harp-tech/device.behavior/Hardware/Mechanical/README.md

## Harp Behavior Mechanical Files
Each folder contains the mechanical designs for each PCB version.

## PCB compatibility

| Folder name			| PCB version		| Notes				|
|---|---|---|
| **case_v1.1_v1.2**	| 1.1 and 1.2		|					|
| **case_v2.0** 	| 2.0 		|					|

## Licensing ##

<br />This work is licensed under a <a rel="license" href="http://creativecommons.org/licenses/by-sa/4.0/">Creative Commons Attribution-ShareAlike 4.0 International License</a>
