harp-tech/device.behavior/docs/apidoc/Harp_Behavior_CreateCamera0FrequencyPayload.md

---
uid: Harp.Behavior.CreateCamera0FrequencyPayload
---

### Configure trigger frequency

:::workflow
Configure trigger frequency
:::
