harp-tech/device.behavior/docs/apidoc/Harp_Behavior_CreateDisableServosPayload.md

---
uid: Harp.Behavior.CreateDisableServosPayload
---

### Enable and disable servos

:::workflow
Enable and disable servos
:::
