harp-tech/device.behavior/docs/apidoc/Harp_Behavior_CreatePulseSupplyPort0Payload.md

---
uid: Harp.Behavior.CreatePulseSupplyPort0Payload
---

### Deliver rewards

:::workflow
Deliver rewards
:::
