harp-tech/device.behavior/docs/apidoc/Harp_Behavior_EnableEncoders.md

---
uid: Harp.Behavior.EnableEncoders
---

### Enable the encoder

:::workflow
Enable the encoder
:::
