harp-tech/device.behavior/docs/apidoc/Harp_Behavior_Led0Current.md

---
uid: Harp.Behavior.Led0Current
---

### Configure LED current

:::workflow
Configure LED current
:::
