harp-tech/device.behavior/docs/apidoc/Harp_Behavior_Led0MaxCurrent.md

---
uid: Harp.Behavior.Led0MaxCurrent
---

### Configure LED current

:::workflow
Configure LED current
:::
