harp-tech/device.behavior/docs/apidoc/Harp_Behavior_Led1Current.md

---
uid: Harp.Behavior.Led1Current
---

### Configure LED current

:::workflow
Configure LED current
:::
