harp-tech/device.behavior/docs/apidoc/Harp_Behavior_MimicPort2Valve.md

---
uid: Harp.Behavior.MimicPort2Valve
---

### Enable poke valve mimic

:::workflow
Enable poke valve mimic
:::
