harp-tech/device.behavior/docs/apidoc/Harp_Behavior_PwmStop.md

---
uid: Harp.Behavior.PwmStop
---

### Start and stop PWM

:::workflow
Start and stop PWM
:::
