harp-tech/device.behavior/docs/apidoc/Harp_Behavior_ServoMotor3Pulse.md

---
uid: Harp.Behavior.ServoMotor3Pulse
---

### Configure the servo

:::workflow
Configure the servo
:::

### Adjust the position

:::workflow
Adjust the position
:::
