harp-tech/device.behavior/docs/articles/control-leds.md

# Control LEDs

The Behavior device controls two kinds of light output: conventional LEDs on the **L0** and **L1** connectors and addressable RGB LEDs on the **RGB** connector. Refer to the [LED connection](./ports-connections.md?tabs=led#connections) section to set up a conventional LED on **L0** and the [RGB LED connection](./ports-connections.md?tabs=rgb-led#connections) section to set up two addressable RGB LEDs on the **RGB** connector. We will use these ports for the rest of these examples.

This article covers configuring the LED current, setting RGB colors, and turning on both kinds of LED in Bonsai.

The complete workflow is shown below. Copy and paste it into Bonsai to get started immediately, or build each section by following the step-by-step instructions in the following sections.

:::workflow
Control LEDs
:::

## Configure LED current

The **L0** and **L1** outputs supply conventional LEDs with a configurable constant current, so no series resistor is needed. Each output line has a working current and protection limit register (e.g. [`Led0Current`] and [`Led0MaxCurrent`] for **L0**) that are set before turning on the LED. Set the protection limit to the LED's rated current first, then adjust the working current to change the brightness of the LED.

:::workflow
Configure LED current
:::

- Insert a [`KeyDown`] operator and set the `Filter` property to `A`.
- Insert a [`CreateMessage`] operator and configure the following properties:
    - `Payload` - Select `Led0MaxCurrentPayload`.
    - `Led0MaxCurrent` - Set the maximum allowed current according to the rating of the LED in mA (e.g. `20`). Valid values are 5–100 mA.
- Insert a [`MulticastSubject`] operator named `Behavior Commands`.
- Insert a [`CreateMessage`] operator and configure the following properties:
    - `Payload` - Select `Led0CurrentPayload`.
    - `Led0Current` - Set the working current in mA (e.g. `10`). Valid values are 2–100 mA.
- Insert a [`MulticastSubject`] operator named `Behavior Commands`.

Run the workflow and press <kbd>A</kbd> to configure the **L0** supply current, then switch the output on as shown in the next section.

> [!NOTE]
> Commands that adjust the working current above the protection limit will be rejected by the device. The Bonsai workflow will terminate with a runtime error that describes an "erroneous write command". Lower the working current or raise the protection limit, then restart the workflow.

## Turn LEDs on and off

Once the current is configured, the **L0** and **L1** outputs are controlled like any other digital output (see [Control digital outputs](control-digital-outputs.md)), for instance through the [`OutputSet`] and [`OutputClear`] registers:

:::workflow
Turn LEDs on and off
:::

- Insert a [`KeyDown`] operator and set the `Filter` property to `S`.
- Insert a [`CreateMessage`] operator and configure the following properties:
    - `Payload` - Select `OutputSetPayload`.
    - `OutputSet` - Select the line to turn on (e.g. `Led0`).
- Insert a [`MulticastSubject`] operator named `Behavior Commands`.

In a separate branch:

- Insert a [`KeyDown`] operator and set the `Filter` property to `D`.
- Insert a [`CreateMessage`] operator and configure the following properties:
    - `Payload` - Select `OutputClearPayload`.
    - `OutputClear` - Select the line to turn off (e.g. `Led0`).
- Insert a [`MulticastSubject`] operator named `Behavior Commands`.

Run the workflow, then press <kbd>S</kbd> to turn on the LED and <kbd>D</kbd> to turn it off.

## Set RGB colors

When configuring and controlling the addressable RGB LEDs; **Rgb0** refers to the first LED in the chain and **Rgb1** the second. The [`RgbAll`] register writes the color of both RGB LEDs in one command. Each channel takes an intensity from 0 to 255.

:::workflow
Set RGB colors
:::

- Insert a [`KeyDown`] operator and set the `Filter` property to `F`.
- Insert a [`CreateMessage`] operator and configure the following properties:
    - `Payload` - Select `RgbAllPayload`.
    - `Red0` - Set the intensity value for the red channel on **Rgb0** (e.g. `255`).
    - `Blue1` - Set the intensity value for the blue channel on **Rgb1** (e.g. `255`).
- Insert a [`MulticastSubject`] operator named `Behavior Commands`.

Run the workflow and press <kbd>F</kbd> to load the color and intensity configuration. If the LEDs are currently on, the new configurations take effect immediately. If not, when you turn them on in the next section, **Rgb0** should display red and **Rgb1** should be blue.

> [!NOTE]
> To configure one LED at a time, select [`Rgb0`] for the first LED or [`Rgb1`] for the second LED under the `Payload` property in the [`CreateMessage`] operator.

## Turn RGB LEDs on and off

The RGB LEDs are controlled like any other digital output (see [Control digital outputs](control-digital-outputs.md)), for instance through the [`OutputSet`] and [`OutputClear`] registers:

:::workflow
Turn RGB LEDs on and off
:::

- Insert a [`KeyDown`] operator and set the `Filter` property to `G`.
- Insert a [`CreateMessage`] operator and configure the following properties:
    - `Payload` - Select `OutputSetPayload`.
    - `OutputSet` - Set the lines to turn on (e.g. `Rgb0, Rgb1`).
- Insert a [`MulticastSubject`] operator named `Behavior Commands`.

In a separate branch:

- Insert a [`KeyDown`] operator and set the `Filter` property to `H`.
- Insert a [`CreateMessage`] operator and configure the following properties:
    - `Payload` - Select `OutputClearPayload`.
    - `OutputClear` - Set the lines to turn off (e.g. `Rgb0, Rgb1`).
- Insert a [`MulticastSubject`] operator named `Behavior Commands`.

Run the workflow, then press <kbd>G</kbd> to turn on both RGB LEDs and <kbd>H</kbd> to turn them off.

[!INCLUDE [](../includes/version-footer.md)]

<!--Reference Style Links -->
[`KeyDown`]: xref:Bonsai.Windows.Input.KeyDown
[`CreateMessage`]: xref:Harp.Behavior.CreateMessage
[`MulticastSubject`]: xref:Bonsai.Expressions.MulticastSubject
[`RgbAll`]: xref:Harp.Behavior.RgbAll
[`Rgb0`]: xref:Harp.Behavior.Rgb0
[`Rgb1`]: xref:Harp.Behavior.Rgb1
[`Led0Current`]: xref:Harp.Behavior.Led0Current
[`Led1Current`]: xref:Harp.Behavior.Led1Current
[`Led0MaxCurrent`]: xref:Harp.Behavior.Led0MaxCurrent
[`OutputSet`]: xref:Harp.Behavior.OutputSet
[`OutputClear`]: xref:Harp.Behavior.OutputClear
