harp-tech/device.behavior/docs/articles/ports-connections.md

# Ports and connections

This article covers the ports on the Behavior device, as well as how to connect the device to peripherals and external devices.

## Ports

Harp Behavior device pinout

**12V PWR (Barrel Jack)** - This port powers the Behavior device and requires a 12 V power supply.

**USB (USB-C)** - This port connects the device to the control computer running [Bonsai](bonsai.md) or the [Behavior app](./behavior-app.md).

**CLKIN (Stereo Jack)** - This [Harp](https://harp-tech.org/articles/about.html) clock input accepts a clock output from any compatible Harp clock generator or synchronizer (e.g. [Harp Timestamp Generator](https://github.com/harp-tech/device.timestampgeneratorgen3)) for synchronization with other connected devices.

**STATE** - This status LED cycles on and off with a period of:
- 2 seconds when it's communicating with Bonsai
- 4 seconds when in standby
- 100 milliseconds when a catastrophic error occurs

**P0, P1, P2 (RJ45)** - These poke ports interface directly with the [Mice Poke](./peripherals/micepoke.md) peripheral for poke detection and reward delivery. Alternatively, use the [Breakout](./peripherals/breakout.md) board to interface with other accessories. Port **P2** also has a quadrature counter for [rotation tracking](track-rotary-encoder.md). Use it with the [Rotary Encoder](./peripherals/rotaryencoder.md) peripheral, or with a quadrature encoder connected through the Breakout board.

**ADC (Screw Terminal)** - This connector carries the first analog input (**AD0**), a 5 V supply pin and two ground connections.

**Output (Screw Terminal)** - These general-purpose 5 V digital outputs can be used to communicate with external devices. **DO0**/**DO1** can generate [camera triggers](trigger-cameras.md) and **DO2**/**DO3** can control [servo motors](control-servo-motors.md); all four support [PWM](generate-pwm.md).

**Input (Screw Terminal)** - This connector carries the second analog input (**AD1**), the digital input **DI3** and one ground connection.

**RGB (3-pin Flick Lock)** - Connector for up to two  addressable RGB LEDs (WS2812-type, e.g., NeoPixels). The LEDs are controlled as a serial chain on a single data line, with colors set with the [RGB registers](control-leds.md#set-rgb-colors).

**L0, L1 (Screw Terminal)** - These connectors control two conventional single-color LED outputs. Each terminal pair is marked **A** (anode, the LED's long leg) and **K** (cathode, the short leg). The output current is [configurable](control-leds.md) from 2 to 100 mA.

## Connections

# [Analog input](#tab/analoginput)

Analog input

1. Wire the analog signal (0–5 V) to either **AD0** on the **ADC** connector or **AD1** on the **Input** connector.
2. Connect the ground wire to any **GND** pin.
3. Refer to the [Acquire analog data](acquire-analog-data.md) article to read the signal in Bonsai.

# [Digital input](#tab/digitalinput)

Digital input

1. Wire the digital signal (5 V) to **DI3** on the **Input** connector. Alternatively, use the [Breakout](./peripherals/breakout.md) board to access more digital inputs on the poke ports.
2. Connect the ground wire to any **GND** pin.
3. Refer to the [Read digital inputs](read-digital-inputs.md) article to visualize the input events in Bonsai.

# [Digital output](#tab/digitaloutput)

Digital output

To connect a logic-level output to an external device:

1. Wire a digital output from **DO0**–**DO3** on the **Output** connector to the external device's digital input. Alternatively, use the [Breakout](./peripherals/breakout.md) board to access more digital outputs on the poke ports.
2. Connect the external device's ground to any **GND** pin.
3. Refer to the [Control digital outputs](control-digital-outputs.md) article to output digital events in Bonsai.

Digital output load

To connect a load such as a conventional LED:

1. Wire a digital output from **DO0**–**DO3** on the **Output** connector to one end of a series current-limiting resistor (100 to 330 Ω is typically used).
2. Wire the other end of the resistor to the long leg (anode, **A**) of the LED.
3. Wire the short leg (cathode, **K**) of the LED to any **GND** pin.
4. Refer to the [Control digital outputs](control-digital-outputs.md) article to control the output in Bonsai.

> [!NOTE]
> Conventional LEDs can also be connected on the **L0**/**L1** connector, where the current is configurable and no series current-limiting resistor is needed.

# [Photodiode](#tab/photodiode)

Photodiode analog reading

Before connecting the [Photodiode](./peripherals/photodiode.md) peripheral, insert the stereo plug cable into the stereo jack on the peripheral. The other end of the cable has three color-coded wires for the signal, 5 V supply and ground.

For an analog reading:

1. Use the switch on the side of the casing to select **ANA**.
2. Wire the signal wire to either **AD0** on the **ADC** connector or **AD1** on the **Input** connector.
3. Connect the ground wire to any **GND** pin.
4. Wire the supply wire to the **+5V** pin on the **ADC** connector.
5. Refer to the [Acquire analog data](acquire-analog-data.md) article to read the light intensity as an analog reading in Bonsai.

Photodiode digital reading

For a digital reading:

1. Use the switch on the side of the casing to select **DIG**.
2. Wire the signal wire to **DI3** on the **Input** connector. Alternatively, use the [Breakout](./peripherals/breakout.md) board to access more digital inputs on the poke ports.
3. Connect the ground wire to any **GND** pin.
4. Wire the supply wire to the **+5V** pin on the **ADC** connector.
5. Refer to the [Read digital inputs](./read-digital-inputs.md) article to read the light intensity as a digital input reading in Bonsai.
6. Turn the adjustment screw on the side of the Photodiode casing to tune the light threshold for the low and high state of the digital output and monitor the response in Bonsai.

> [!NOTE]
> Third-party photodiode modules that are powered with 5 V and output a 0 to 5 V signal can be wired the same way.

# [Speaker](#tab/speaker)

Speaker

1. Wire the **+** terminal of the [Speaker](./peripherals/speaker.md) peripheral to one of **DO0**–**DO3** on the **Output** connector.
2. Wire the **-** terminal to any **GND** pin.
3. Refer to the [Generate PWM](generate-pwm.md) article to play tones in Bonsai.

> [!NOTE]
> Third-party passive buzzers or speakers can be controlled with PWM in the same way as the Speaker peripheral. Active buzzers generate a fixed tone, so switch them on and off using general purpose digital outputs, instead of PWM (see [Control digital outputs](control-digital-outputs.md)). Add a current-limiting series resistor (100 to 330 Ω is typically used) to avoid overloading the 5 V supply.

# [LED](#tab/led)

LED

1. Wire the long leg (anode, **A**) of a conventional single-color LED to the **A** pin of either the **L0** or **L1** terminal pair. No series current-limiting resistor is needed as the supply current can be set in Bonsai.
2. Wire the short leg (cathode, **K**) to the **K** pin of the same terminal pair.
3. Refer to the [Control LEDs](control-leds.md) article to configure and switch the LEDs in Bonsai.

# [RGB LED](#tab/rgbled)

RGB LED

1. Connect the signal wire of an addressable RGB LED to **S** on the **RGB** connector. Analog RGB LEDs are not supported.
2. Connect its ground wire to **G**.
3. Connect its power wire to **5V**.
4. Up to two RGB LEDs can be controlled. Connect the second one as a serial chain with the same wiring configuration.
5. Refer to the [Control LEDs](control-leds.md#set-rgb-colors) article to set the colors and switch the RGB LEDs in Bonsai.

> [!NOTE]
> The **RGB** connector is a 2.54 mm Molex KK header with a friction lock. You can assemble a mating connector with a Molex KK crimp housing (22-01-3037) and three crimp terminals (08-50-0160). Dupont style female jumper wires also fit, but without a latch they hold by friction alone.

# [Mice Poke](#tab/poke)

Mice Poke

1. Connect the [Mice Poke](./peripherals/micepoke.md) peripheral to port **P0**, **P1**, or **P2** with an RJ45 cable.
2. If you are using a variant of the Mice Poke peripheral with the integrated water valve, connect the valve's inlet to the liquid container with tubing.
3. Refer to the [Control poke peripheral](control-poke.md) article to configure and use the Mice Poke peripheral in Bonsai.

No further wiring is necessary. The screw terminal blocks are only needed for external use; they share the same connections that are carried by the RJ45 connector.
Use them to connect an extra sensor, wire a solenoid valve, add an additional cue LED, or log the peripheral signals.

To connect a sensor like a lever:

1. Wire one contact of the lever switch to **DIO1**. This line is not connected to any of the sensors onboard the Mice Poke Peripheral and can be used as an active-low digital input (the functionality to toggle it to digital output has not been added yet).
2. Wire the other end of the lever switch to **GND**. 
3. Refer to the [Read digital inputs](read-digital-inputs.md#visualize-port-dio-events) article to read the signal in Bonsai.

To wire a solenoid valve for reward delivery (for Mice Poke variants without integrated water valves):

1. Wire a 12 V solenoid valve across the terminal pair. For standard coil-only solenoid valves, polarity does not matter.

To add an additional cue LED (for instance, at a different location):

1. Wire the long leg (anode) of an LED to the **LED** terminal. No series current-limiting resistor is needed as the terminal already has one.
2. Wire the short leg (cathode) to any **GND** terminal.
3. The additional cue light is controlled by the same signals as the onboard cue LEDs, refer to the [Control poke LEDs](control-poke.md#control-poke-leds) article to control them in Bonsai.

To log the peripheral signals on an external device:

1. Wire the signals (5 V logic) to digital inputs on the external device:
    - **IR LED** - Reports the status of the onboard infrared beam emitter.
    - **IR PHT** - Reports the status of the onboard infrared photodetector.
    - **LED** - Reports the status of the [onboard cue LEDs](control-poke.md#control-poke-leds).
2. Share ground between the external device and any **GND** terminal.

# [Rotary Encoder](#tab/encoder)

Rotary Encoder

1. Connect the [Rotary Encoder](./peripherals/rotaryencoder.md) peripheral to port **P2** with an RJ45 cable. This is the only port with the quadrature counter functionality.
2. Refer to the [Track rotary encoder](track-rotary-encoder.md) article to read the encoder in Bonsai. 

No further wiring is necessary to use the encoder with the Behavior device. The solder pads are only needed to access the raw quadrature signals for logging.

To log the raw quadrature signals:

1. Wire the **A** quadrature signal (5 V logic) to a  digital input on the external device.
2. Wire the **B** quadrature signal (5 V logic) to a  digital input on the external device.
3. Share ground between the external device and the **-** pad.

> [!NOTE]
> The Harp Behavior Rotary Encoder is meant to demonstrate simple rotational tracking. For applications in which high resolution tracking is needed, such as a running wheel, use a more precise quadrature encoder. We also recommend using the [Breakout](./peripherals/breakout.md) board instead of the solder pads on this peripheral for an easier connection with external quadrature encoders.

# [Camera](#tab/camera)

Camera

1. Check the camera specifications to ensure it has GPIO (general purpose input/output) and individual frame triggering capabilities.
2. Refer to the camera manual to understand the connector pinout of the specific model you have. Locate a connector pin that can be configured as a digital input line for that camera. Locate its corresponding ground pin.
3. Check that the camera input is compatible with the 5 V trigger signal from the Behavior device. For cameras with lower-voltage trigger inputs (e.g. 1.8 V or 3.3 V logic), add a level shifter between the output and the camera.
4. Using the camera vendor's software, configure the camera to use the digital input line corresponding to the input pin you selected. Set the image capture mode to use the rising edges of the incoming pulse to trigger each frame capture.
5. Insert the appropriate cable that mates with the connector on the camera and provides wire terminals for the connections.
6. Connect the camera's digital input pin you selected to **DO0** or **DO1** on the **Output** connector. These are the only ports that support the camera trigger functionality. 
7. Connect the camera's ground pin corresponding to the digital input pin you selected to any **GND** pin.
8. Refer to the [Trigger cameras](trigger-cameras.md) article to configure, start and stop the trigger in Bonsai.

# [Servo](#tab/servo)

Servo

1. Connect the servo signal wire to **DO2** or **DO3** on the **Output** connector. These are the only ports that support the servo functionality.
2. Connect the servo power wire to the **+5V** pin on the **ADC** connector. Alternatively, use the [Breakout](./peripherals/breakout.md) board to access more power pins on the poke ports. For servos that draw more than 200 mA, or that require a supply voltage other than 5 V, power the servo from an external supply matching its rating instead. Never connect the external supply to the Behavior device's 5 V pin; it must power the servo only.
3. Connect the servo ground wire to a **GND** pin. For servos requiring an external power supply, connect the external supply's ground to a **GND** pin.
4. Refer to the [Control servo motors](control-servo-motors.md) article to move the servo in Bonsai.

# [Breakout](#tab/breakout)

Breakout

This section describes the connections required for different uses of the [Breakout](./peripherals/breakout.md) board. Note that some functionality is only available in specific versions of the Breakout board.

To connect digital inputs and outputs (both v1.1 and v2.x):
1. Connect the Breakout board to port **P0**, **P1**, or **P2** with an RJ45 cable.
2. Wire the signal wire from external devices to the **DI**, **DIO**, or **DO** screw terminals.
3. Wire the external device's ground to a **GND** terminal.
4. If the external device needs power, wire its supply to the **+5V** terminal.
5. Refer to the [Read digital inputs](read-digital-inputs.md) and [Control digital outputs](control-digital-outputs.md) articles to use these lines in Bonsai.

To connect an external quadrature encoder (both v1.1 and v2.x):
1. Connect the Breakout board to port **P2** with an RJ45 cable. The quadrature counter is only available on this port.
2. Wire the encoder's **A** channel to the **DI** terminal. Both channels must be 5 V logic.
3. Wire the encoder's **B** channel to the **DIO** terminal.
4. Wire the encoder's ground to a **GND** terminal.
5. Wire the encoder's supply to the **+5V** terminal. For encoders that require a different supply voltage, power the encoder from an external supply instead and share only its ground with the **GND** terminal.
6. Leave any index (**Z**) output of the encoder unconnected as the Behavior device does not support it.
7. Refer to the [Track rotary encoder](track-rotary-encoder.md) article to read the encoder in Bonsai. If the count runs in the opposite direction to the rotation, swap the **A** and **B** wires.

To control valves for reward delivery (v1.1 only):
1. Connect the [Breakout](./peripherals/breakout.md) board to port **P0**, **P1**, or **P2** with an RJ45 cable.
2. Wire a 12 V solenoid valve between the **+12V** and **SUP_RTN** terminals.
3. Refer to [Deliver rewards on poke](control-poke.md#deliver-rewards-on-poke) to pulse the valve line in Bonsai.

To stream the serial timestamp (v2.x only):
1. Connect the board to **P2**, the timestamp stream can only be transmitted on this port.
2. Wire the **TX** terminal to the receiving device's **RX** input or to a logged digital input.
3. Wire a **GND** terminal to the receiver's ground.
4. Set the Breakout board's logic-level jumper to match the receiver's operating voltage level (3.3 V or 5 V).
5. Refer to the [Transmit serial timestamps](advanced-configuration.md#transmit-serial-timestamps) section to enable the stream in Bonsai.

# [Harp synchronization](#tab/harpsynchronization)

Harp synchronization

1. Connect a **CLKOUT** of a Harp clock generator (e.g. the [Harp Timestamp Generator](https://github.com/harp-tech/device.timestampgeneratorgen3)) to the **CLKIN** jack with a stereo plug cable.
2. The Behavior device adopts the generator's clock automatically. To verify the connection, check that the **STATE** LEDs of the connected boards blink simultaneously.
3. Refer to the [Harp synchronization clock](https://harp-tech.org/protocol/SynchronizationClock.html) documentation for how devices synchronize.

---

[!INCLUDE [](../includes/version-footer.md)]
