harp-tech/device.behavior/docs/articles/behavior.md

---
title: Device
---

# Behavior device

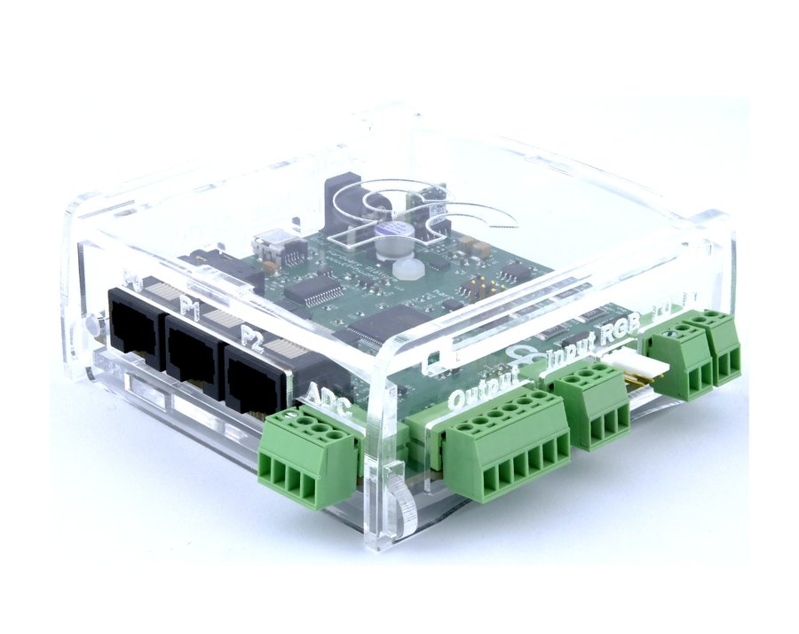
[picture p3: docs/images/behavior-board.jpg]
Harp Behavior


## Key features

- 3 ports for plug-and-play mice pokes.
- Hardware-timed pulses for all digital outputs and PWM for the four digital outputs on the **Output** connector.
- Support for camera triggering, servo motor control, and quadrature encoder counting on selected digital outputs.
- Configurable LED drive current (up to 100 mA) and RGB LED driver.

## Specs

- Analog inputs: 2 (0–5 V, 12-bit, sampled at 1 kHz)
    - 1 on the **ADC** connector
    - 1 on the **Input** connector
- Digital inputs: 7 (5 V)
    - 3 general-purpose and 3 active-low digital inputs on the poke ports accessible with the [Breakout](./peripherals/breakout.md) board
    - 1 on the **Input** connector
- Digital outputs: 7 (5 V)
    - 4 on the **Output** connector
    - 3 on the poke ports, accessible with the [Breakout](./peripherals/breakout.md) board
- Digital output pulse duration: 1–65535 ms (supported on all digital outputs)
- Digital output PWM: 1–10000 Hz, duty cycle 1–99% (supported on the **Output** connector only)
- Digital output drive current: Up to 300 mA per line, total 500 mA across outputs
- Poke ports: 3 (RJ45)
    - For the [Mice Poke](./peripherals/micepoke.md), [Rotary Encoder](./peripherals/rotaryencoder.md), or [Breakout](./peripherals/breakout.md) board
- LED outputs: 2 (2–100 mA drive current)
- RGB LED outputs: 2 (WS2812-type addressable LED connector, driven as a serial chain)
- Camera triggers: 2 (**DO0**/**DO1**, 2–600 Hz)
- Servo outputs: 2 (**DO2**/**DO3**)
- Quadrature encoder inputs: 1 (**P2**, sampled at 1 kHz)
- Timestamp resolution: 32 µs
- Synchronization frequency: 1 Hz
- Synchronization accuracy: 22 ± 16 µs (between clock generator and this device)

## Hardware

| Version | Notes |
| --- | ----- |
| 2.1 | <ul><li> Changed USB connector from Mini-B to USB-C </li></ul> |
| 2.0 | <ul><li> Added an input connector with an extra analog input and digital input. </li></ul> |
| 1.1 | <ul><li> Initial version </li></ul> |

## Firmware

| Version | Notes |
| --- | ----- |
| 3.3 | <ul><li> Fixed the read function of the digital inputs register </li></ul> |
| 3.2 | <ul><li> Add limits to ServoMotor registers </li><li> Create displacement reading option for quadrature encoder. </li></ul> |
| 3.1 | <ul><li> Support for hardware 2.0 </li><li> Added serial timestamp registers </li></ul> |
| 3.0 | <ul><li> Initial version </li></ul> |

[!INCLUDE [](../includes/version-footer.md)]
