harp-tech/device.behavior/docs/articles/generate-pwm.md

# Generate PWM

The four general-purpose outputs **DO0**–**DO3** can generate hardware-timed pulse-width modulation (PWM) signals. The PWM signal can be demonstrated with either a [speaker](./peripherals/speaker.md) (where the frequency controls the pitch) or an LED (where the duty cycle controls the brightness). Refer to the [connections](./ports-connections.md?tabs=speaker#connections) article to set up either a speaker or conventional LED on **DO0**, which we will use for the rest of these examples.

This article covers how to configure the frequency and duty cycle, as well as how to generate and stop the PWM in Bonsai.

The complete workflow is shown below. Copy and paste it into Bonsai to get started immediately, or build each section by following the step-by-step instructions in the following sections.

:::workflow
Generate PWM
:::

## Configure PWM

Each output line has its own frequency and duty cycle registers, for instance [`PwmFrequencyDO0`] and [`PwmDutyCycleDO0`] for **DO0**. Configure these registers before starting the PWM signal.

:::workflow
Configure PWM
:::

- Insert a [`KeyDown`] operator and set the `Filter` property to `A`.
- Insert a [`CreateMessage`] operator and configure the following properties:
    - `Payload` - Select `PwmFrequencyDO0Payload`.
    - `PwmFrequencyDO0` - Set the PWM frequency in Hz (e.g. 1000). Valid values are 1 to 10000.
- Insert a [`MulticastSubject`] operator named `Behavior Commands`.
- Insert a [`CreateMessage`] operator and configure the following properties:
    - `Payload` - Select `PwmDutyCycleDO0Payload`.
    - `PwmDutyCycleDO0` - Set the duty cycle in percent (e.g. 50). Valid values are 1 to 99.
- Insert a [`MulticastSubject`] operator named `Behavior Commands`.

Run the workflow and press <kbd>A</kbd> to configure a 1 kHz, 50% duty cycle waveform on **DO0**. Frequency and duty cycle can also be modified while the PWM signal is running.

## Start and stop PWM

Use the [`PwmStart`] and [`PwmStop`] registers to start and stop the waveform on any combination of outputs.

:::workflow
Start and stop PWM
:::

- Insert a [`KeyDown`] operator and set the `Filter` property to `S`.
- Insert a [`CreateMessage`] operator and configure the following properties:
    - `Payload` - Select `PwmStartPayload`.
    - `PwmStart` - Select the line to start PWM on (e.g. `PwmDO0`).
- Insert a [`MulticastSubject`] operator named `Behavior Commands`.

In a separate branch:

- Insert a [`KeyDown`] operator and set the `Filter` property to `D`.
- Insert a [`CreateMessage`] operator and configure the following properties:
    - `Payload` - Select `PwmStopPayload`.
    - `PwmStop` - Select the line to stop PWM on (e.g. `PwmDO0`).
- Insert a [`MulticastSubject`] operator named `Behavior Commands`.

Run the workflow, then press <kbd>S</kbd> to start and <kbd>D</kbd> to stop the waveform on **DO0**.

## Generate PWM bursts

To generate a PWM signal for a specified duration, enable the [pulse mode](control-digital-outputs.md#pulse-outputs) on the output with the [`OutputPulseEnable`] register and configure the duration in the appropriate output line pulse duration register (e.g. [`PulseDO0`] for **DO0**).

:::workflow
Generate PWM bursts
:::

- Insert a [`KeyDown`] operator and set the `Filter` property to `F`.
- Insert a [`CreateMessage`] operator and configure the following properties:
    - `Payload` - Select `OutputPulseEnablePayload`.
    - `OutputPulseEnable` - Select the line to enable the PWM pulse on (e.g. `DO0`).
- Insert a [`MulticastSubject`] operator named `Behavior Commands`.
- Insert a [`CreateMessage`] operator and configure the following properties:
    - `Payload` - Select `PulseDO0Payload`.
    - `PulseDO0` - Set the burst duration in ms (e.g. `100`).
- Insert a [`MulticastSubject`] operator named `Behavior Commands`.

Run the workflow, press <kbd>F</kbd> once to configure the pulse, then press <kbd>S</kbd>. The PWM runs for 100 ms and stops on its own, which translates to either a short beep with a speaker or a brief flash with an LED.

[!INCLUDE [](../includes/outputpulseenable-warning.md)]

[!INCLUDE [](../includes/version-footer.md)]

<!--Reference Style Links -->
[`KeyDown`]: xref:Bonsai.Windows.Input.KeyDown
[`CreateMessage`]: xref:Harp.Behavior.CreateMessage
[`MulticastSubject`]: xref:Bonsai.Expressions.MulticastSubject
[`PwmFrequencyDO0`]: xref:Harp.Behavior.PwmFrequencyDO0
[`PwmDutyCycleDO0`]: xref:Harp.Behavior.PwmDutyCycleDO0
[`PwmStart`]: xref:Harp.Behavior.PwmStart
[`PwmStop`]: xref:Harp.Behavior.PwmStop
[`OutputPulseEnable`]: xref:Harp.Behavior.OutputPulseEnable
[`PulseDO0`]: xref:Harp.Behavior.PulseDO0
