harp-tech/device.behavior/docs/articles/peripherals/speaker.md

# Speaker

The Harp Behavior Speaker is a peripheral that connects to one of the Behavior device's general-purpose digital outputs and turns a PWM signal into an audible tone. Refer to the [connections](../ports-connections.md?tabs=speaker#connections) article to set up the peripheral and the [Generate PWM](../generate-pwm.md) article to use it in Bonsai.

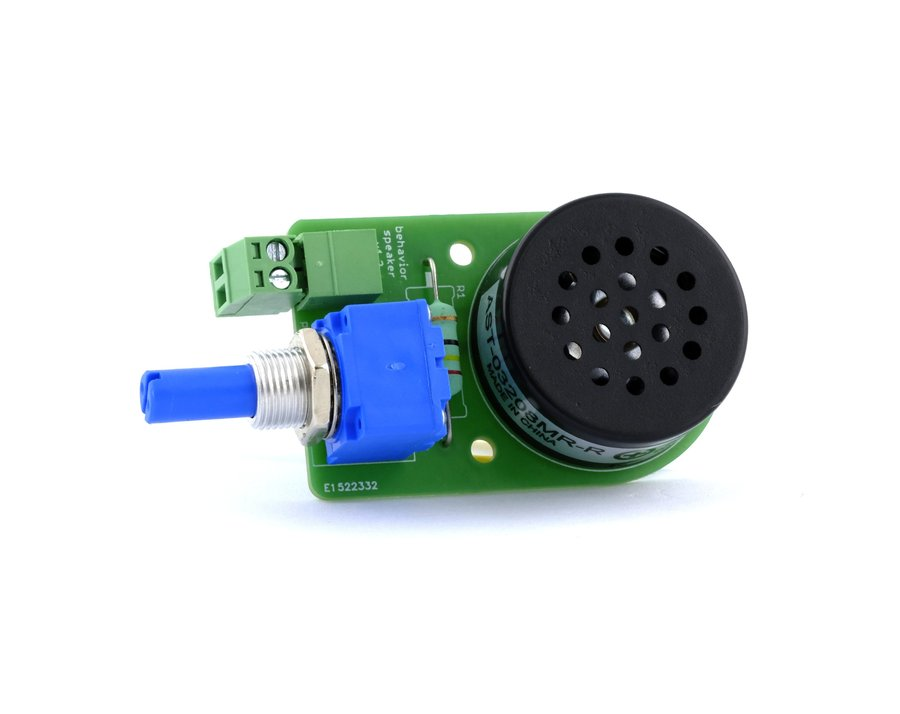
[picture p5: docs/images/peripheral-speaker.jpg]
Speaker


> [!NOTE]
> The Harp Behavior Speaker is meant for playback of simple tones. For audio stimulation with complex stimuli and high precision, consider using the Harp [Sound Card](https://github.com/harp-tech/device.soundcard).

## Key features

- Moving coil speaker driven by a PWM digital output without an amplifier.
- Volume potentiometer to adjust the amplitude.
- Screw terminal for wiring; no soldering needed.

## Specs

- Input signal: 5 V PWM
- Speaker: PUI Audio AST-03208MR-R
- Frequency range: 500 Hz–10 kHz
- Connector: Screw terminal

> [!NOTE]
> While the speaker can go higher in range, the [PWM signal generation](../generate-pwm.md) on the Behavior device has a 10 kHz upper limit.

## Hardware

| Version | Compatible Behavior device | Notes |
| --- | --- | ----- |
| 1.2 | > 1.0 | <ul><li> Fixed the volume direction </li></ul> |
| 1.1 | > 1.0 | <ul><li> Initial version </li></ul> |

Assembled units are available from the [Open Ephys store](https://open-ephys.org/harp).

[!INCLUDE [](../../includes/version-footer.md)]
