harp-tech/device.behavior/Assets/README.md

### Licensing
Copyright Filipe Carvalho 2020

<br />This work is licensed under a <a rel="license" href="http://creativecommons.org/licenses/by/4.0/">Creative Commons Attribution 4.0 International License</a>.

#### You are free to:
*Share* — copy and redistribute the material in any medium or format.

*Adapt* — remix, transform, and build upon the material for any purpose, even commercially.

#### Under the following terms:
*Attribution* — You must give appropriate credit, provide a link to the license, and indicate if changes were made. You may do so in any reasonable manner, but not in any way that suggests the licensor endorses you or your use.
