harp-tech/device.behavior/docs/images/bonsai-firststeps-visualizer.png

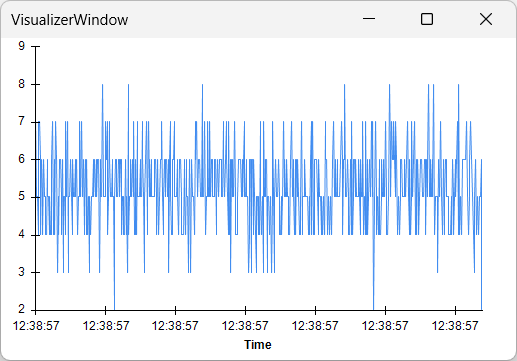
docs/images/bonsai-firststeps-visualizer.png
