harp-tech/device.behavior/docs/images/peripheral-photodiode.jpg

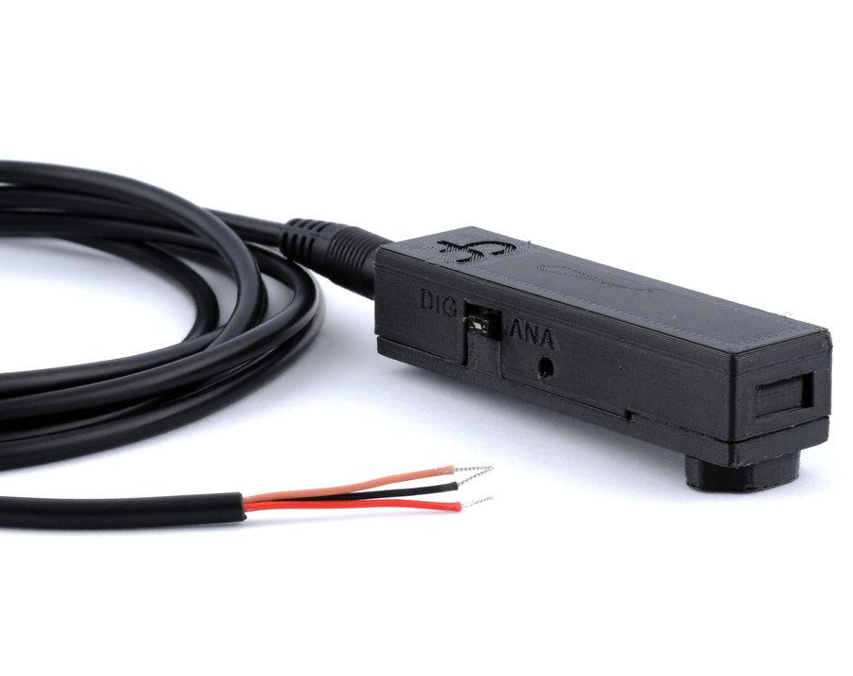
docs/images/peripheral-photodiode.jpg
