harp-tech/device.behavior/Hardware/PCB/harp behavior_BOM.xlsx

Board | Part(s) | Quantity | Description | Distributor | Part. No.
 | IC1 | 1 | ESD Protection Low Cap | Mouser | 511-USBLC6-2SC6Y
 | IC2 | 0 | Conversores CC/CC sem isolação 3-14Vin 0.6-5.5Vout 2A | Mouser | 894-NQR002A0X4Z
 | IC2 | 1 | Conversores CC/CC sem isolação 12Vin, 0.591-6Vout 1.5A, Positive Logic | Mouser | 580-OKR-T/1.5-W12-C
 | IC3, IC9 | 2 | LDO 250mA Ultra-Lo Noise LDO Reg | Mouser | 595-LP5907MFX-3.3NPB
 | IC4 | 1 | IC USB USB to Serial UART Enhanced IC SSOP-28 | Mouser | 895-FT232RL
 | IC5 | 1 | Reguladores de tensão de LDO High PSRR Fast RF High-Enable 1.5A | Mouser | 595-TPS78601DCQR
 | IC6, IC13, IC15, IC17 | 4 | Buffers e line drivers 1.65-5.5V Single Non-Inverting TTL | Mouser | 863-M74VHC1GT50DTT1G
 | IC7 | 1 | Microcontroller ATMEL ATXMEGA128A1U-AU | Mouser | 556-ATXMEGA128A1U-AU
 | IC8, IC11 | 2 | Amplificadores de precisão 50MHz Low Distort Low Noise CMOS Prec | Mouser | 584-AD8651ARZ
 | IC10, IC18 | 2 | Amp Op 2.2V 50MHz Low Noise Single Supply | Mouser | 595-OPA365AIDBVR
 | IC12, IC14, IC16, IC19 | 4 | SingleBuffer / Driver, 1.65V to 5.5V, SOT-23-5 | Mouser | 595-SN74LVC1G125DBVR
 | Q1, Q3 | 2 | DMG1012UW MOSFET N Channel, 1 A, 20 V, 0.3 ohm, 4.5 V, 500 mV | Mouser | 621-DMG1012UW-7
 | Q2, Q4 | 2 | Bipolar (BJT) Single Transistor, NPN, 70 V, 150 MHz, 2 W, 2 A, 500 hFE | Mouser | 522-FZT692BTA
 | Q7, Q8, Q11, Q12 | 4 | MOSFET -60V 2.6A P-Channel SOT-223-3 | Mouser | 863-NTF2955T1G
 | Q5, Q6, Q9, Q10 | 4 | BJT NPN SURFACE MOUNT SMALL SIGNAL TRANS SOT-23-3 | Mouser | 621-BC817-40W-7
 | Q13, Q14, Q15 | 3 | MOSFET 50V N-CH Logic Level SOT-323-3 | Mouser | 512-BSS138W
 | Q16, Q17, Q18 | 3 | MOSFET 60V 3A N-Channel SOT-223-3 | Mouser | 863-NTF3055L108T1G
 | D1, D2, D3, D4 | 4 | DIODE SCHOTTKY 30V 1A SOD323 | Mouser | 621-SDM100K30L-7
 | C17 | 1 | CAP CER 13pF 50V ±5% C0G 0402 | Mouser | 81-GRM1555C1H130JA1D
 | C6, C7 | 2 | CAP CER 47pF 50V ±5% C0G 0402 | Mouser | 77-VJ0402A470JXACBC
 | CUSB | 1 | CAP CER 4.7nF 100V ±10% X7R 0402 | Mouser | 81-GRM155R72A472KA01
 | C41, C42, C50, C51 | 4 | CAP CER 15nF 16V ±5% X7R 0402 | Mouser | 81-GRM155R71C153JA1D
 | C5, C11, C13, C15, C19, C20, C21, C22, C23, C24, C25, C26, C27, C28, C30, C31, C35, C37, C39, C40, C43, C44, C45, C46, C47, C48, C49, C52, C53 | 29 | CAP CER 100nF 10V X5R 0402 | Farnell | 2310530
 | C29, C32 | 2 | CAP CER 0.33uF 10V ±10% X5R 0402 | Mouser | GRM155R61A334KE15D
 | C37, C43 | 0 | CAP CER 1uF 25V ±20% X5R 0402 |  | 81-GRM155R61E105MA2D
 | C12 | 1 | CAP TAN 4.7uF 6.3V ±10% 1206 | Mouser | 80-T491A475K006
 | C10, C14, C16, C18, C33, C36 | 6 | CAP CER 10uF 10V ±10% X5R 0603 | Mouser | 81-GRM188R61A106KE9D
 | C2 | 1 | CAP TAN 22uF 20V ±10% 1210 | Mouser | 667-20TQC22MYFB
 | C1, C4 | 2 | CAP CER 22uF 25V ±10% X5R 1210 | Mouser | 81-GRM32ER61E226KE15
 | C8, C9 | 2 | CAP CER 47uF 10V ±10% X5R 1210 | Mouser | 81-GRM32ER61A476KE20
 | C3 | 1 | CAP ELE 100uF 25V ±20% | Mouser | 667-EEE-FK1E101P
 | R1, R9, R15 | 3 | RES SMD 0Ω OHM 5% 0402 | Mouser | 667-ERJ-2GE0R00X
 | RI1, RI2, RI3, RI4 | 4 | RES SMD 4.99Ω OHM 1% 2512 | Mouser | 71-CRCW25124R99FNEG
 | R11, R20 | 0 | RES SMD 10Ω OHM 5% 0402 | Mouser | 667-ERJ-2GEJ100X
 | R12, R19 | 0 | RES SMD 51Ω OHM 5% 1210 | Mouser | 667-ERJ-P14J510U
 | R8 | 1 | RES SMD 68Ω OHM 5% 0402 | Mouser | 71-CRCW0402-68-E3
 | R7, R11, R20 | 3 | RES SMD 100Ω OHM 1% 0402 | Mouser | 667-ERJ-2RKF1000X
 | R12, R19 | 2 | RES SMD 200Ω OHM 5% 1210 | Mouser | 71-CRCW1210J-200-E3
 | RTRIM | 1 | RES SMD 243Ω OHM 1% 0402 | Mouser | 667-ERJ-2RKF2430X
 | R45, R46, R47 | 3 | RES SMD 330Ω OHM 1% 0402 | Mouser | 667-ERJ-PA2F3300X
 | R16, R18, R21, R22, R27, R28, R33, R34, R35, R36, R37, R38, R48, R49 | 14 | RES SMD 10kΩ 1% 0402 | REEL | REEL
 | R23, R24, R25, R26, R29, R30, R31, R32 | 8 | RES SMD 549Ω 1% 0805 0.5W | Mouser | ERJ-P06F5490V
 | R14, R51 | 2 | RES SMD 15kΩ 1% 0402 | Mouser | 667-ERJ-2RKF1502X
 | R13, R50 | 2 | RES SMD 24kΩ 1% 0402 | Mouser | 667-ERJ-2RKF2402X
 | R6 | 1 | RES SMD 30.9kΩ 1% 0402 | Mouser | 71-CRCW0402-30.9K-E3
 | R5 | 1 | RES SMD 95.3kΩ 1% 0402 | Mouser | 667-ERJ-2RKF9532X
 | R10, R17, R39, R40, R41, R42, R43, R44, R52 | 9 | RES SMD 100kΩ 1% 0402 | REEL | REEL
 | RUSB | 1 | RES SMD 1MΩ 1% 0402 | Mouser | 652-CR0402FX-1004GLF
 | STATE | 1 | LED, Green, 1.6mm x 0.8mm, 566 nm, 2.1 V, 20 mA, 15 mcd | Mouser | 78-TLMP1100-GS08
 | OSC1 | 1 | 32MHz 10ppm | Mouser | 998-1001CI5032.0000T
 | CLKIN | 1 | SMT 3.5 STEREO REEL | Mouser | 502-35RASMT2BHNTRX
 | L1 | 1 | Indutores fixos LPS4012 Low Profile 1.5uH 2.2A 20% SMD | Mouser | 994-LPS4012-152MRB
 | L2 | 1 | 40ohms 100MHz 1.5A Monolithic 0805 SMD | Mouser | 875-MI0805K400R-10
 | L3, L4 | 2 | FERRITE BEAD 600Ω 500mA 300mΩ 0805 | Mouser | 875-HZ0805E601R-10
 | PDI | 1 | 6P DR UNSHRD HRD | Mouser | 649-67996-206HLF
 | J2, J3, J4 | 3 | Conectores modulares/Conectores de Ethernet 8/8 R/A MOD JACK | Mouser | 571-2158771
 | USB | 1 | UX60-MB-5S8 | Mouser | 798-UX60-MB-5S8
 | JACK | 1 | CC PCB 2.1MM | Mouser | 163-179PH-EX
 | J1 | 1 | Right Angle, 2.54 mm, 3 Contacts, Header, KK 7395 Series, Through Hole | Farnell | 1360143
 | X1, X2 | 2 | Horizontal, Header, 3.5 mm, 2 Ways, 10 A, 250 V, Through Hole Right Angle | Farnell | 20.155MH/2-E
 | X3 | 1 | Horizontal, Header, 3.5 mm, 3 Ways, 10 A, 250 V, Through Hole Right Angle | Farnell | 20.155MH/3-E
 | X4 | 1 | Horizontal, Header, 3.5 mm, 5 Ways, 10 A, 250 V, Through Hole Right Angle | Farnell | 20.155MH/5-E
 | X5 | 1 | Horizontal, Header, 3.5 mm, 4 Ways, 10 A, 250 V, Through Hole Right Angle | Farnell | 20.155MH/4-E
 | Components | 167
 | PCB |  | 83.5mmx83.5mm
 |  | 1 | VER12US120-JA - AC/DC Power Supply, Class II, Fixed, 1 Output, 90 V, 264 V, 12 W, 12 V | Farnell | 2524430
 |  | 2 | 20.1550M/2-E - Pluggable Terminal Block, 3.5 mm, 2 Ways | Farnell | 2575215
 |  | 1 | 20.1550M/3-E - Pluggable Terminal Block, 3.5 mm, 3 Ways | Farnell | 2575216
 |  | 1 | 20.1550M/5-E - Pluggable Terminal Block, 3.5 mm, 5 Ways | Farnell | 2575218
 |  | 1 | 20.1550M/4-E - Pluggable Terminal Block, 3.5 mm, 4 Ways | Farnell | 2575217
 |  | 1 | LED CML LIGHTPIPE | Mouser | 606-7513D2-L
 | Licensed under the TAPR Open Hardware License (www.tapr.org/OHL)
 | Copyright 2021 Artur Silva and Filipe Carvalho
