harp-tech/device.behavior/(threads)

Thread 13 (2023-09-01):

ServoMotorXPulse should have information regarding minimum and maximum values

bruno-f-cruz, 2023-09-01:
https://github.com/harp-tech/device.behavior/blob/3ff429b3e19bee1c451059667a372b393c7d10bd/device.yml#L343

Currently, when certain values are passed (e.g. <5 ) the board returns an error message.

filcarv, 2023-09-06:
These are the current limits running in firmware:

REG_MOTOR_OUT2_PERIOD   if (reg < 2 || reg > 65534)
REG_MOTOR_OUT2_PULSE    if (reg < 6 || reg > 65530)

REG_MOTOR_OUT3_PERIOD   if (reg < 2 || reg > 65534)
REG_MOTOR_OUT3_PULSE    if (reg < 6 || reg > 65530)

Closed 2023-09-08.

Thread 15 (2023-10-16):

Current high-level interface is not compatible with Behavior v1 boards

glopesdev, 2023-10-16:
@filcarv @artursilva0 Is this something that we decided to solve in firmware for the older boards? One approach could be to always return the 3 values, but leave the new ADC at zero for hardware version 1 boards.

glopesdev, 2023-10-16:
This is solved for firmware releases greater or equal than [fw3.0-harp1.10](https://github.com/harp-tech/device.behavior/releases/tag/fw3.0-harp1.10). The additional ADC is always returned at zero for boards without it.

Closed 2023-10-16.

Thread 17 (2024-01-04):

Consider adding DigitalOutputState event to track pulse mode falling edges

bruno-f-cruz, 2024-01-04:
If an output is set to pulse mode, the onset of the pulse can be timestamped using the write of the OutputSet register. However, there is currently no way to recover the precise event of when the falling edge occurred. It might be interesting to find a way to report this information. I propose co-opting the existing DigitalOutputState and additionally make it an event that behaves identically to DigitalInputState (ie emits a message on any pin change). This event might be omitted on writes to the same register.

Thread 18 (2024-05-02):

Undocumented event from `StopCameras` register

bruno-f-cruz, 2024-05-02:
When analyzing some of the data from an experiment, we identified a EVENT type message from register `StopCameras`. This raises a few concerns:

1. Is this a firmware bug? Doesn't appear to be since the logic is described in the firmware: https://github.com/harp-tech/device.behavior/blob/e1a2c1eb4679318b77571f3f41ac94ce4ae89d9e/Firmware/Behavior/interrupts.c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
2. What is the function of this interrupt routine? Is it to distinguish between instruction to stop and an async promise return when the stop was actually executed?
3. We should document the functionality of this EVENT and add it to the device.yml https://github.com/harp-tech/device.behavior/blob/e1a2c1eb4679318b77571f3f41ac94ce4ae89d9e/device.yml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

Closed 2024-09-28.

Thread 25 (2025-03-12):

Document higher bound of pwm frequency

bruno-f-cruz, 2025-03-12:
https://github.com/harp-tech/device.behavior/blob/ddf71cfbec248f1cd7b7abaa9c477ac58e4a4dae/device.yml#L131

I was playing with the pwm frequency and it seems to cap at 10khz after which the board returns a write error. @artursilva0 @filcarv Can you confirm this behavior?
