harp-tech/device.behavior/Hardware/PCB/harp behavior.pdf

A

A

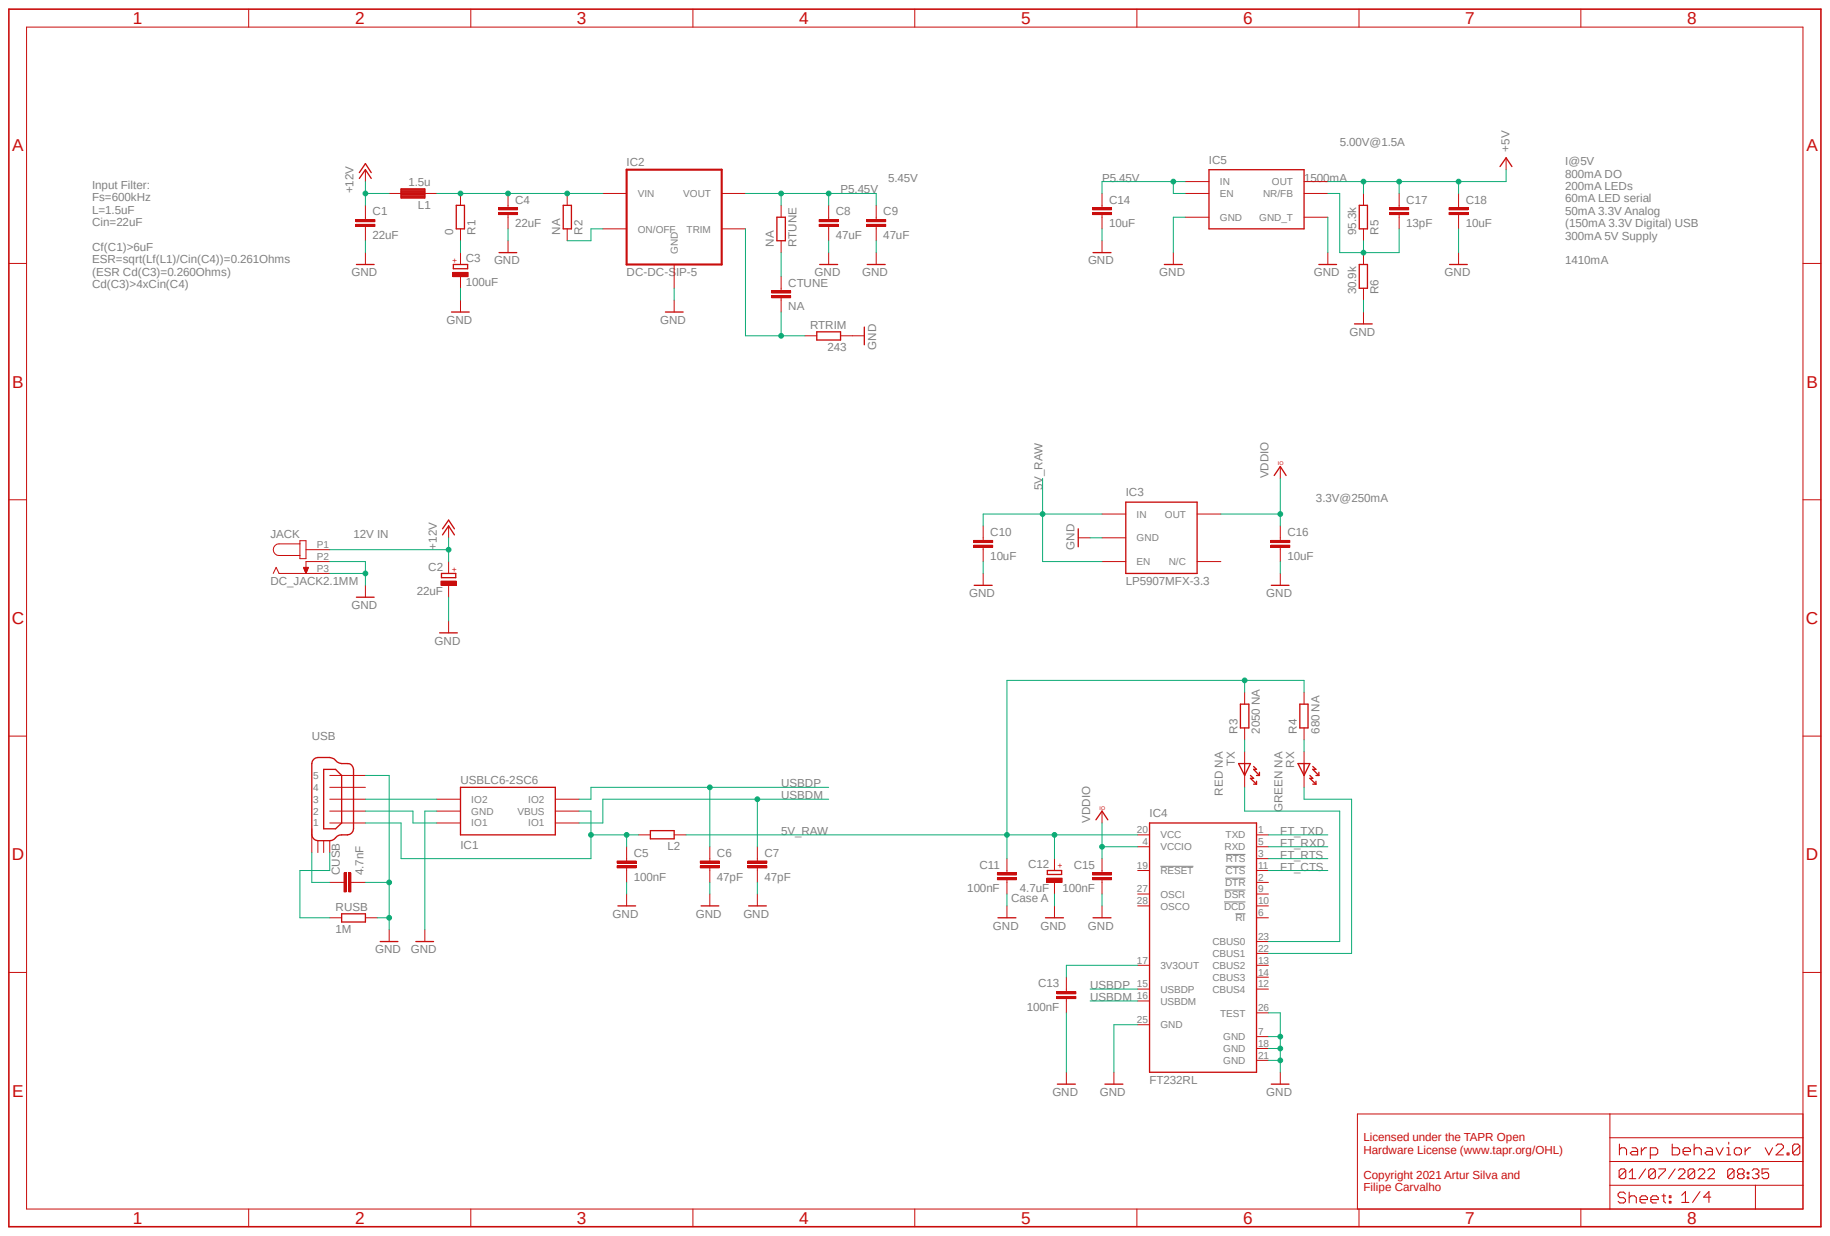
[picture p8: page 1]

ON/OFF GND VOUT

Licensed under the TAPR Open
Hardware License (www.tapr.org/OHL)
Copyright 2021 Artur Silva and
Filipe Carvalho

# GND VDDIO

A

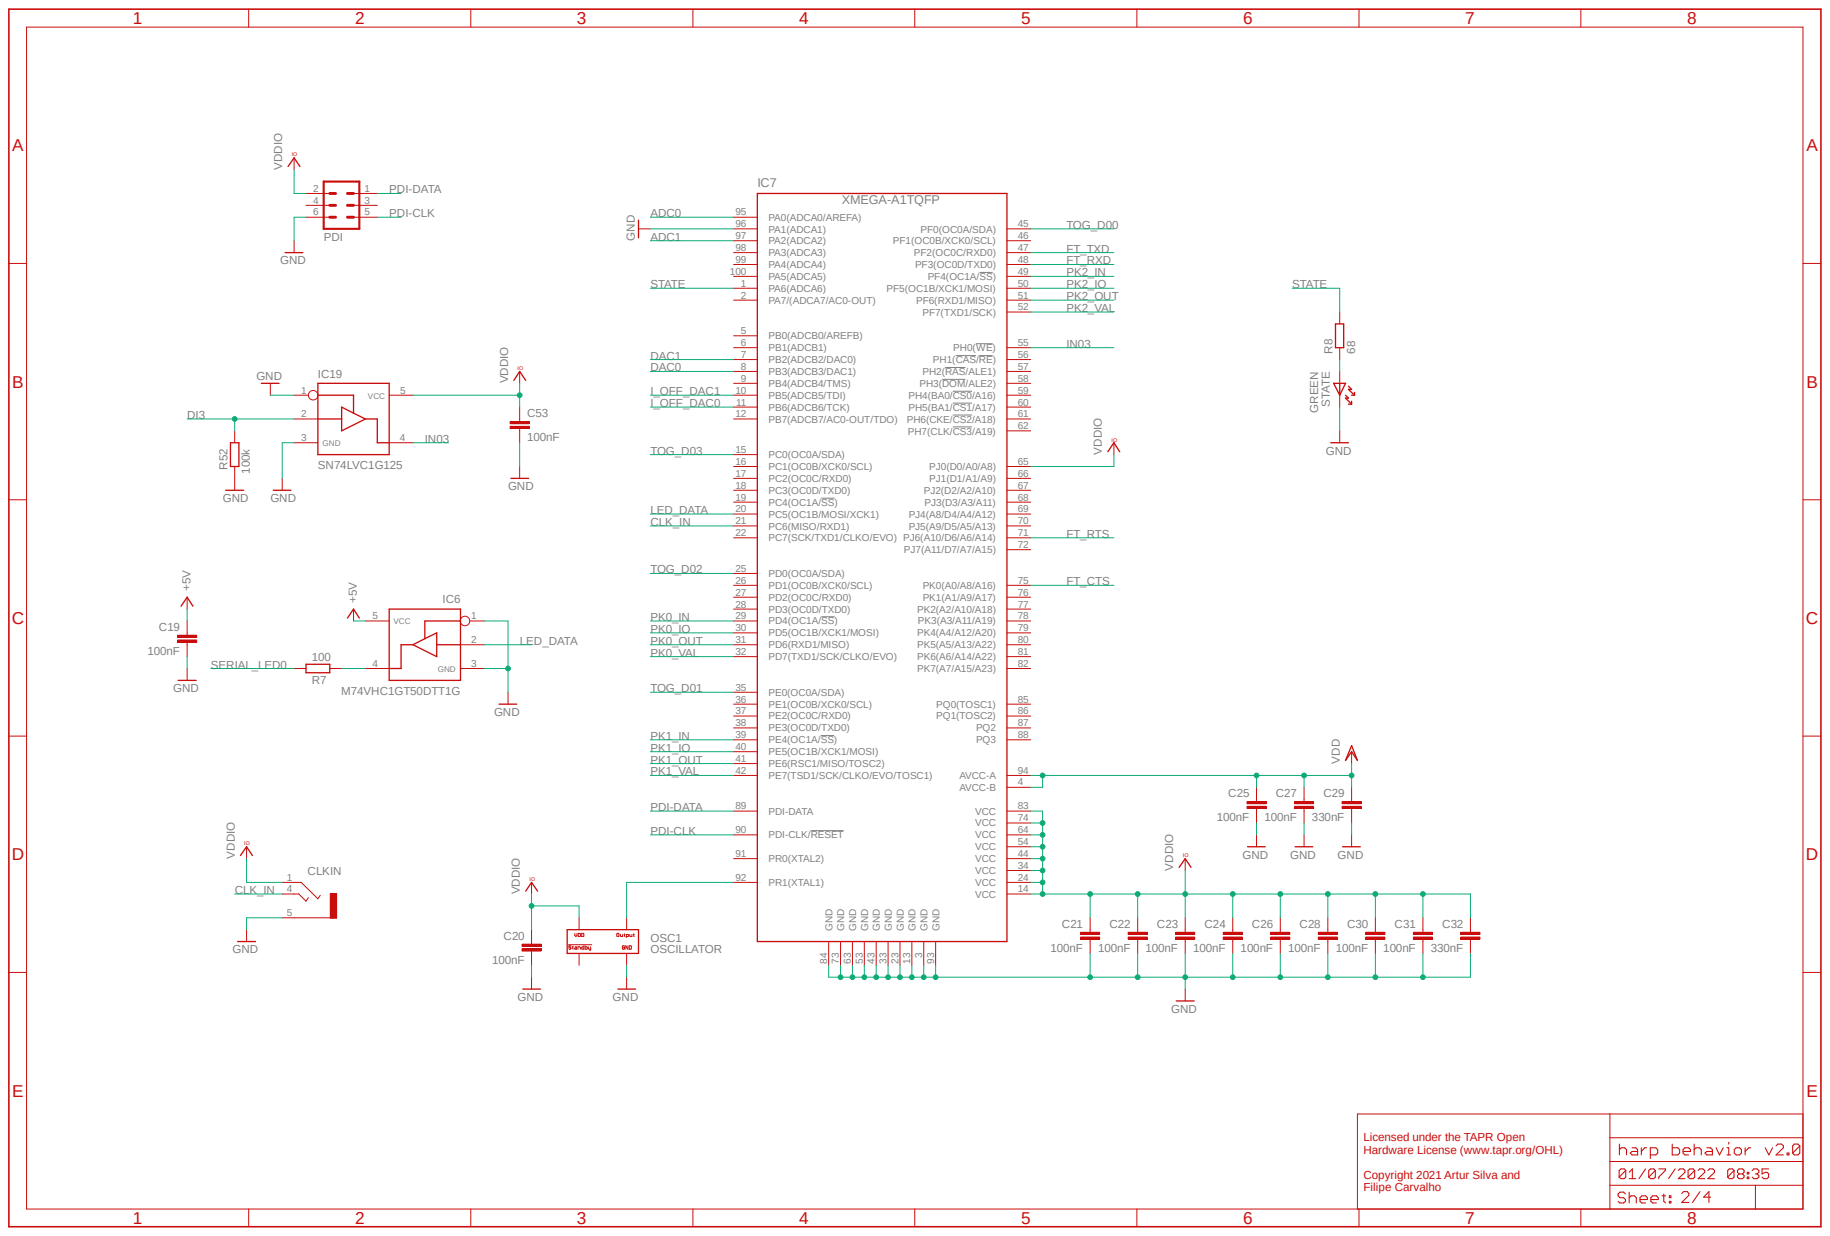
[picture p9: page 2]

Licensed under the TAPR Open
Hardware License (www.tapr.org/OHL)

# GND ⁺⁵V

# GND ⁺⁵V

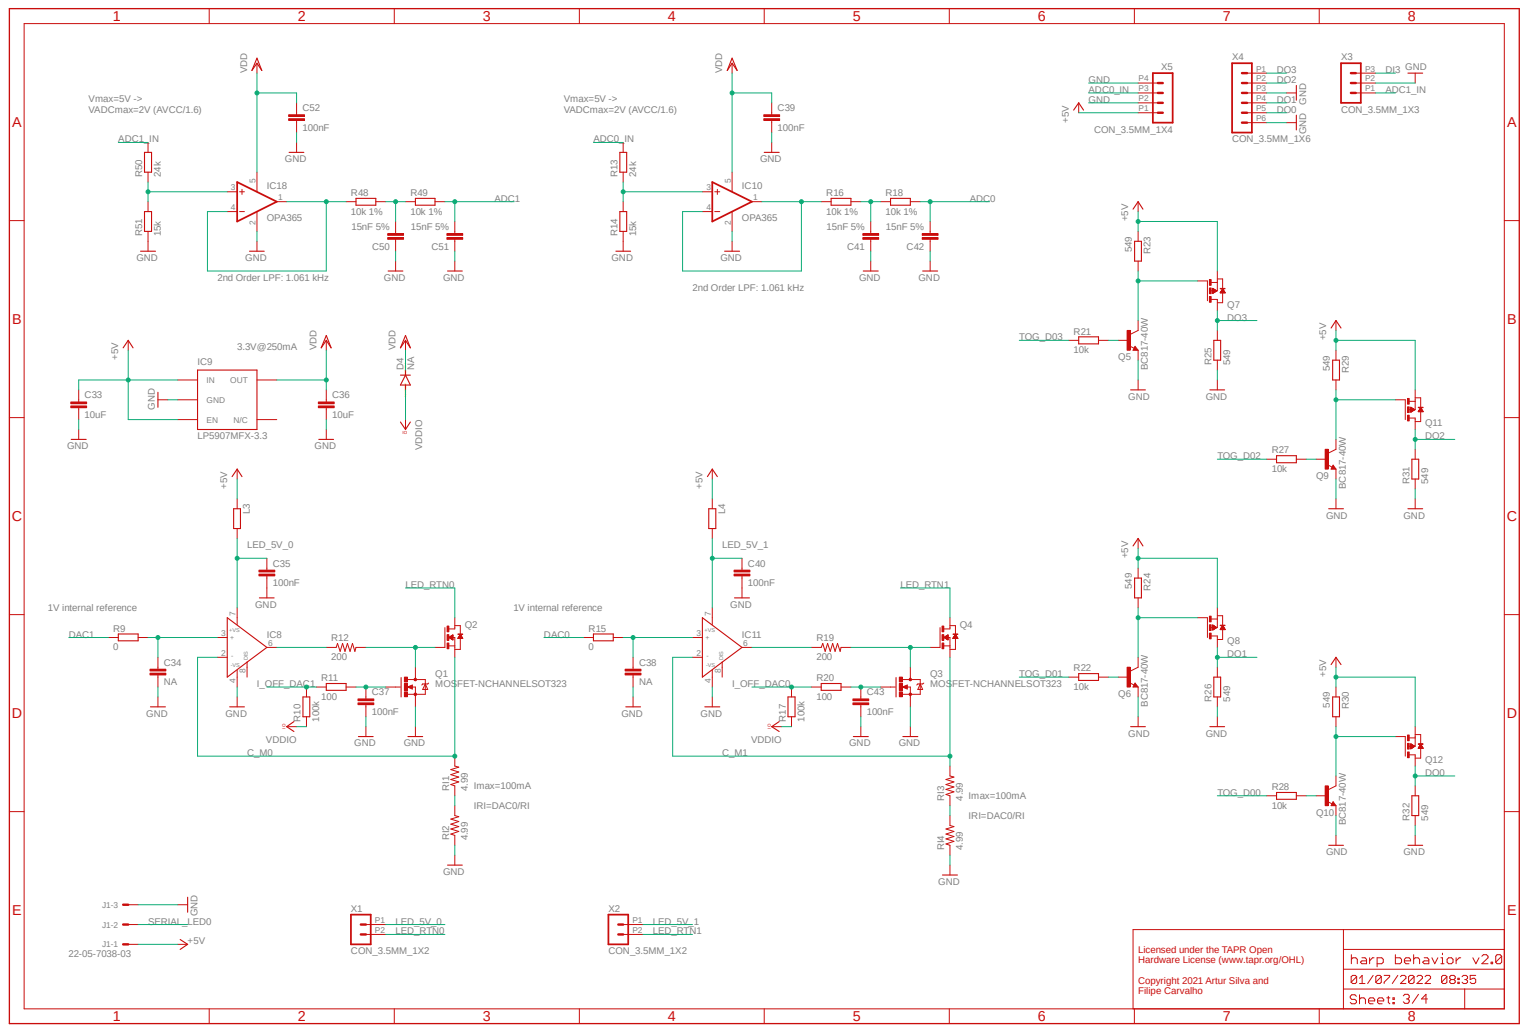
[picture p10: page 3]

Licensed under the TAPR Open
Hardware License (www.tapr.org/OHL)

# Port 2 ⁺¹²V +12V +12V

# GND GND GND GND

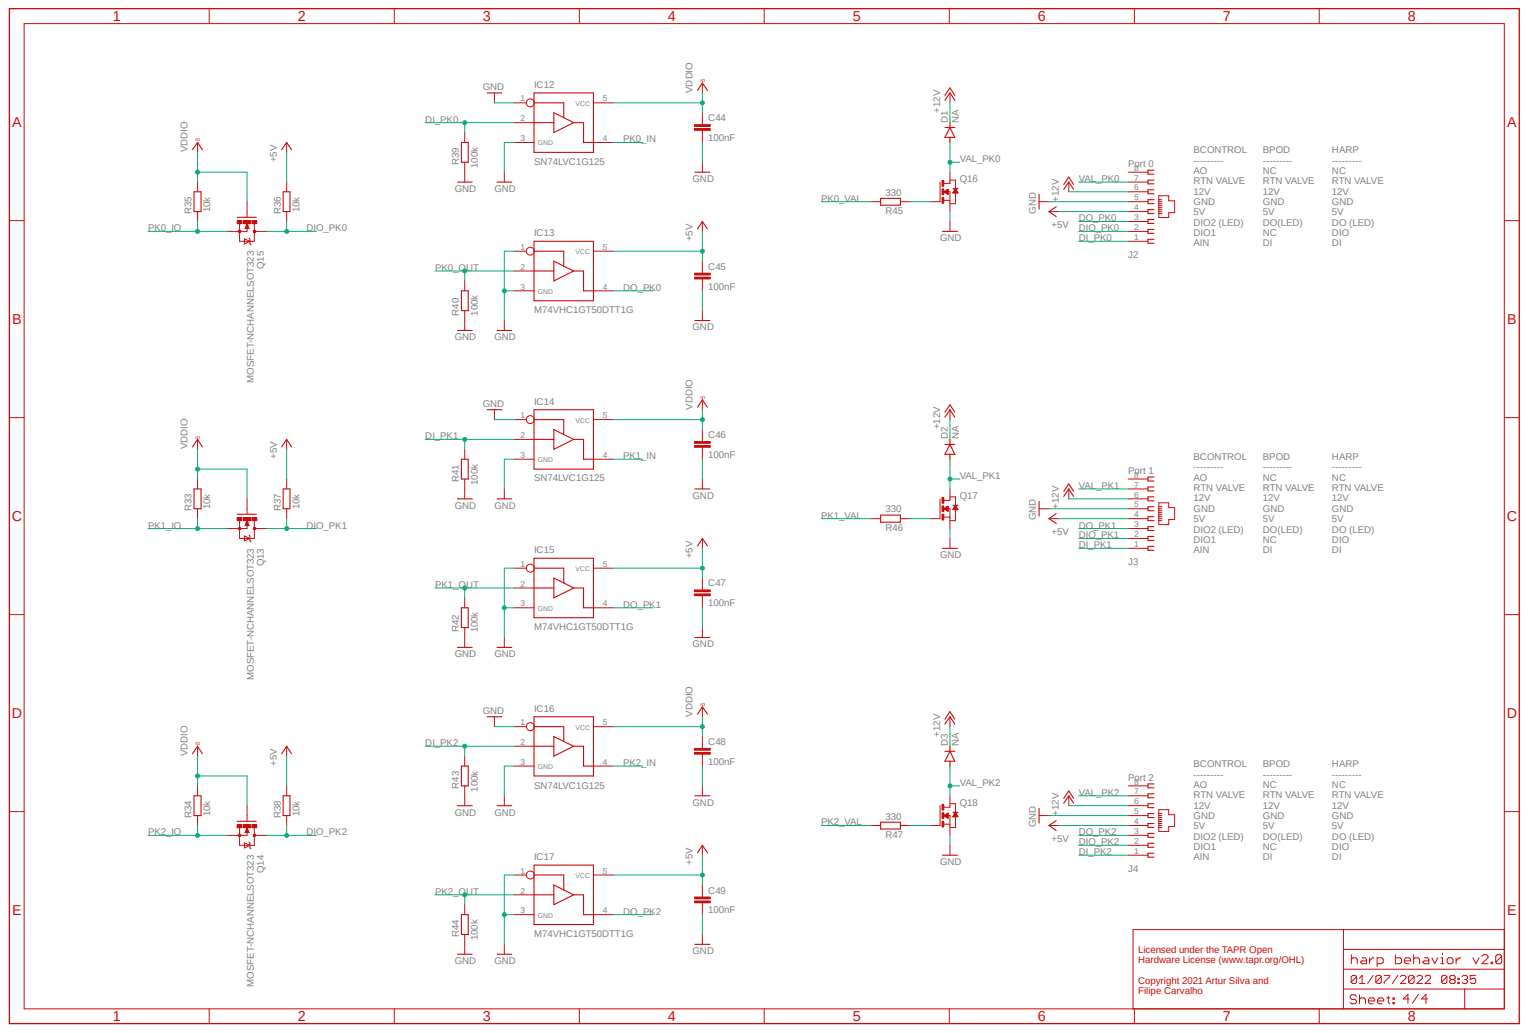
[picture p11: page 4]

SpiceOrder 1 SpiceOrder 2 SpiceOrder 1 SpiceOrder 2 SpiceOrder 1 SpiceOrder 2

Licensed under the TAPR Open
Hardware License (www.tapr.org/OHL)
