harp-tech/device.behavior/Hardware/Mechanical/case_v2.0/Behavior_Box_V2_0_LR.pdf

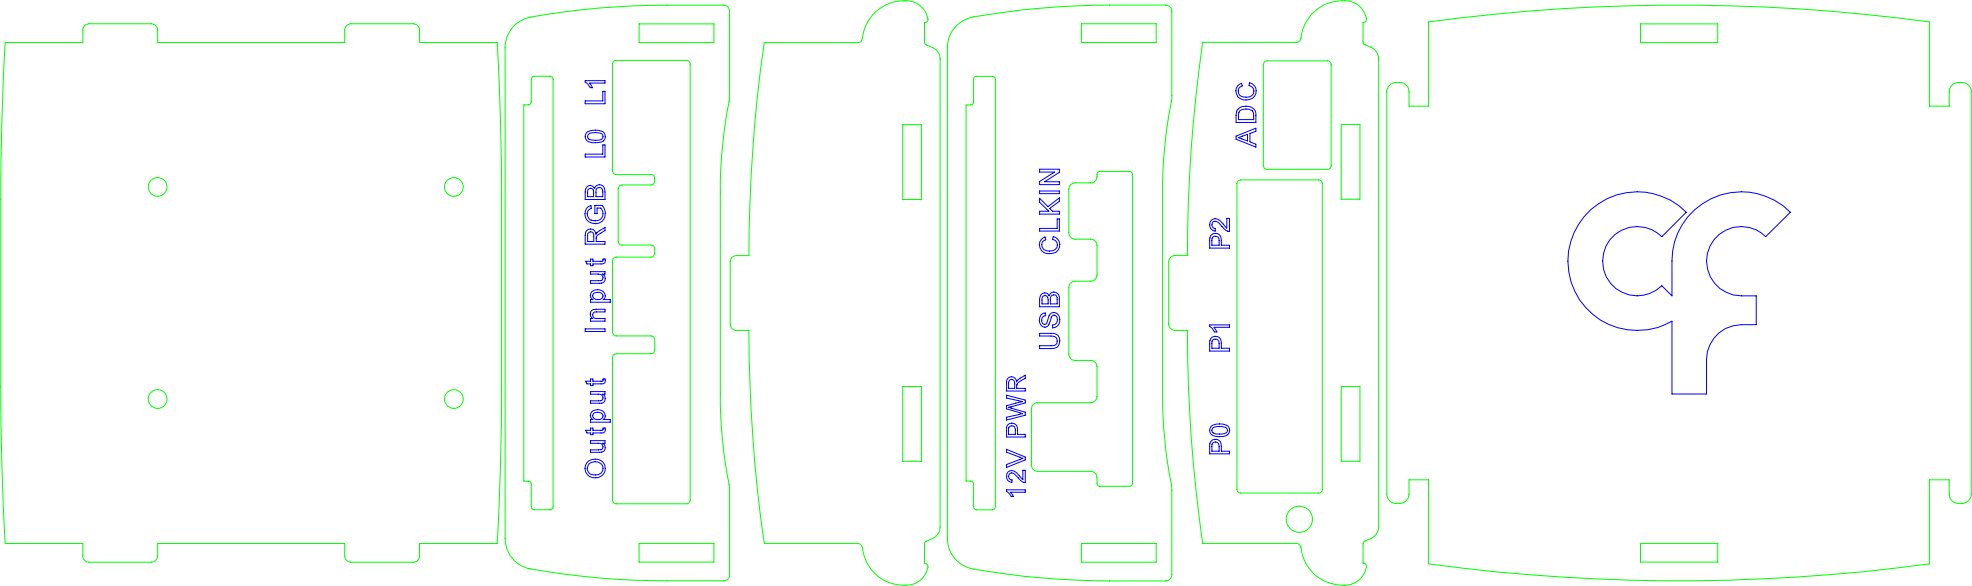
[picture p12: page 1]
