harp-tech/device.behavior/Hardware/Mechanical/case_v1.1_v1.2/Behavior_Box_LR.pdf

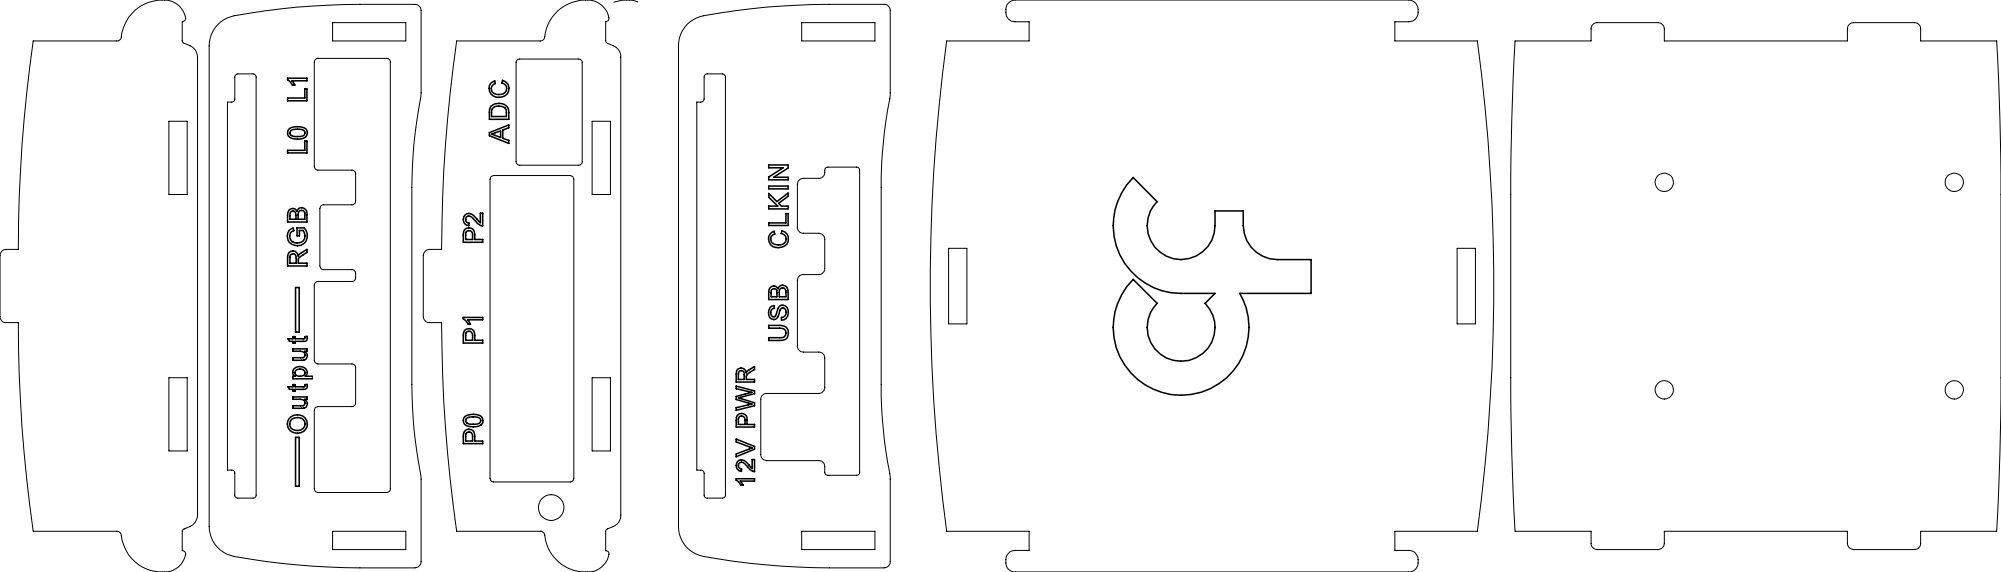
[picture p13: page 1]
