harp-tech/device.behavior/Hardware/Mechanical/case_v1.1_v1.2/Behavior_Box_LR_Color_GB.pdf

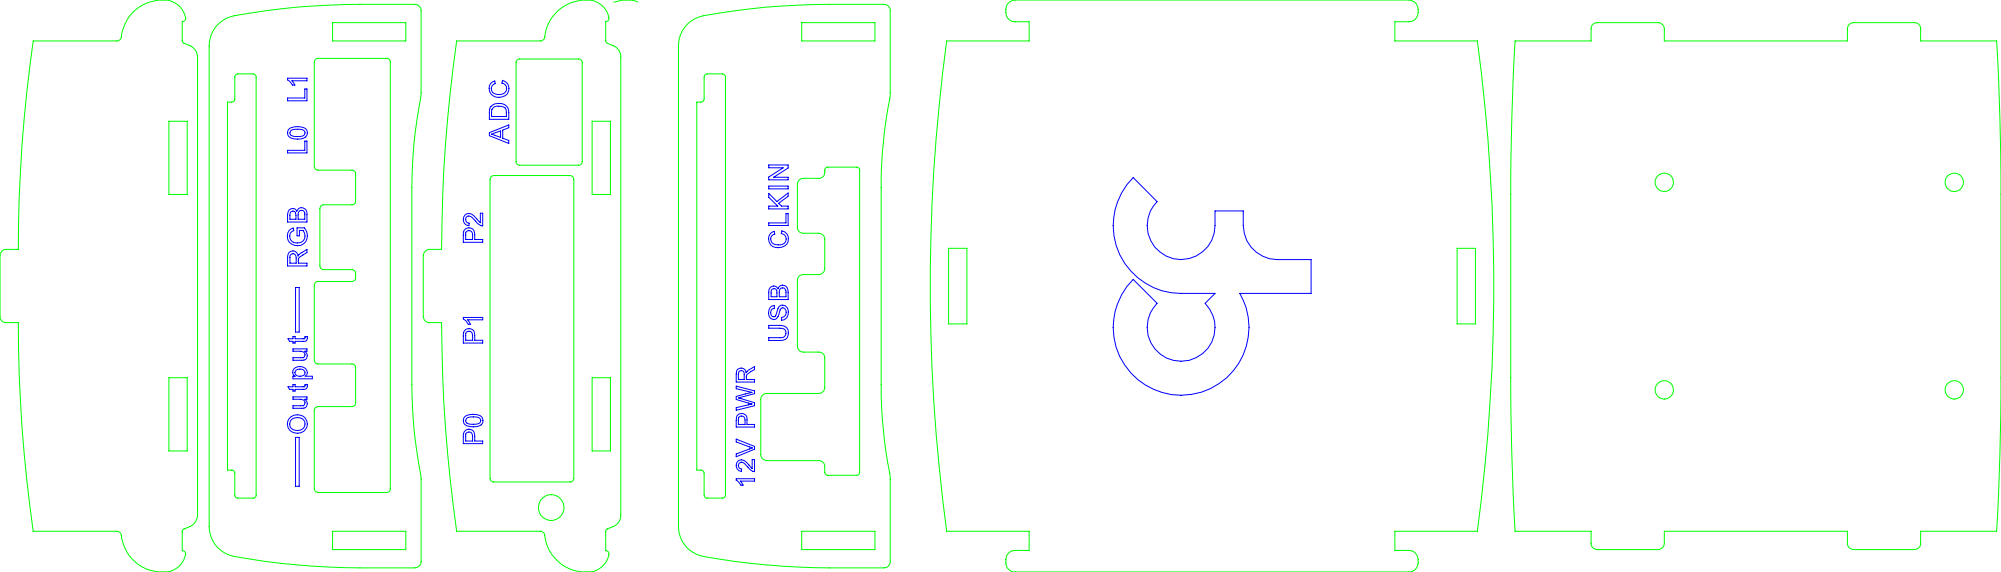
[picture p14: page 1]
