harp-tech/device.behavior/Hardware/PCB/harp behavior.brd

## EAGLE design Hardware/PCB/harp behavior.brd (2022-07-01)

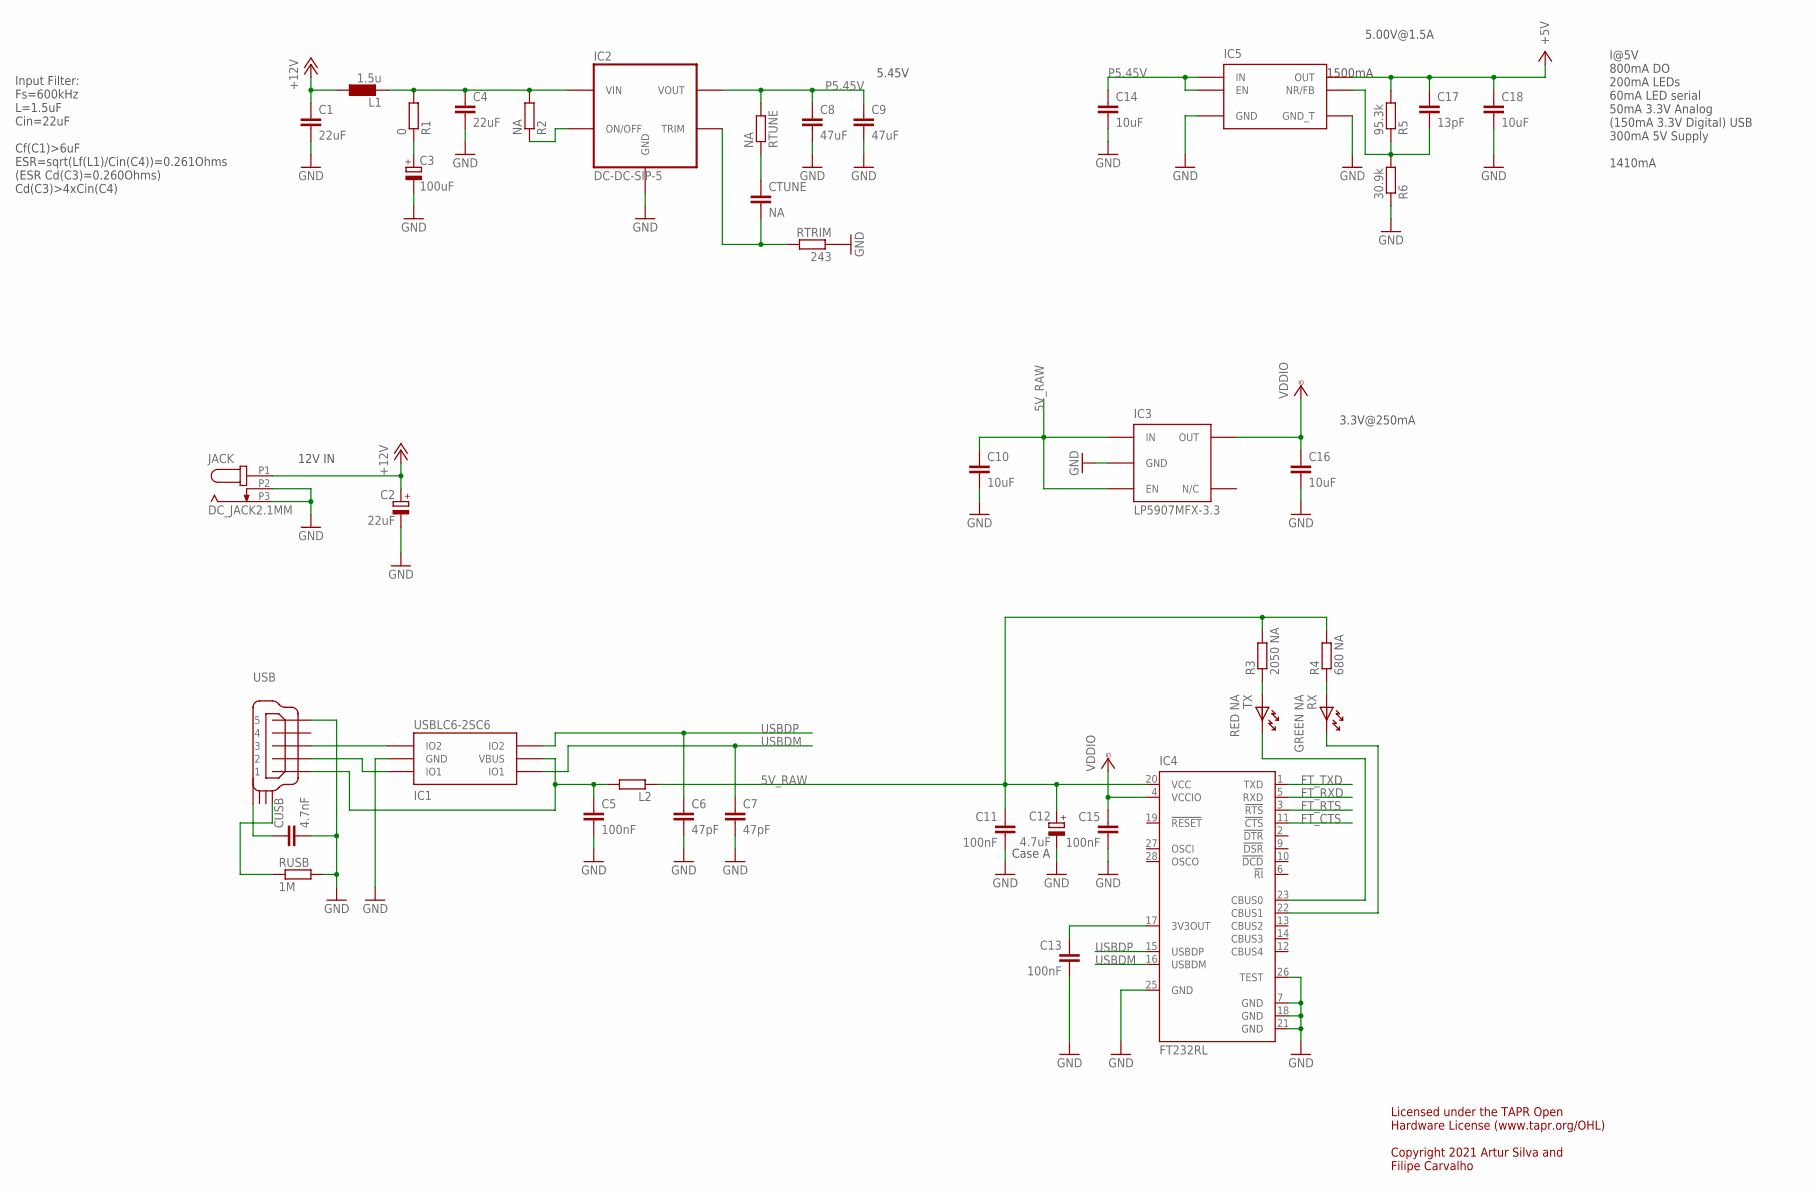
[picture p15: schematic harp behavior.sch, sheet 1]

Parts:
C1, C4: 22uF; C1210
C2: 22uF; CAP_100UF_HAND
C3: 100uF; PANASONIC_E
C5, C11, C13, C15: 100nF; C0402
C6, C7: 47pF; C0402
C8, C9: 47uF; C1210
C10, C14, C16, C18: 10uF; C0603
C12: 4.7uF; A/3216-18W
C17: 13pF; C0402
CTUNE: NA; C0402
CUSB: 4.7nF; C0402
IC1: USBLC6-2SC6; SOT23-6L
IC2: DC-DC-SIP-5; SIP-5
IC3: LP5907MFX-3.3; TSOT23-5
IC4: FT232RL; SSOP28
IC5: TPS78601SON; SON-8
JACK: DC_JACK2.1MM; DC_POWER_INPUT_2.1MM
L1: 1.5u; IND_LPS4012_V2
L2: ???; R0805
R1: 0; R0402
R2: NA; R0402
R3: 2050 NA; R0402
R4: 680 NA; R0402
R5: 95.3k; R0402
R6: 30.9k; R0402
RTRIM: 243; R0402
RTUNE: NA; R0402
RUSB: 1M; R0402
RX: GREEN NA; LED_HAND
TX: RED NA; LED_HAND
USB: USB_MINI_B; 240-0002-1

Connections:
5V_RAW: C10.1, C11.1, C12.+, IC3.1 (IN), IC3.3 (EN), IC4.20 (VCC), L2.1, R3.2, R4.2
+5V: C17.1, C18.1, IC5.P3 (OUT), IC5.P4 (OUT), R5.2; also elsewhere on the board
+12V: C1.1, C2.+, JACK.P1 (1), L1.1; also elsewhere on the board
DCIN: C4.1, IC2.P2 (VIN), L1.2, R1.2, R2.2
FT_CTS: IC4.11 (!CTS); also elsewhere on the board
FT_RTS: IC4.3 (!RTS); also elsewhere on the board
FT_RXD: IC4.5 (RXD); also elsewhere on the board
FT_TXD: IC4.1 (TXD); also elsewhere on the board
GND: C1.2, C2.-, C3.-, C4.2, C5.2, C6.2, C7.2, C8.2, C9.2, C10.2, C11.2, C12.-, C13.2, C14.2, C15.2, C16.2, C18.2, CUSB.2, IC1.P$2 (GND), IC2.P3 (GND), IC3.2 (GND), IC4.7 (GND), IC4.18 (GND), IC4.21 (GND), IC4.25 (GND), IC4.26 (TEST), IC5.P6 (GND), IC5.P9 (GND_T), JACK.P2 (2), JACK.P3 (3), R6.1, RTRIM.1, RUSB.2, USB.P$5 (5); also elsewhere on the board
unnamed: CTUNE.2, IC2.P5 (TRIM), RTRIM.2
unnamed: CTUNE.1, RTUNE.1
unnamed: IC2.P1 (ON/OFF), R2.1
unnamed: C17.2, IC5.P5 (NR/FB), R5.1, R6.2
unnamed: C3.+, R1.1
unnamed: C13.1, IC4.17 (3V3OUT)
unnamed: C5.1, IC1.P$5 (VBUS), L2.2, USB.P$1 (1)
unnamed: IC1.P$1 (IO1), USB.P$2 (2)
unnamed: R4.1, RX.A
unnamed: IC4.23 (CBUS0), TX.K
unnamed: IC4.22 (CBUS1), RX.K
unnamed: IC1.P$3 (IO2), USB.P$3 (3)
unnamed: CUSB.1, USB.SHIELD_4
unnamed: RUSB.1, USB.SHIELD_1
unnamed: R3.1, TX.A
P5.45V: C8.1, C9.1, C14.1, IC2.P4 (VOUT), IC5.P1 (IN), IC5.P2 (IN), IC5.P8 (EN), RTUNE.2
USBDM: C7.1, IC1.P$6 (IO1), IC4.16 (USBDM)
USBDP: C6.1, IC1.P$4 (IO2), IC4.15 (USBDP)
VCCIO: C15.1, C16.1, IC3.5 (OUT), IC4.4 (VCCIO); also elsewhere on the board

Notes on the sheet:
Case A
3.3V@250mA
Licensed under the TAPR Open Hardware License (www.tapr.org/OHL) Copyright 2021 Artur Silva and Filipe Carvalho
12V IN
I@5V 800mA DO 200mA LEDs 60mA LED serial 50mA 3.3V Analog (150mA 3.3V Digital) USB 300mA 5V Supply 1410mA
5.45V
1500mA
5.00V@1.5A
Input Filter: Fs=600kHz L=1.5uF Cin=22uF Cf(C1)>6uF ESR=sqrt(Lf(L1)/Cin(C4))=0.261Ohms (ESR Cd(C3)=0.260Ohms) Cd(C3)>4xCin(C4)

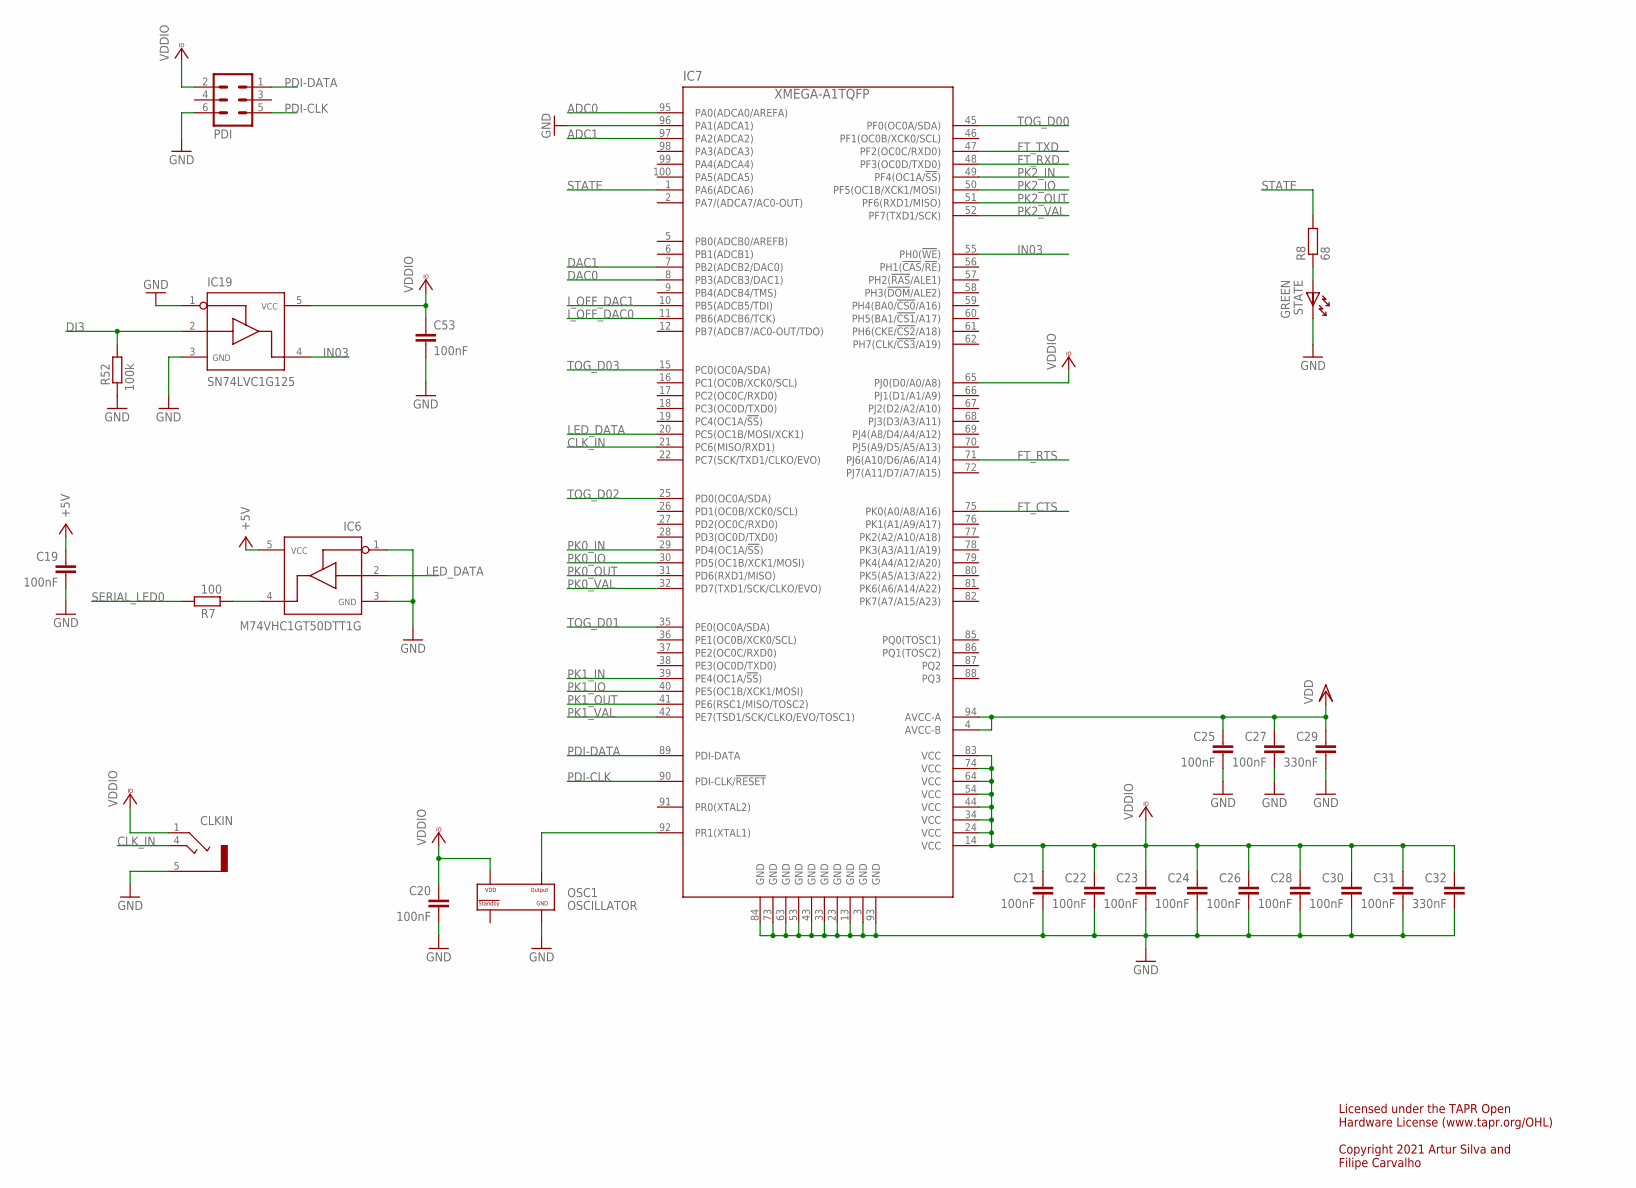
[picture p16: schematic harp behavior.sch, sheet 2]

Parts:
C19, C20, C21, C22, C23, C24, C25, C26, C27, C28, C30, C31, C53: 100nF; C0402
C29, C32: 330nF; C0402
CLKIN: STEREO_JACK; 35RASMT2BHNTRX
IC6: M74VHC1GT50DTT1G; SOT23-5
IC7: XMEGA-A1TQFP; TQFP100
IC19: SN74LVC1G125; SOT23-5
OSC1: OSCILLATOR; OSCILLATOR_3.2X2.5
PDI: MA03-2
R7: 100; R0402
R8: 68; R0402
R52: 100k; R0402
STATE: GREEN; LED_HAND

Connections:
+5V: C19.1, IC6.5; also elsewhere on the board
ADC0: IC7.95 (PA0(ADCA0/AREFA)); also elsewhere on the board
ADC1: IC7.97 (PA2(ADCA2)); also elsewhere on the board
CLK_IN: CLKIN.4, IC7.21 (PC6(MISO/RXD1))
DAC0: IC7.8 (PB3(ADCB3/DAC1)); also elsewhere on the board
DAC1: IC7.7 (PB2(ADCB2/DAC0)); also elsewhere on the board
DI3: IC19.2, R52.1; also elsewhere on the board
FT_CTS: IC7.75 (PK0(A0/A8/A16)); also elsewhere on the board
FT_RTS: IC7.71 (PJ6(A10/D6/A6/A14)); also elsewhere on the board
FT_RXD: IC7.48 (PF3(OC0D/TXD0)); also elsewhere on the board
FT_TXD: IC7.47 (PF2(OC0C/RXD0)); also elsewhere on the board
GND: C19.2, C20.2, C21.2, C22.2, C23.2, C24.2, C25.2, C26.2, C27.2, C28.2, C29.2, C30.2, C31.2, C32.2, C53.2, CLKIN.5, IC6.1, IC6.3, IC7.3 (GND), IC7.13 (GND), IC7.23 (GND), IC7.33 (GND), IC7.43 (GND), IC7.53 (GND), IC7.63 (GND), IC7.73 (GND), IC7.84 (GND), IC7.93 (GND), IC7.96 (PA1(ADCA1)), IC19.1, IC19.3, OSC1.P$2 (GND), PDI.6, R52.2, STATE.K; also elsewhere on the board
IN03: IC7.55 (PH0(!WE!)), IC19.4
I_OFF_DAC0: IC7.11 (PB6(ADCB6/TCK)); also elsewhere on the board
I_OFF_DAC1: IC7.10 (PB5(ADCB5/TDI)); also elsewhere on the board
LED_DATA: IC6.2, IC7.20 (PC5(OC1B/MOSI/XCK1))
unnamed: IC6.4, R7.2
unnamed: R8.1, STATE.A
OSC1: IC7.92 (PR1(XTAL1)), OSC1.P$3 (OUTPUT)
PDI-CLK: IC7.90 (PDI-CLK/!RESET), PDI.5
PDI-DATA: IC7.89 (PDI-DATA), PDI.1
PK0_IN: IC7.29 (PD4(OC1A/!SS!)); also elsewhere on the board
PK0_IO: IC7.30 (PD5(OC1B/XCK1/MOSI)); also elsewhere on the board
PK0_OUT: IC7.31 (PD6(RXD1/MISO)); also elsewhere on the board
PK0_VAL: IC7.32 (PD7(TXD1/SCK/CLKO/EVO)); also elsewhere on the board
PK1_IN: IC7.39 (PE4(OC1A/!SS!)); also elsewhere on the board
PK1_IO: IC7.40 (PE5(OC1B/XCK1/MOSI)); also elsewhere on the board
PK1_OUT: IC7.41 (PE6(RSC1/MISO/TOSC2)); also elsewhere on the board
PK1_VAL: IC7.42 (PE7(TSD1/SCK/CLKO/EVO/TOSC1)); also elsewhere on the board
PK2_IN: IC7.49 (PF4(OC1A/!SS!)); also elsewhere on the board
PK2_IO: IC7.50 (PF5(OC1B/XCK1/MOSI)); also elsewhere on the board
PK2_OUT: IC7.51 (PF6(RXD1/MISO)); also elsewhere on the board
PK2_VAL: IC7.52 (PF7(TXD1/SCK)); also elsewhere on the board
SERIAL_LED0: R7.1; also elsewhere on the board
STATE: IC7.1 (PA6(ADCA6)), R8.2
TOG_D00: IC7.45 (PF0(OC0A/SDA)); also elsewhere on the board
TOG_D01: IC7.35 (PE0(OC0A/SDA)); also elsewhere on the board
TOG_D02: IC7.25 (PD0(OC0A/SDA)); also elsewhere on the board
TOG_D03: IC7.15 (PC0(OC0A/SDA)); also elsewhere on the board
VCCIO: C20.1, C21.1, C22.1, C23.1, C24.1, C26.1, C28.1, C30.1, C31.1, C32.1, C53.1, CLKIN.1, IC7.14 (VCC), IC7.24 (VCC), IC7.34 (VCC), IC7.44 (VCC), IC7.54 (VCC), IC7.64 (VCC), IC7.65 (PJ0(D0/A0/A8)), IC7.74 (VCC), IC7.83 (VCC), IC19.5, OSC1.P$4 (VDD), PDI.2; also elsewhere on the board
VDD: C25.1, C27.1, C29.1, IC7.4 (AVCC-B), IC7.94 (AVCC-A); also elsewhere on the board

Notes on the sheet:
Licensed under the TAPR Open Hardware License (www.tapr.org/OHL) Copyright 2021 Artur Silva and Filipe Carvalho

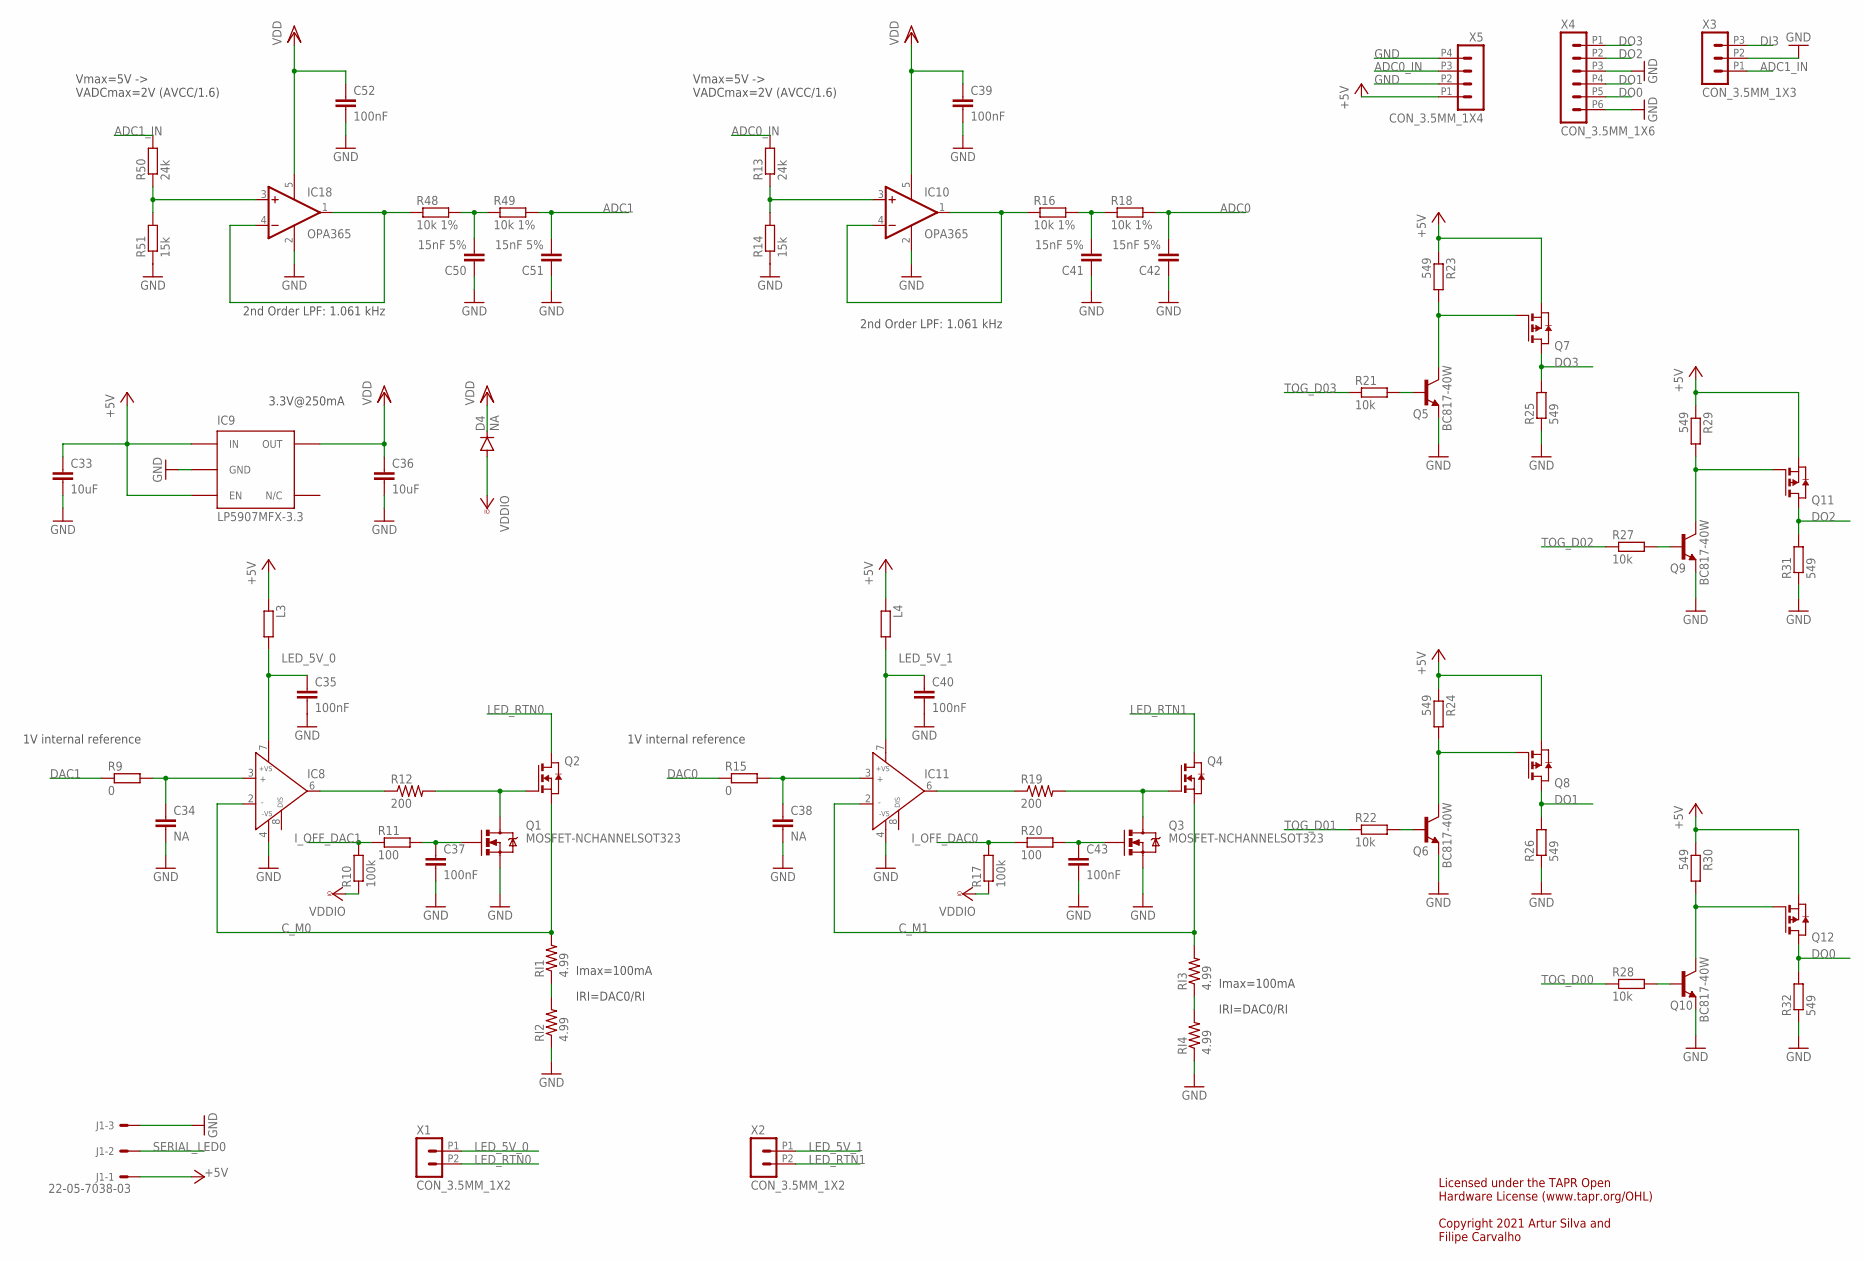
[picture p17: schematic harp behavior.sch, sheet 3]

Parts:
C33, C36: 10uF; C0603
C34, C38: NA; C0402
C35, C37, C39, C40, C43, C52: 100nF; C0402
C41, C42, C50, C51: 15nF 5%; C0402
D4: NA; SOD-323-DIODE
IC8, IC11: AD8041R; SO8
IC9: LP5907MFX-3.3; TSOT23-5
IC10, IC18: OPA365; SOT23-5
J1: 22-05-7038-03; 7395-03
L3, L4: 600@100M; R0805
Q1, Q3: MOSFET-NCHANNELSOT323; SOT323
Q2, Q4: NMOSSOT223; SOT223
Q5, Q6, Q9, Q10: BC817-40W; SOT323-BEC
Q7, Q8, Q11, Q12: PMOSSOT223; SOT223
R9, R15: 0; R0402
R10, R17: 100k; R0402
R11, R20: 100; R0402
R12, R19: 200; R1210
R13, R50: 24k; R0402
R14, R51: 15k; R0402
R16, R18, R48, R49: 10k 1%; R0402
R21, R22, R27, R28: 10k; R0402
R23, R24, R25, R26, R29, R30, R31, R32: 549; R0805
RI1, RI2, RI3, RI4: 4.99; R2512
X1, X2: CON_3.5MM_1X2
X3: CON_3.5MM_1X3
X4: CON_3.5MM_1X6
X5: CON_3.5MM_1X4

Connections:
+5V: C33.1, IC9.1 (IN), IC9.3 (EN), J1.1, L3.1, L4.1, Q7.3 (S), Q8.3 (S), Q11.3 (S), Q12.3 (S), R23.1, R24.1, R29.1, R30.1, X5.P1 (1); also elsewhere on the board
ADC0: C42.2, R18.2; also elsewhere on the board
ADC0_IN: R13.2, X5.P3 (3)
ADC1: C51.2, R49.2; also elsewhere on the board
ADC1_IN: R50.2, X3.P1 (1)
CTRL_BL: IC11.6 (OUT), R19.1
CTRL_BL1: IC8.6 (OUT), R12.1
C_M0: IC8.2 (IN-), Q2.3 (S), RI1.2
C_M1: IC11.2 (IN-), Q4.3 (S), RI3.2
DAC0: R15.1; also elsewhere on the board
DAC1: R9.1; also elsewhere on the board
DI3: X3.P3 (3); also elsewhere on the board
DO0: Q12.2 (D), Q12.4 (D), R32.2, X4.P5 (5)
DO1: Q8.2 (D), Q8.4 (D), R26.2, X4.P4 (4)
DO2: Q11.2 (D), Q11.4 (D), R31.2, X4.P2 (2)
DO3: Q7.2 (D), Q7.4 (D), R25.2, X4.P1 (1)
GND: C33.2, C34.2, C35.2, C36.2, C37.2, C38.2, C39.2, C40.2, C41.1, C42.1, C43.2, C50.1, C51.1, C52.2, IC8.4 (-VS), IC9.2 (GND), IC10.2 (V-), IC11.4 (-VS), IC18.2 (V-), J1.3, Q1.2 (S), Q3.2 (S), Q5.E, Q6.E, Q9.E, Q10.E, R14.1, R25.1, R26.1, R31.1, R32.1, R51.1, RI2.1, RI4.1, X3.P2 (2), X4.P3 (3), X4.P6 (6), X5.P2 (2), X5.P4 (4); also elsewhere on the board
I_OFF_DAC0: R17.2, R20.1; also elsewhere on the board
I_OFF_DAC1: R10.2, R11.1; also elsewhere on the board
LED_5V_0: C35.1, IC8.7 (+VS), L3.2, X1.P1 (1)
LED_5V_1: C40.1, IC11.7 (+VS), L4.2, X2.P1 (1)
LED_RTN0: Q2.2 (D), Q2.4 (D), X1.P2 (2)
LED_RTN1: Q4.2 (D), Q4.4 (D), X2.P2 (2)
unnamed: Q3.3 (D), Q4.1 (G), R19.2
unnamed: Q6.C, Q8.1 (G), R24.2
unnamed: Q6.B, R22.2
unnamed: Q9.C, Q11.1 (G), R29.2
unnamed: Q9.B, R27.2
unnamed: Q10.C, Q12.1 (G), R30.2
unnamed: Q10.B, R28.2
unnamed: Q1.3 (D), Q2.1 (G), R12.2
unnamed: C34.1, IC8.3 (IN+), R9.2
unnamed: C50.2, R48.2, R49.1
unnamed: IC18.1 (OUT), IC18.4 (-IN), R48.1
unnamed: C38.1, IC11.3 (IN+), R15.2
unnamed: RI1.1, RI2.2
unnamed: Q5.C, Q7.1 (G), R23.2
unnamed: Q5.B, R21.2
unnamed: C37.1, Q1.1 (G), R11.2
unnamed: IC18.3 (+IN), R50.1, R51.2
unnamed: C43.1, Q3.1 (G), R20.2
unnamed: RI3.1, RI4.2
unnamed: C41.2, R16.2, R18.1
unnamed: IC10.1 (OUT), IC10.4 (-IN), R16.1
unnamed: IC10.3 (+IN), R13.1, R14.2
SERIAL_LED0: J1.2; also elsewhere on the board
TOG_D00: R28.1; also elsewhere on the board
TOG_D01: R22.1; also elsewhere on the board
TOG_D02: R27.1; also elsewhere on the board
TOG_D03: R21.1; also elsewhere on the board
VCCIO: D4.A, R10.1, R17.1; also elsewhere on the board
VDD: C36.1, C39.1, C52.1, D4.C, IC9.5 (OUT), IC10.5 (V+), IC18.5 (V+); also elsewhere on the board

Notes on the sheet:
IRI=DAC0/RI
2nd Order LPF: 1.061 kHz
Licensed under the TAPR Open Hardware License (www.tapr.org/OHL) Copyright 2021 Artur Silva and Filipe Carvalho
3.3V@250mA
Vmax=5V -> VADCmax=2V (AVCC/1.6)
Imax=100mA
1V internal reference

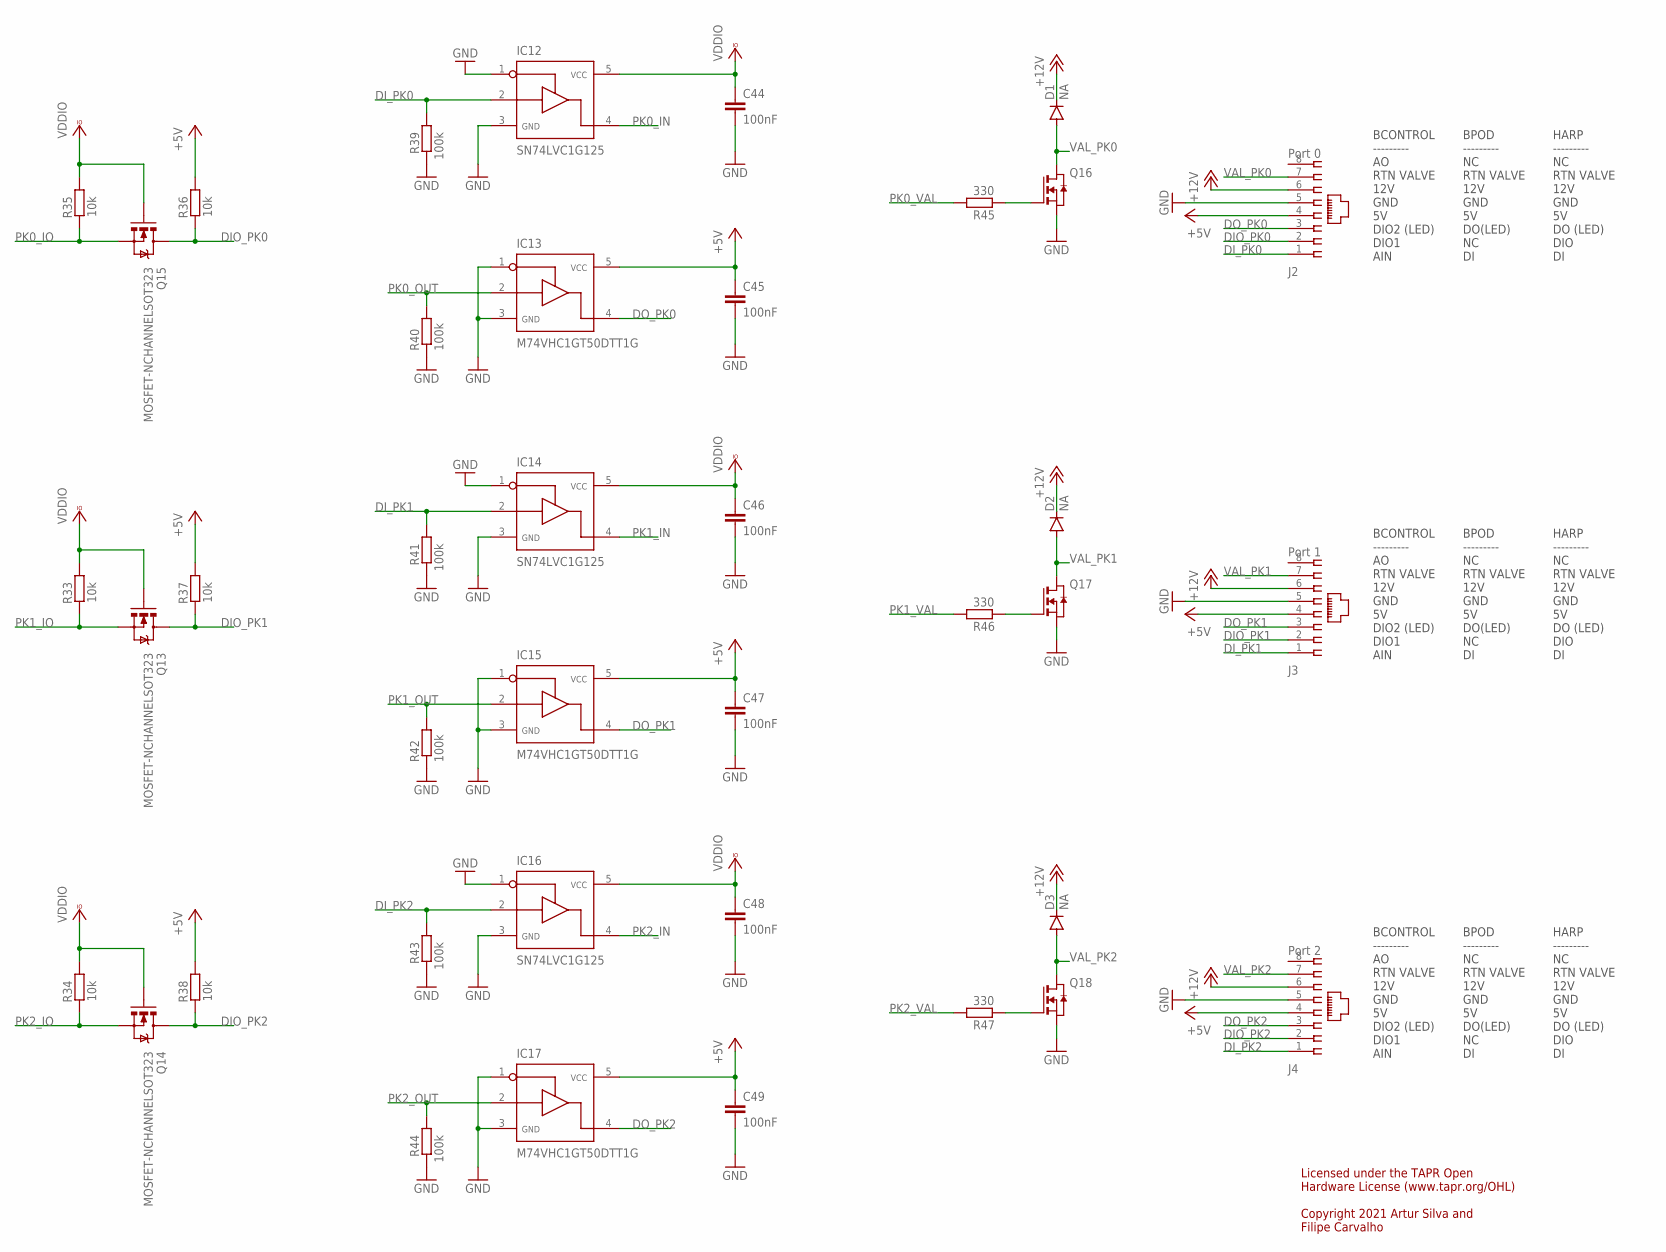
[picture p18: schematic harp behavior.sch, sheet 4]

Parts:
C44, C45, C46, C47, C48, C49: 100nF; C0402
D1, D2, D3: NA; SOD-323-DIODE
IC12, IC14, IC16: SN74LVC1G125; SOT23-5
IC13, IC15, IC17: M74VHC1GT50DTT1G; SOT23-5
J2: Port 0; 520426-4
J3: Port 1; 520426-4
J4: Port 2; 520426-4
Q13, Q14, Q15: MOSFET-NCHANNELSOT323; SOT323
Q16, Q17, Q18: NMOSSOT223; SOT223
R33, R34, R35, R36, R37, R38: 10k; R0402
R39, R40, R41, R42, R43, R44: 100k; R0402
R45, R46, R47: 330; R0402

Connections:
+5V: C45.1, C47.1, C49.1, IC13.5, IC15.5, IC17.5, J2.4, J3.4, J4.4, R36.1, R37.1, R38.1; also elsewhere on the board
+12V: D1.C, D2.C, D3.C, J2.6, J3.6, J4.6; also elsewhere on the board
DIO_PK0: J2.2, Q15.3 (D), R36.2
DIO_PK1: J3.2, Q13.3 (D), R37.2
DIO_PK2: J4.2, Q14.3 (D), R38.2
DI_PK0: IC12.2, J2.1, R39.1
DI_PK1: IC14.2, J3.1, R41.1
DI_PK2: IC16.2, J4.1, R43.1
DO_PK0: IC13.4, J2.3
DO_PK1: IC15.4, J3.3
DO_PK2: IC17.4, J4.3
GND: C44.2, C45.2, C46.2, C47.2, C48.2, C49.2, IC12.1, IC12.3, IC13.1, IC13.3, IC14.1, IC14.3, IC15.1, IC15.3, IC16.1, IC16.3, IC17.1, IC17.3, J2.5, J3.5, J4.5, Q16.3 (S), Q17.3 (S), Q18.3 (S), R39.2, R40.1, R41.2, R42.1, R43.2, R44.2; also elsewhere on the board
unnamed: Q16.1 (G), R45.2
unnamed: Q17.1 (G), R46.2
unnamed: Q18.1 (G), R47.2
PK0_IN: IC12.4; also elsewhere on the board
PK0_IO: Q15.2 (S), R35.2; also elsewhere on the board
PK0_OUT: IC13.2, R40.2; also elsewhere on the board
PK0_VAL: R45.1; also elsewhere on the board
PK1_IN: IC14.4; also elsewhere on the board
PK1_IO: Q13.2 (S), R33.2; also elsewhere on the board
PK1_OUT: IC15.2, R42.2; also elsewhere on the board
PK1_VAL: R46.1; also elsewhere on the board
PK2_IN: IC16.4; also elsewhere on the board
PK2_IO: Q14.2 (S), R34.2; also elsewhere on the board
PK2_OUT: IC17.2, R44.1; also elsewhere on the board
PK2_VAL: R47.1; also elsewhere on the board
VAL_PK0: D1.A, J2.7, Q16.2 (D), Q16.4 (D)
VAL_PK1: D2.A, J3.7, Q17.2 (D), Q17.4 (D)
VAL_PK2: D3.A, J4.7, Q18.2 (D), Q18.4 (D)
VCCIO: C44.1, C46.1, C48.1, IC12.5, IC14.5, IC16.5, Q13.1 (G), Q14.1 (G), Q15.1 (G), R33.1, R34.1, R35.1; also elsewhere on the board

Notes on the sheet:
BCONTROL --------- AO RTN VALVE 12V GND 5V DIO2 (LED) DIO1 AIN
BPOD --------- NC RTN VALVE 12V GND 5V DO(LED) NC DI
HARP --------- NC RTN VALVE 12V GND 5V DO (LED) DIO DI
Licensed under the TAPR Open Hardware License (www.tapr.org/OHL) Copyright 2021 Artur Silva and Filipe Carvalho

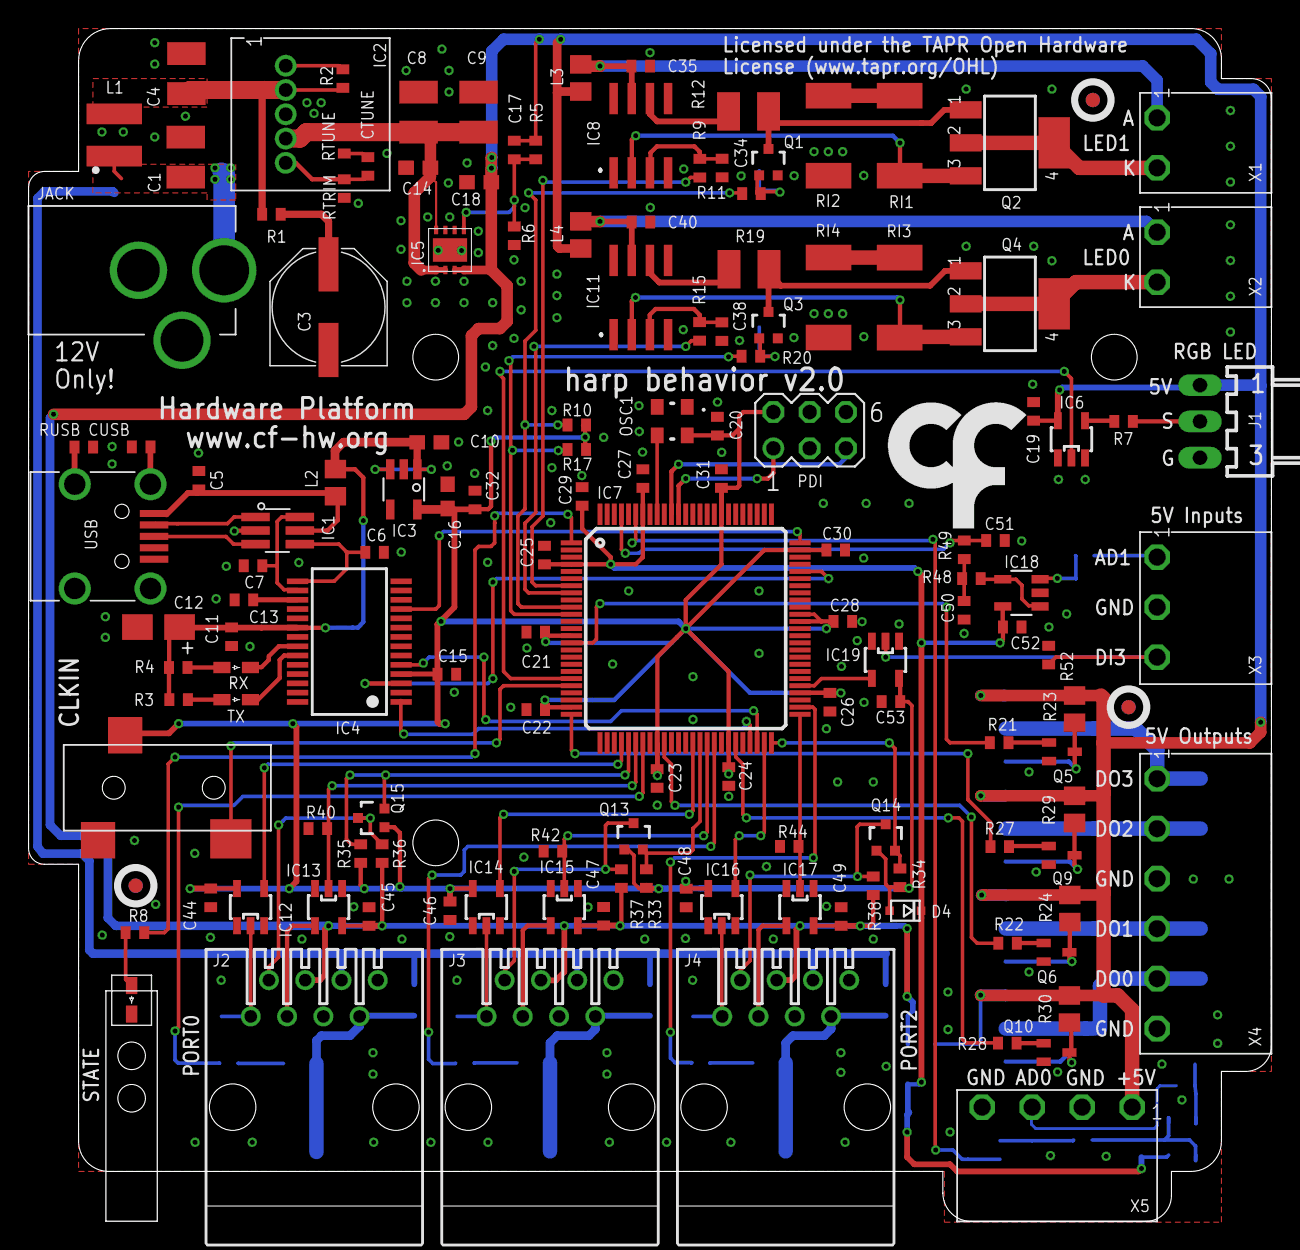
[picture p19: board harp behavior.brd from above]

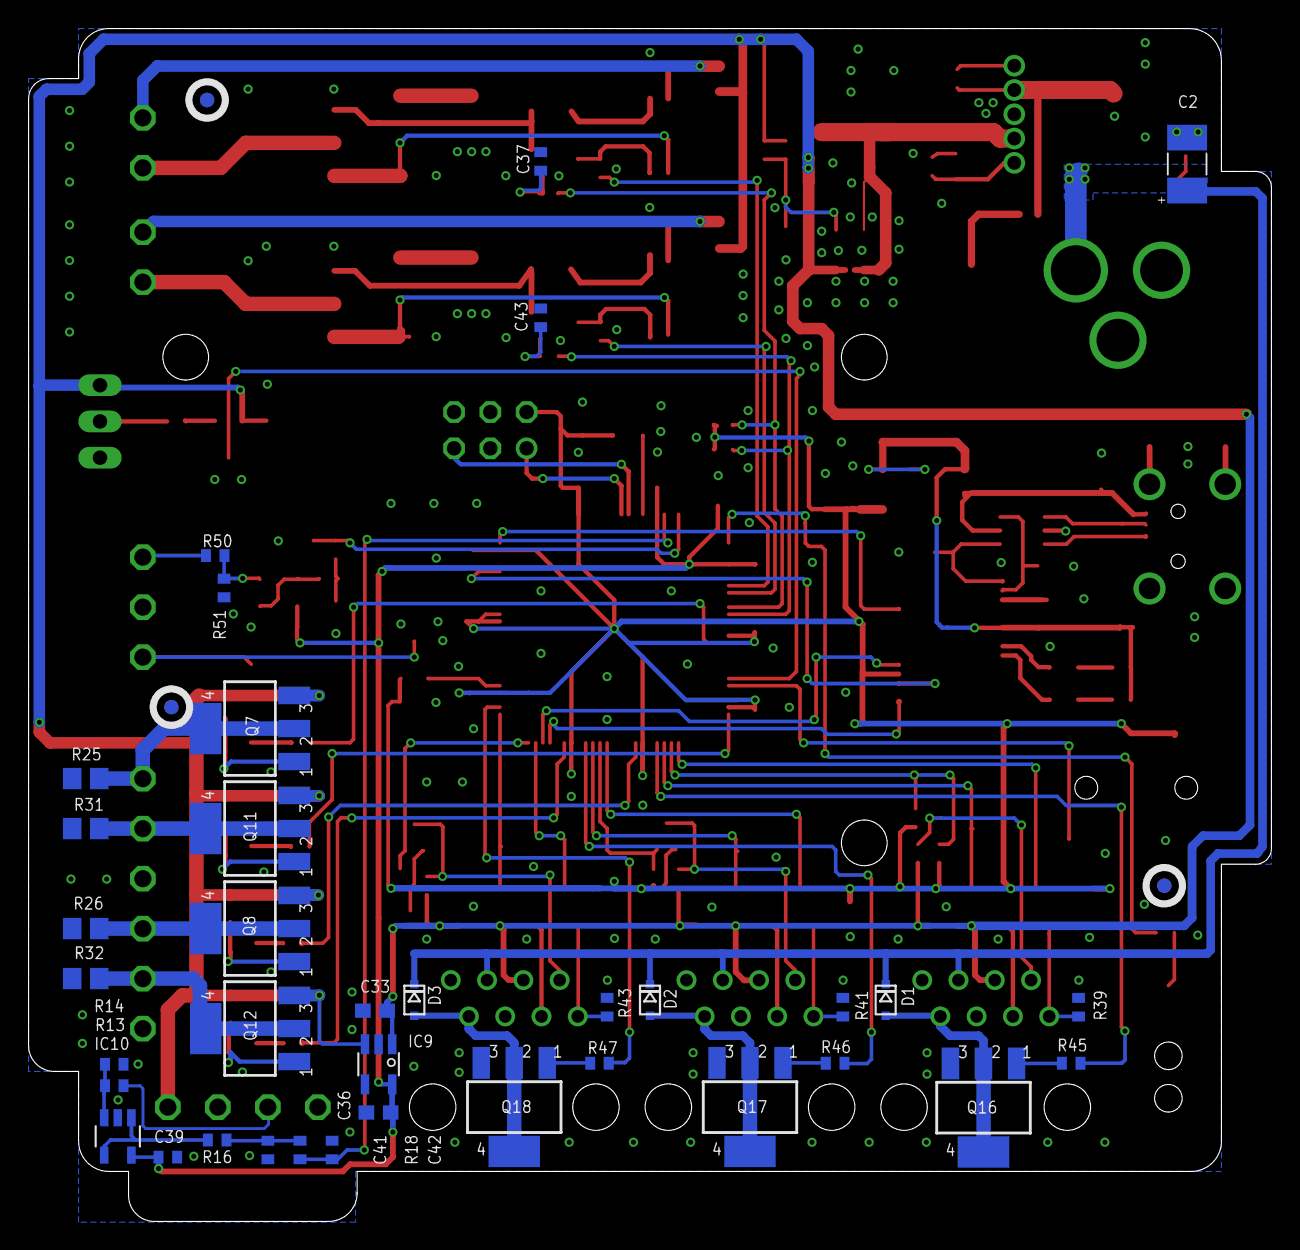
[picture p20: board harp behavior.brd from below]

Board: 2 copper layers, 87.0 x 83.5 mm, 184 parts (39 on the bottom side), 113 nets.

Other parts of the board:
U$1: LED_PIPE_7513D2-L
U$2, U$3, U$4, U$5, U$6, U$7: FIDUCIAL
U$9: LOGO_6
