harp-tech/device.behavior/device.yml

%YAML 1.1
---
# yaml-language-server: $schema=https://harp-tech.org/draft-02/schema/device.json
device: Behavior
whoAmI: 1216
firmwareVersion: "3.4"
hardwareTargets: "2.0"
registers:
  DigitalInputState:
    address: 32
    access: Event
    type: U8
    maskType: DigitalInputs
    description: Reflects the state of DI digital lines of each Port
  Reserved0: &reserved
    address: 33
    type: U8
    access: Read
    description: Reserved for future use
    visibility: private
  OutputSet: &output
    address: 34
    type: U16
    access: Write
    maskType: DigitalOutputs
    description: Set the specified digital output lines.
  OutputClear:
    <<: *output
    address: 35
    description: Clear the specified digital output lines
  OutputToggle:
    <<: *output
    address: 36
    description: Toggle the specified digital output lines
  OutputState:
    <<: *output
    address: 37
    description: Write the state of all digital output lines
  PortDIOSet: &portDIO
    address: 38
    type: U8
    access: Write
    maskType: PortDIOLines
    description: Set the specified port DIO lines. This functionality has not yet been implemented.
  PortDIOClear:
    <<: *portDIO
    address: 39
    description: Clear the specified port DIO lines. This functionality has not yet been implemented.
  PortDIOToggle:
    <<: *portDIO
    address: 40
    description: Toggle the specified port DIO lines. This functionality has not yet been implemented.
  PortDIOState:
    <<: *portDIO
    address: 41
    description: Write the state of all port DIO lines. This functionality has not yet been implemented.
  PortDIODirection:
    <<: *portDIO
    address: 42
    description: Specifies which of the port DIO lines are outputs. This functionality has not yet been implemented.
  PortDIOStateEvent:
    <<: *portDIO
    address: 43
    access: Event
    description: Specifies the state of the port DIO lines on a line change
  AnalogData:
    address: 44
    type: S16
    length: 3
    access: Event
    description: Voltage at the ADC input and encoder value on Port 2
    payloadSpec:
      AnalogInput0:
        offset: 0
        description: The voltage at the output of the ADC channel 0.
      Encoder:
        offset: 1
        description: The quadrature counter value on Port 2
      AnalogInput1:
        offset: 2
        description: The voltage at the output of the ADC channel 1.
  OutputPulseEnable:
    <<: *output
    address: 45
    defaultValue: 56
    description: Enables the pulse function for the specified output lines
  PulseDOPort0: &pulseDO
    address: 46
    type: U16
    access: Write
    defaultValue: 500
    minValue: 1
    description: Specifies the duration of the output pulse in milliseconds.
  PulseDOPort1:
    <<: *pulseDO
    address: 47
  PulseDOPort2:
    <<: *pulseDO
    address: 48
  PulseSupplyPort0:
    <<: *pulseDO
    address: 49
    defaultValue: 15
  PulseSupplyPort1:
    <<: *pulseDO
    address: 50
    defaultValue: 15
  PulseSupplyPort2:
    <<: *pulseDO
    address: 51
    defaultValue: 15
  PulseLed0:
    <<: *pulseDO
    address: 52
  PulseLed1:
    <<: *pulseDO
    address: 53
  PulseRgb0:
    <<: *pulseDO
    address: 54
  PulseRgb1:
    <<: *pulseDO
    address: 55
  PulseDO0:
    <<: *pulseDO
    address: 56
    defaultValue: 250
  PulseDO1:
    <<: *pulseDO
    address: 57
    defaultValue: 250
  PulseDO2:
    <<: *pulseDO
    address: 58
    defaultValue: 250
  PulseDO3:
    <<: *pulseDO
    address: 59
    defaultValue: 250
  PwmFrequencyDO0: &pwmFreq
    address: 60
    type: U16
    access: Write
    defaultValue: 1000
    minValue: 1
    maxValue: 10000
    description: Specifies the frequency of the PWM at DO0.
  PwmFrequencyDO1:
    <<: *pwmFreq
    address: 61
    defaultValue: 2000
    description: Specifies the frequency of the PWM at DO1.
  PwmFrequencyDO2:
    <<: *pwmFreq
    address: 62
    defaultValue: 3000
    description: Specifies the frequency of the PWM at DO2.
  PwmFrequencyDO3:
    <<: *pwmFreq
    address: 63
    defaultValue: 4000
    description: Specifies the frequency of the PWM at DO3.
  PwmDutyCycleDO0: &pwmDutyCycle
    address: 64
    type: U8
    access: Write
    defaultValue: 50
    minValue: 1
    maxValue: 99
    description: Specifies the duty cycle of the PWM at DO0.
  PwmDutyCycleDO1:
    <<: *pwmDutyCycle
    address: 65
    description: Specifies the duty cycle of the PWM at DO1.
  PwmDutyCycleDO2:
    <<: *pwmDutyCycle
    address: 66
    description: Specifies the duty cycle of the PWM at DO2.
  PwmDutyCycleDO3:
    <<: *pwmDutyCycle
    address: 67
    description: Specifies the duty cycle of the PWM at DO3.
  PwmStart: &pwmStartStop
    address: 68
    type: U8
    access: Write
    maskType: PwmOutputs
    description: Starts the PWM on the selected output lines.
  PwmStop:
    <<: *pwmStartStop
    address: 69
    description: Stops the PWM on the selected output lines.
  RgbAll:
    address: 70
    type: &rgbType U8
    length: 6
    access: &rgbAccess Write
    description: Specifies the state of all RGB LED channels.
    payloadSpec:
      Green0:
        offset: 0
        description: The intensity of the green channel in the RGB0 LED.
      Red0:
        offset: 1
        description: The intensity of the red channel in the RGB0 LED.
      Blue0:
        offset: 2
        description: The intensity of the blue channel in the RGB0 LED.
      Green1:
        offset: 3
        description: The intensity of the green channel in the RGB1 LED.
      Red1:
        offset: 4
        description: The intensity of the red channel in the RGB1 LED.
      Blue1:
        offset: 5
        description: The intensity of the blue channel in the RGB1 LED.
  Rgb0: &rgbRegister
    address: 71
    type: *rgbType
    length: 3
    access: *rgbAccess
    description: Specifies the state of the RGB0 LED channels.
    interfaceType: RgbPayload
    payloadSpec:
      Green:
        offset: 0
        description: The intensity of the green channel in the RGB LED.
      Red:
        offset: 1
        description: The intensity of the red channel in the RGB LED.
      Blue:
        offset: 2
        description: The intensity of the blue channel in the RGB LED.
  Rgb1:
    <<: *rgbRegister
    address: 72
    description: Specifies the state of the RGB1 LED channels.
  Led0Current: &ledCurrent
    address: 73
    type: U8
    access: Write
    defaultValue: 10
    minValue: 2
    maxValue: 100
    description: Specifies the configuration of current to drive LED 0.
  Led1Current:
    <<: *ledCurrent
    address: 74
    description: Specifies the configuration of current to drive LED 1.
  Led0MaxCurrent: &ledMaxCurrent
    address: 75
    type: U8
    access: Write
    defaultValue: 30
    minValue: 5
    maxValue: 100
    description: Specifies the maximum current allowed to drive LED 0, in mA.
  Led1MaxCurrent:
    <<: *ledMaxCurrent
    address: 76
    description: Specifies the maximum current allowed to drive LED 1, in mA.
  EventEnable:
    address: 77
    type: U8
    access: Write
    maskType: Events
    defaultValue: 31
    description: Specifies the active events in the device.
  StartCameras: &cameraControl
    address: 78
    type: U8
    access: Write
    maskType: CameraOutputs
    description: Specifies the camera outputs to enable in the device.
  StopCameras:
    <<: *cameraControl
    access: [Write, Event]
    address: 79
    description: Specifies the camera outputs to disable in the device. An event will be issued when the trigger signal is actually stopped being generated.
  EnableServos: &servoControl
    address: 80
    type: U8
    access: Write
    maskType: ServoOutputs
    description: Specifies the servo outputs to enable in the device.
  DisableServos:
    <<: *servoControl
    address: 81
    description: Specifies the servo outputs to disable in the device.
  EnableEncoders:
    address: 82
    type: U8
    access: Write
    maskType: EncoderInputs
    description: Specifies the port quadrature counters to enable in the device.
  EncoderMode:
    address: 83
    type: U8
    access: Write
    maskType: EncoderModeMask
    description: Configures the operation mode of the quadrature encoders.
  Reserved2:
    <<: *reserved
    address: 84
  Reserved3:
    <<: *reserved
    address: 85
  Reserved4:
    <<: *reserved
    address: 86
  Reserved5:
    <<: *reserved
    address: 87
  Reserved6:
    <<: *reserved
    address: 88
  Reserved7:
    <<: *reserved
    address: 89
  Reserved8:
    <<: *reserved
    address: 90
  Reserved9:
    <<: *reserved
    address: 91
  Camera0Frame: &frameAcquired
    address: 92
    type: U8
    access: Event
    maskType: FrameAcquired
    description: Specifies that a frame was acquired on camera 0.
  Camera0Frequency: &cameraFreq
    address: 93
    type: U16
    access: Write
    defaultValue: 30
    minValue: 2
    maxValue: 600
    description: Specifies the trigger frequency for camera 0.
  Camera1Frame:
    <<: *frameAcquired
    address: 94
    description: Specifies that a frame was acquired on camera 1.
  Camera1Frequency:
    <<: *cameraFreq
    address: 95
    description: Specifies the trigger frequency for camera 1.
  Reserved10:
    <<: *reserved
    address: 96
  Reserved11:
    <<: *reserved
    address: 97
  Reserved12:
    <<: *reserved
    address: 98
  Reserved13:
    <<: *reserved
    address: 99
  ServoMotor2Period: &servoPeriod
    address: 100
    type: U16
    access: Write
    defaultValue: 20000
    minValue: 2
    maxValue: 65534
    description: Specifies the period of the servo motor in DO2, in microseconds.
  ServoMotor2Pulse: &servoPulse
    address: 101
    type: U16
    access: Write
    defaultValue: 1500
    minValue: 6
    maxValue: 65530
    description: Specifies the pulse of the servo motor in DO2, in microseconds.
  ServoMotor3Period:
    <<: *servoPeriod
    address: 102
    description: Specifies the period of the servo motor in DO3, in microseconds.
  ServoMotor3Pulse:
    <<: *servoPulse
    address: 103
    description: Specifies the pulse of the servo motor in DO3, in microseconds.
  Reserved14:
    <<: *reserved
    address: 104
  Reserved15:
    <<: *reserved
    address: 105
  Reserved16:
    <<: *reserved
    address: 106
  Reserved17:
    <<: *reserved
    address: 107
  EncoderReset:
    address: 108
    type: U8
    access: Write
    maskType: EncoderInputs
    description: Reset the counter of the specified encoders to zero.
  Reserved18:
    <<: *reserved
    address: 109
  EnableSerialTimestamp:
    address: 110
    type: U8
    access: Write
    maskType: SerialTimestampPorts
    description: Enables the timestamp for serial TX.
  MimicPort0IR: &mimic
    address: 111
    type: U8
    access: Write
    maskType: MimicOutput
    description: Specifies the digital output to mimic the Port 0 IR state.
  MimicPort1IR:
    <<: *mimic
    address: 112
    description: Specifies the digital output to mimic the Port 1 IR state.
  MimicPort2IR:
    <<: *mimic
    address: 113
    description: Specifies the digital output to mimic the Port 2 IR state.
  Reserved20:
    <<: *reserved
    address: 114
  Reserved21:
    <<: *reserved
    address: 115
  Reserved22:
    <<: *reserved
    address: 116
  MimicPort0Valve:
    <<: *mimic
    address: 117
    description: Specifies the digital output to mimic the Port 0 valve state.
  MimicPort1Valve:
    <<: *mimic
    address: 118
    description: Specifies the digital output to mimic the Port 1 valve state.
  MimicPort2Valve:
    <<: *mimic
    address: 119
    description: Specifies the digital output to mimic the Port 2 valve state.
  Reserved23:
    <<: *reserved
    address: 120
  Reserved24:
    <<: *reserved
    address: 121
  PokeInputFilter:
    address: 122
    type: U8
    access: Write
    defaultValue: 1
    description: Specifies the low pass filter time value for poke inputs, in ms.
bitMasks:
  DigitalInputs:
    description: Specifies the state of port digital input lines.
    bits:
      DIPort0:
        value: 0x1
        description: Port 0 digital input
      DIPort1:
        value: 0x2
        description: Port 1 digital input
      DIPort2:
        value: 0x4
        description: Port 2 digital input
      DI3:
        value: 0x8
        description: Digital input DI3
  DigitalOutputs:
    description: Specifies the state of port digital output lines.
    bits:
      DOPort0:
        value: 0x1
        description: Port 0 digital output
      DOPort1:
        value: 0x2
        description: Port 1 digital output
      DOPort2:
        value: 0x4
        description: Port 2 digital output
      SupplyPort0:
        value: 0x8
        description: Port 0 12 V output for valve control
      SupplyPort1:
        value: 0x10
        description: Port 1 12 V output for valve control
      SupplyPort2:
        value: 0x20
        description: Port 2 12 V output for valve control
      Led0:
        value: 0x40
        description: LED output L0
      Led1:
        value: 0x80
        description: LED output L1
      Rgb0:
        value: 0x100
        description: RGB LED 0 on the RGB connector
      Rgb1:
        value: 0x200
        description: RGB LED 1 on the RGB connector
      DO0:
        value: 0x400
        description: Digital output DO0
      DO1:
        value: 0x800
        description: Digital output DO1
      DO2:
        value: 0x1000
        description: Digital output DO2
      DO3:
        value: 0x2000
        description: Digital output DO3
  PortDIOLines:
    description: Specifies the state of the port DIO lines.
    bits:
      DIO0:
        value: 0x1
        description: Port 0 DIO line
      DIO1:
        value: 0x2
        description: Port 1 DIO line
      DIO2:
        value: 0x4
        description: Port 2 DIO line
  PwmOutputs:
    description: Specifies the state of PWM output lines.
    bits:
      PwmDO0:
        value: 0x1
        description: PWM on digital output DO0
      PwmDO1:
        value: 0x2
        description: PWM on digital output DO1
      PwmDO2:
        value: 0x4
        description: PWM on digital output DO2
      PwmDO3:
        value: 0x8
        description: PWM on digital output DO3
  Events:
    description: Specifies the active events in the device.
    bits:
      PortDI:
        value: 0x1
        description: Event from register DigitalInputState
      PortDIO:
        value: 0x2
        description: Event from register PortDIOStateEvent
      AnalogData:
        value: 0x4
        description: Event from register AnalogData
      Camera0:
        value: 0x8
        description: Event from register Camera0Frame
      Camera1:
        value: 0x10
        description: Event from register Camera1Frame
  CameraOutputs:
    description: Specifies camera output enable bits.
    bits:
      CameraOutput0:
        value: 0x1
        description: Camera on digital output 0
      CameraOutput1:
        value: 0x2
        description: Camera on digital output 1
  ServoOutputs:
    description: Specifies servo output enable bits.
    bits:
      ServoOutput2:
        value: 0x4
        description: Servo on digital output 2
      ServoOutput3:
        value: 0x8
        description: Servo on digital output 3
  EncoderInputs:
    description: Specifies quadrature counter enable bits.
    bits:
      EncoderPort2:
        value: 0x4
        description: Encoder on port 2
  FrameAcquired:
    description: Specifies that camera frame was acquired.
    bits:
      FrameAcquired:
        value: 0x1
        description: Camera frame was triggered
  SerialTimestampPorts:
    description: Specifies available timestamp TX ports.
    bits:
      TimestampPort2:
        value: 0x4
        description: Enable the serial timestamp TX on Port 2
groupMasks:
  MimicOutput:
    description: Specifies the target IO on which to mimic the specified register.
    values:
      None:
        value: 0
        description: Is not reflected on any output
      DIO0:
        value: 1
        description: Is reflected on DIO0
      DIO1:
        value: 2
        description: Is reflected on DIO1
      DIO2:
        value: 3
        description: Is reflected on DIO2
      DO0:
        value: 4
        description: Is reflected on DO0
      DO1:
        value: 5
        description: Is reflected on DO1
      DO2:
        value: 6
        description: Is reflected on DO2
      DO3:
        value: 7
        description: Is reflected on DO3
  EncoderModeMask:
    description: Specifies the type of reading made from the quadrature encoder.
    values:
      Position:
        value: 0
        description: The accumulated encoder count
      Displacement:
        value: 1
        description: The change in encoder count since the previous sample
