harp-tech/device.behavior/firmware/Behavior/app.c

#include "hwbp_core.h"
#include "hwbp_core_regs.h"
#include "hwbp_core_types.h"

#include "cpu.h"
#include "app.h"
#include "app_funcs.h"
#include "app_ios_and_regs.h"
#include "mimic.h"

#include "WS2812S.h"
#include "structs.h"

#define F_CPU 32000000
#include <util/delay.h>


/************************************************************************/
/* Declare application registers                                        */
/************************************************************************/
extern AppRegs app_regs;
extern uint8_t app_regs_type[];
extern uint16_t app_regs_n_elements[];
extern uint8_t *app_regs_pointer[];
extern void (*app_func_rd_pointer[])(void);
extern bool (*app_func_wr_pointer[])(void*);


/************************************************************************/
/* Initialize app                                                       */
/************************************************************************/
static const uint8_t default_device_name[] = DEVICE_NAME;

void hwbp_app_initialize(void)
{
    /* Start core */
    core_func_start_core_V2(
        WHO_AM_I,
        MAJOR_HW_VERSION, MINOR_HW_VERSION, PATCH_HW_VERSION,
        MAJOR_FW_VERSION, MINOR_FW_VERSION, PATCH_FW_VERSION,
        (uint8_t*)(&app_regs),
        APP_NBYTES_OF_REG_BANK,
        APP_REGS_ADD_MAX - APP_REGS_ADD_MIN + 1,
        default_device_name,
        false,  // The device is _not_ able to repeat the harp timestamp clock
        false,  // The device is _not_ able to generate the harp timestamp clock
        0       // Default timestamp offset
    );
}

/************************************************************************/
/* Handle if a catastrophic error occur                                 */
/************************************************************************/
void core_callback_catastrophic_error_detected(void)
{
    uint8_t led[3] = {0, 0, 0};

    timer_type0_stop(&TCF0); clr_DO0;
    timer_type0_stop(&TCE0); clr_DO1;
    timer_type0_stop(&TCD0); clr_DO2;
    timer_type0_stop(&TCC0); clr_DO3;

    clr_LED0;
    clr_LED1;

    PMIC_CTRL = PMIC_RREN_bm | PMIC_LOLVLEN_bm;
    update_2rgbs(led, led);
    //update_3rgbs(led, led, led);
    PMIC_CTRL = PMIC_RREN_bm | PMIC_LOLVLEN_bm | PMIC_MEDLVLEN_bm | PMIC_HILVLEN_bm;

    clr_POKE0_LED;
    clr_POKE1_LED;
    clr_POKE2_LED;

    close_POKE0_VALVE;
    close_POKE1_VALVE;
    close_POKE2_VALVE;

    // To do: Clear Pokes DIOs
}

/************************************************************************/
/* General definitions                                                  */
/************************************************************************/
countdown_t pulse_countdown;

/************************************************************************/
/* General used functions                                               */
/************************************************************************/

/************************************************************************/
/* Initialization Callbacks                                             */
/************************************************************************/
int16_t AdcOffset;
#define ADC_OFFSET_CONSECUTIVE_EQUAL_READINGS 8

#define DAC_GAINCAL 0x83
#define DAC_OFFSETCAL 0x85

void core_callback_define_clock_default(void) {}

void core_callback_initialize_hardware(void)
{
    uint16_t adc[ADC_OFFSET_CONSECUTIVE_EQUAL_READINGS];

    /* Initialize IOs */
    /* Don't delete this function!!! */
    init_ios();

    /* Initialize LEDs digital line */
    initialize_rgb();

    /* Configure DAC calibration using default values */
    DACA.CH0GAINCAL = DAC_GAINCAL;
    DACA.CH0OFFSETCAL = DAC_OFFSETCAL;
    DACB.CH0GAINCAL = DAC_GAINCAL;
    DACB.CH0OFFSETCAL = DAC_OFFSETCAL;

    /* Initialize DACB dual channel using internal 1V as reference */
    DACB.CTRLB = DAC_CHSEL_DUAL_gc;
    DACB.CTRLC = DAC_REFSEL_INT1V_gc;
    DACB.CTRLA = DAC_CH0EN_bm | DAC_CH1EN_bm | DAC_ENABLE_bm;

    /* Initialize ADCA with single ended input */
    adc_A_initialize_single_ended(ADC_REFSEL_INTVCC_gc);       // VCC/1.6 = 3.3/1.6 = 2.0625 V
    ADCA_CH0_INTCTRL |= ADC_CH_INTLVL_LO_gc;                   // Enable ADC0 interrupt
    _delay_ms(100);

    /* Save ADC offset */
    bool reading_adc_offset = true;

    ADCA_CH0_MUXCTRL = 1 << 3;                                 // Select pin 1

    do
    {
        for (uint8_t i = 0; i < ADC_OFFSET_CONSECUTIVE_EQUAL_READINGS; i++)
        {
            ADCA_CH0_CTRL |= ADC_CH_START_bm;                  // Start conversion
            while(!(ADCA_CH0_INTFLAGS & ADC_CH_CHIF_bm));      // Wait for conversion to finish
            ADCA_CH0_INTFLAGS = ADC_CH_CHIF_bm;                // Clear interrupt bit
            adc[i] = ADCA_CH0_RES;                             // Save offset
        }

        reading_adc_offset = false;

        for (uint8_t i = 0; i < ADC_OFFSET_CONSECUTIVE_EQUAL_READINGS-1; i++)
        {
            if (adc[i] != adc[i+1])
            {
                reading_adc_offset |= true;
            }
        }
    } while (reading_adc_offset);

    AdcOffset = adc[0];
}

void core_callback_reset_registers(void)
{
    //app_regs.REG_PORTS_IN = 0;
    //app_regs.REG_POKE_DIG_IN = 0;

    app_regs.REG_OUTPUT_SET = 0;
    app_regs.REG_OUTPUT_CLEAR = 0;
    app_regs.REG_OUTPUT_TOGGLE = 0;
    app_regs.REG_OUTPUT_STATE = 0;

    app_regs.REG_PORT_DIO_SET = 0;
    app_regs.REG_PORT_DIO_CLEAR = 0;
    app_regs.REG_PORT_DIO_TOGGLE = 0;
    app_regs.REG_PORT_DIO_STATE = 0;
    app_regs.REG_PORT_DIO_DIRECTION = 0; // All as inputs
    //app_regs.REG_PORT_DIO_STATE_EVENT = 0;

    //app_regs.REG_ANALOG_DATA[0] = 0;
    app_regs.REG_ANALOG_DATA[1] = 0;

    app_regs.REG_OUTPUT_PULSE_ENABLE = B_SUPPLY_PORT0 | B_SUPPLY_PORT1 | B_SUPPLY_PORT2;

    app_regs.REG_PULSE_DO_PORT0 = 500;
    app_regs.REG_PULSE_DO_PORT1 = 500;
    app_regs.REG_PULSE_DO_PORT2 = 500;
    app_regs.REG_PULSE_SUPPLY_PORT0 = 15;
    app_regs.REG_PULSE_SUPPLY_PORT1 = 15;
    app_regs.REG_PULSE_SUPPLY_PORT2 = 15;
    app_regs.REG_PULSE_LED0 = 500;
    app_regs.REG_PULSE_LED1 = 500;
    app_regs.REG_PULSE_RGB0 = 500;
    app_regs.REG_PULSE_RGB1 = 500;
    app_regs.REG_PULSE_DO0 = 250;
    app_regs.REG_PULSE_DO1 = 250;
    app_regs.REG_PULSE_DO2 = 250;
    app_regs.REG_PULSE_DO3 = 250;

    app_regs.REG_PWM_FREQUENCY_DO0 = 1000;
    app_regs.REG_PWM_FREQUENCY_DO1 = 2000;
    app_regs.REG_PWM_FREQUENCY_DO2 = 3000;
    app_regs.REG_PWM_FREQUENCY_DO3 = 4000;

    app_regs.REG_PWM_DUTY_CYCLE_DO0 = 50;
    app_regs.REG_PWM_DUTY_CYCLE_DO1 = 50;
    app_regs.REG_PWM_DUTY_CYCLE_DO2 = 50;
    app_regs.REG_PWM_DUTY_CYCLE_DO3 = 50;

    app_regs.REG_PWM_START = 0;
    app_regs.REG_PWM_STOP = 0;

    app_regs.REG_RGB_ALL[0] = 255;  // Green
    app_regs.REG_RGB_ALL[1] = 0;    // Red
    app_regs.REG_RGB_ALL[2] = 0;    // Blue
    app_regs.REG_RGB_ALL[3] = 0;    // Green
    app_regs.REG_RGB_ALL[4] = 0;    // Red
    app_regs.REG_RGB_ALL[5] = 255;  // Blue

    app_regs.REG_RGB0[0] = 255;  // Green
    app_regs.REG_RGB0[1] = 0;    // Red
    app_regs.REG_RGB0[2] = 0;    // Blue

    app_regs.REG_RGB1[0] = 0;    // Green
    app_regs.REG_RGB1[1] = 0;    // Red
    app_regs.REG_RGB1[2] = 255;  // Blue

    app_regs.REG_LED0_CURRENT = 10;
    app_regs.REG_LED1_CURRENT = 10;
    app_regs.REG_LED0_MAX_CURRENT = 30;
    app_regs.REG_LED1_MAX_CURRENT = 30;

    app_regs.REG_EVENT_ENABLE = B_PORT_DI | B_PORT_DIO | B_ANALOG_DATA | B_CAMERA0 | B_CAMERA1;

    app_regs.REG_START_CAMERAS = 0;
    app_regs.REG_STOP_CAMERAS = 0;
    app_regs.REG_ENABLE_SERVOS = 0;
    app_regs.REG_DISABLE_SERVOS = 0;
    app_regs.REG_ENABLE_ENCODERS = 0;

    app_regs.REG_CAMERA0_FREQUENCY = 30;
    app_regs.REG_CAMERA1_FREQUENCY = 30;

    app_regs.REG_SERVO_MOTOR2_PERIOD = 20000;
    app_regs.REG_SERVO_MOTOR2_PULSE = 1500;
    app_regs.REG_SERVO_MOTOR3_PERIOD = 20000;
    app_regs.REG_SERVO_MOTOR3_PULSE = 1500;

    app_regs.REG_POKE_INPUT_FILTER = 1;
}

extern ports_state_t _states_;

void core_callback_registers_were_reinitialized(void)
{
    uint8_t aux8b;
    uint16_t aux16b;

    _states_.pwm.do0 = false;
    _states_.pwm.do1 = false;
    _states_.pwm.do2 = false;
    _states_.pwm.do3 = false;
    _states_.camera.do0 = false;
    _states_.camera.do1 = false;
    _states_.camera.do2 = false;
    _states_.camera.do3 = false;
    _states_.servo.do0 = false;
    _states_.servo.do1 = false;
    _states_.servo.do2 = false;
    _states_.servo.do3 = false;
    _states_.quad_counter.port0 = false;
    _states_.quad_counter.port1 = false;
    _states_.quad_counter.port2 = false;

    aux16b  = app_regs.REG_OUTPUT_STATE;
    app_write_REG_OUTPUT_STATE(&aux16b);

    aux8b = app_regs.REG_LED0_CURRENT;
    app_write_REG_LED0_CURRENT(&aux8b);
    aux8b = app_regs.REG_LED1_CURRENT;
    app_write_REG_LED1_CURRENT(&aux8b);

    aux16b = app_regs.REG_PWM_FREQUENCY_DO0;
    app_write_REG_PWM_FREQUENCY_DO0(&aux16b);
    aux16b = app_regs.REG_PWM_FREQUENCY_DO1;
    app_write_REG_PWM_FREQUENCY_DO1(&aux16b);
    aux16b = app_regs.REG_PWM_FREQUENCY_DO2;
    app_write_REG_PWM_FREQUENCY_DO2(&aux16b);
    aux16b = app_regs.REG_PWM_FREQUENCY_DO3;
    app_write_REG_PWM_FREQUENCY_DO3(&aux16b);

    aux8b = app_regs.REG_PWM_START;
    app_write_REG_PWM_START(&aux8b);

    aux8b = app_regs.REG_ENABLE_ENCODERS;
    app_write_REG_ENABLE_ENCODERS(&aux8b);

    aux8b = app_regs.REG_MIMIC_PORT0_IR;
    app_write_REG_MIMIC_PORT0_IR(&aux8b);
    aux8b = app_regs.REG_MIMIC_PORT1_IR;
    app_write_REG_MIMIC_PORT1_IR(&aux8b);
    aux8b = app_regs.REG_MIMIC_PORT2_IR;
    app_write_REG_MIMIC_PORT2_IR(&aux8b);

    aux8b = app_regs.REG_MIMIC_PORT0_VALVE;
    app_write_REG_MIMIC_PORT0_VALVE(&aux8b);
    aux8b = app_regs.REG_MIMIC_PORT1_VALVE;
    app_write_REG_MIMIC_PORT1_VALVE(&aux8b);
    aux8b = app_regs.REG_MIMIC_PORT2_VALVE;
    app_write_REG_MIMIC_PORT2_VALVE(&aux8b);

    app_regs.REG_POKE_INPUT_FILTER = 1;
}

/************************************************************************/
/* Callbacks: Visualization                                             */
/************************************************************************/
void core_callback_visualen_to_on(void) {}
void core_callback_visualen_to_off(void) {}

/************************************************************************/
/* Callbacks: Change to the operation mode                              */
/************************************************************************/
extern bool stop_camera_do0;
extern bool stop_camera_do1;

void core_callback_device_to_standby(void)
{
    if (_states_.camera.do0)
    {
        stop_camera_do0 = false;

        clr_DO0;
        timer_type0_stop(&TCF0);
        _states_.camera.do0 = false;
    }

    if (_states_.camera.do1)
    {
        stop_camera_do1 = false;

        clr_DO1;
        timer_type0_stop(&TCE0);
        _states_.camera.do1 = false;
    }
}
void core_callback_device_to_active(void) {}
void core_callback_device_to_enchanced_active(void) {}
void core_callback_device_to_speed(void) {}

/************************************************************************/
/* Callbacks: 1 ms timer                                                */
/************************************************************************/
extern void handle_Rgbs(bool use_rgb0, bool use_rgb1);
extern void timestamp_tx_streaming(void);

extern bool rgb0_on;
extern bool rgb1_on;

uint8_t t1ms = 0;

bool first_adc_channel;

int16_t previous_encoder_poke2;

void core_callback_t_before_exec(void)
{
    if (t1ms++ & 1)
    {
        /* Read ADC */
        core_func_mark_user_timestamp();

        /* Start conversation on ADCA Channel 0*/
        first_adc_channel = true;
        ADCA_CH0_MUXCTRL = 0 << 3;
        ADCA_CH0_CTRL |= ADC_CH_START_bm;

        /* Read encoder on Port 2 */
        if (app_regs.REG_ENABLE_ENCODERS & B_ENCODER_PORT2)
        {
            int16_t timer_cnt = TCD1_CNT;

            if (app_regs.REG_ENCODER_MODE == GM_ENCODER_MODE_POSITION)
            {
                if (timer_cnt > 32768)
                {
                    app_regs.REG_ANALOG_DATA[1] = 0xFFFF - timer_cnt;
                }
                else
                {
                    app_regs.REG_ANALOG_DATA[1] = (32768 - timer_cnt) * -1;
                }
            }
            else
            {
                app_regs.REG_ANALOG_DATA[1] = previous_encoder_poke2 - timer_cnt;

                previous_encoder_poke2 = timer_cnt;
            }

        }
    }
}

void core_callback_t_after_exec(void){}
void core_callback_t_new_second(void)
{
    /* Xmit current timestamp through serial */
    timestamp_tx_streaming();

    t1ms = 0;
}

void core_callback_t_500us(void)
{
    bool prev_rgb0_on, prev_rgb1_on;
    prev_rgb0_on = rgb0_on;
    prev_rgb1_on = rgb1_on;

    if (pulse_countdown.poke0_led > 0)
        if (--pulse_countdown.poke0_led == 0)
            clr_POKE0_LED;
    if (pulse_countdown.poke1_led > 0)
        if (--pulse_countdown.poke1_led == 0)
            clr_POKE1_LED;
    if (pulse_countdown.poke2_led > 0)
        if (--pulse_countdown.poke2_led == 0)
            clr_POKE2_LED;

    if (pulse_countdown.poke0_valve > 0)
        if (--pulse_countdown.poke0_valve == 0)
            close_POKE0_VALVE;
    if (pulse_countdown.poke1_valve > 0)
        if (--pulse_countdown.poke1_valve == 0)
            close_POKE1_VALVE;
    if (pulse_countdown.poke2_valve > 0)
        if (--pulse_countdown.poke2_valve == 0)
            close_POKE2_VALVE;

    if (pulse_countdown.led0 > 0)
        if (--pulse_countdown.led0 == 0)
            clr_LED0;
    if (pulse_countdown.led1 > 0)
        if (--pulse_countdown.led1 == 0)
            clr_LED1;

    if (pulse_countdown.rgb0 > 0)
        if (--pulse_countdown.rgb0 == 0)
            rgb0_on = false;
    if (pulse_countdown.rgb1 > 0)
        if (--pulse_countdown.rgb1 == 0)
            rgb1_on = false;

    if ((prev_rgb0_on != rgb0_on) || (prev_rgb1_on != rgb1_on))
    {
        handle_Rgbs(rgb0_on, rgb1_on);
    }

    if (pulse_countdown.do0 > 0)
        if (--pulse_countdown.do0 == 0)
        {
            clr_DO0;
            if (_states_.pwm.do0)
            {
                _states_.pwm.do0 = false;
                timer_type0_stop(&TCF0);
            }
        }
    if (pulse_countdown.do1 > 0)
        if (--pulse_countdown.do1 == 0)
        {
            clr_DO1;
            if (_states_.pwm.do1)
            {
                _states_.pwm.do1 = false;
                timer_type0_stop(&TCE0);
            }
        }
    if (pulse_countdown.do2 > 0)
        if (--pulse_countdown.do2 == 0)
        {
            clr_DO2;
            if (_states_.pwm.do2)
            {
                _states_.pwm.do2 = false;
                timer_type0_stop(&TCD0);
            }
        }
    if (pulse_countdown.do3 > 0)
        if (--pulse_countdown.do3 == 0)
        {
            clr_DO3;
            if (_states_.pwm.do3)
            {
                _states_.pwm.do3 = false;
                timer_type0_stop(&TCC0);
            }
        }
}

uint8_t int0_enable_counter = 0;
uint8_t int1_enable_counter = 0;
uint8_t int2_enable_counter = 0;

void core_callback_t_1ms(void)
{
    if (int0_enable_counter)
        if ((--int0_enable_counter) == 0)
            PORTD_INTCTRL |= INT_LEVEL_LOW;

    if (int1_enable_counter)
        if ((--int1_enable_counter) == 0)
            PORTE_INTCTRL |= INT_LEVEL_LOW;

    if (int2_enable_counter)
        if ((--int2_enable_counter) == 0)
            PORTF_INTCTRL |= INT_LEVEL_LOW;
}

/************************************************************************/
/* Callbacks: clock control                                             */
/************************************************************************/
void core_callback_clock_to_repeater(void) {}
void core_callback_clock_to_generator(void) {}
void core_callback_clock_to_unlock(void) {}
void core_callback_clock_to_lock(void) {}

/************************************************************************/
/* Callbacks: uart control                                              */
/************************************************************************/
void core_callback_uart_rx_before_exec(void) {}
void core_callback_uart_rx_after_exec(void) {}
void core_callback_uart_tx_before_exec(void) {}
void core_callback_uart_tx_after_exec(void) {}
void core_callback_uart_cts_before_exec(void) {}
void core_callback_uart_cts_after_exec(void) {}

/************************************************************************/
/* Callbacks: Read app register                                         */
/************************************************************************/
bool core_read_app_register(uint8_t add, uint8_t type)
{
    /* Check if it will not access forbidden memory */
    if (add < APP_REGS_ADD_MIN || add > APP_REGS_ADD_MAX)
        return false;

    /* Check if type matches */
    if (app_regs_type[add-APP_REGS_ADD_MIN] != type)
        return false;

    /* Receive data */
    (*app_func_rd_pointer[add-APP_REGS_ADD_MIN])();

    /* Return success */
    return true;
}

/************************************************************************/
/* Callbacks: Write app register                                        */
/************************************************************************/
bool core_write_app_register(uint8_t add, uint8_t type, uint8_t * content, uint16_t n_elements)
{
    /* Check if it will not access forbidden memory */
    if (add < APP_REGS_ADD_MIN || add > APP_REGS_ADD_MAX)
        return false;

    /* Check if type matches */
    if (app_regs_type[add-APP_REGS_ADD_MIN] != type)
        return false;

    /* Check if the number of elements matches */
    if (app_regs_n_elements[add-APP_REGS_ADD_MIN] != n_elements)
        return false;

    /* Process data and return false if write is not allowed or contains errors */
    return (*app_func_wr_pointer[add-APP_REGS_ADD_MIN])(content);
}
