harp-tech/device.behavior/firmware/Behavior/app_ios_and_regs.c

#include <avr/io.h>
#include "hwbp_core_types.h"
#include "app_ios_and_regs.h"
#include "mimic.h"

extern AppRegs app_regs;

void mimic_ir_or_valve (uint8_t reg, uint8_t what_to_do)
{
    if (reg & MSK_MIMIC_OUTPUT)
    {
        switch (reg)
        {
            case GM_MIMIC_OUTPUT_DO0:  if (what_to_do == _SET_IO_) set_DO0;          if (what_to_do == _CLR_IO_) clr_DO0;            if (what_to_do == _TGL_IO_) tgl_DO0; break;
            case GM_MIMIC_OUTPUT_DO1:  if (what_to_do == _SET_IO_) set_DO1;          if (what_to_do == _CLR_IO_) clr_DO1;            if (what_to_do == _TGL_IO_) tgl_DO1; break;
            case GM_MIMIC_OUTPUT_DO2:  if (what_to_do == _SET_IO_) set_DO2;          if (what_to_do == _CLR_IO_) clr_DO2;            if (what_to_do == _TGL_IO_) tgl_DO2; break;
            case GM_MIMIC_OUTPUT_DO3:  if (what_to_do == _SET_IO_) set_DO3;          if (what_to_do == _CLR_IO_) clr_DO3;            if (what_to_do == _TGL_IO_) tgl_DO3; break;
            case GM_MIMIC_OUTPUT_DIO0: if (what_to_do == _SET_IO_) set_io(PORTD, 5); if (what_to_do == _CLR_IO_) clear_io(PORTD, 5); if (what_to_do == _TGL_IO_) toggle_io(PORTD, 5); break;
            case GM_MIMIC_OUTPUT_DIO1: if (what_to_do == _SET_IO_) set_io(PORTE, 5); if (what_to_do == _CLR_IO_) clear_io(PORTE, 5); if (what_to_do == _TGL_IO_) toggle_io(PORTE, 5); break;
            case GM_MIMIC_OUTPUT_DIO2: if (what_to_do == _SET_IO_) set_io(PORTF, 5); if (what_to_do == _CLR_IO_) clear_io(PORTF, 5); if (what_to_do == _TGL_IO_) toggle_io(PORTF, 5); break;
        }
    }
}


/************************************************************************/
/* Configure and initialize IOs                                         */
/************************************************************************/
void init_ios(void)
{
    /* Configure input pins */
    io_pin2in(&PORTD, 4, PULL_IO_UP, SENSE_IO_EDGES_BOTH);               // POKE0_IR
    io_pin2in(&PORTD, 5, PULL_IO_UP, SENSE_IO_EDGES_BOTH);               // POKE0_IO
    io_pin2in(&PORTE, 4, PULL_IO_UP, SENSE_IO_EDGES_BOTH);               // POKE1_IR
    io_pin2in(&PORTE, 5, PULL_IO_UP, SENSE_IO_EDGES_BOTH);               // POKE1_IO
    io_pin2in(&PORTF, 4, PULL_IO_UP, SENSE_IO_EDGES_BOTH);               // POKE2_IR
    io_pin2in(&PORTF, 5, PULL_IO_UP, SENSE_IO_EDGES_BOTH);               // POKE2_IO
    io_pin2in(&PORTJ, 0, PULL_IO_DOWN, SENSE_IO_EDGES_BOTH);             // ADC1_AVAILABLE
    io_pin2in(&PORTH, 0, PULL_IO_TRISTATE, SENSE_IO_EDGES_BOTH);         // DI3

    /* Configure input interrupts */
    io_set_int(&PORTD, INT_LEVEL_LOW, 0, (3<<4), false);                 // POKE0_IR
    io_set_int(&PORTE, INT_LEVEL_LOW, 0, (3<<4), false);                 // POKE1_IR
    io_set_int(&PORTF, INT_LEVEL_LOW, 0, (3<<4), false);                 // POKE2_IR

    if(read_ADC1_AVAILABLE)
        io_set_int(&PORTH, INT_LEVEL_LOW, 0, (1<<0), false);              // DI3

    /* Configure output pins */
    io_pin2out(&PORTC, 0, OUT_IO_DIGITAL, IN_EN_IO_EN);                  // DO3
    io_pin2out(&PORTD, 0, OUT_IO_DIGITAL, IN_EN_IO_EN);                  // DO2
    io_pin2out(&PORTE, 0, OUT_IO_DIGITAL, IN_EN_IO_EN);                  // DO1
    io_pin2out(&PORTF, 0, OUT_IO_DIGITAL, IN_EN_IO_EN);                  // DO0
    io_pin2out(&PORTB, 6, OUT_IO_DIGITAL, IN_EN_IO_EN);                  // LED0
    io_pin2out(&PORTB, 5, OUT_IO_DIGITAL, IN_EN_IO_EN);                  // LED1
    io_pin2out(&PORTC, 5, OUT_IO_DIGITAL, IN_EN_IO_DIS);                 // RGBS
    io_pin2out(&PORTD, 6, OUT_IO_DIGITAL, IN_EN_IO_EN);                  // POKE0_LED
    io_pin2out(&PORTD, 7, OUT_IO_DIGITAL, IN_EN_IO_EN);                  // POKE0_VALVE
    io_pin2out(&PORTE, 6, OUT_IO_DIGITAL, IN_EN_IO_EN);                  // POKE1_LED
    io_pin2out(&PORTE, 7, OUT_IO_DIGITAL, IN_EN_IO_EN);                  // POKE1_VALVE
    io_pin2out(&PORTF, 6, OUT_IO_DIGITAL, IN_EN_IO_EN);                  // POKE2_LED
    io_pin2out(&PORTF, 7, OUT_IO_DIGITAL, IN_EN_IO_EN);                  // POKE2_VALVE

    /* Initialize output pins */
    clr_DO3;
    clr_DO2;
    clr_DO1;
    clr_DO0;
    clr_LED0;
    clr_LED1;
    clr_RGBS;
    clr_POKE0_LED;
    close_POKE0_VALVE;
    clr_POKE1_LED;
    close_POKE1_VALVE;
    clr_POKE2_LED;
    close_POKE2_VALVE;
}

/************************************************************************/
/* Registers' stuff                                                     */
/************************************************************************/
AppRegs app_regs;

uint8_t app_regs_type[] = {
    TYPE_U8,
    TYPE_U8,
    TYPE_U16,
    TYPE_U16,
    TYPE_U16,
    TYPE_U16,
    TYPE_U8,
    TYPE_U8,
    TYPE_U8,
    TYPE_U8,
    TYPE_U8,
    TYPE_U8,
    TYPE_I16,
    TYPE_U16,
    TYPE_U16,
    TYPE_U16,
    TYPE_U16,
    TYPE_U16,
    TYPE_U16,
    TYPE_U16,
    TYPE_U16,
    TYPE_U16,
    TYPE_U16,
    TYPE_U16,
    TYPE_U16,
    TYPE_U16,
    TYPE_U16,
    TYPE_U16,
    TYPE_U16,
    TYPE_U16,
    TYPE_U16,
    TYPE_U16,
    TYPE_U8,
    TYPE_U8,
    TYPE_U8,
    TYPE_U8,
    TYPE_U8,
    TYPE_U8,
    TYPE_U8,
    TYPE_U8,
    TYPE_U8,
    TYPE_U8,
    TYPE_U8,
    TYPE_U8,
    TYPE_U8,
    TYPE_U8,
    TYPE_U8,
    TYPE_U8,
    TYPE_U8,
    TYPE_U8,
    TYPE_U8,
    TYPE_U8,
    TYPE_U8,
    TYPE_U8,
    TYPE_U8,
    TYPE_U8,
    TYPE_U8,
    TYPE_U8,
    TYPE_U8,
    TYPE_U8,
    TYPE_U8,
    TYPE_U16,
    TYPE_U8,
    TYPE_U16,
    TYPE_U8,
    TYPE_U8,
    TYPE_U8,
    TYPE_U8,
    TYPE_U16,
    TYPE_U16,
    TYPE_U16,
    TYPE_U16,
    TYPE_U8,
    TYPE_U8,
    TYPE_U8,
    TYPE_U8,
    TYPE_U8,
    TYPE_U8,
    TYPE_U8,
    TYPE_U8,
    TYPE_U8,
    TYPE_U8,
    TYPE_U8,
    TYPE_U8,
    TYPE_U8,
    TYPE_U8,
    TYPE_U8,
    TYPE_U8,
    TYPE_U8,
    TYPE_U8,
    TYPE_U8
};

uint16_t app_regs_n_elements[] = {
    1,
    1,
    1,
    1,
    1,
    1,
    1,
    1,
    1,
    1,
    1,
    1,
    3,
    1,
    1,
    1,
    1,
    1,
    1,
    1,
    1,
    1,
    1,
    1,
    1,
    1,
    1,
    1,
    1,
    1,
    1,
    1,
    1,
    1,
    1,
    1,
    1,
    1,
    6,
    3,
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
};

uint8_t *app_regs_pointer[] = {
    (uint8_t*)(&app_regs.REG_DIGITAL_INPUT_STATE),
    (uint8_t*)(&app_regs.REG_RESERVED0),
    (uint8_t*)(&app_regs.REG_OUTPUT_SET),
    (uint8_t*)(&app_regs.REG_OUTPUT_CLEAR),
    (uint8_t*)(&app_regs.REG_OUTPUT_TOGGLE),
    (uint8_t*)(&app_regs.REG_OUTPUT_STATE),
    (uint8_t*)(&app_regs.REG_PORT_DIO_SET),
    (uint8_t*)(&app_regs.REG_PORT_DIO_CLEAR),
    (uint8_t*)(&app_regs.REG_PORT_DIO_TOGGLE),
    (uint8_t*)(&app_regs.REG_PORT_DIO_STATE),
    (uint8_t*)(&app_regs.REG_PORT_DIO_DIRECTION),
    (uint8_t*)(&app_regs.REG_PORT_DIO_STATE_EVENT),
    (uint8_t*)(&app_regs.REG_ANALOG_DATA),
    (uint8_t*)(&app_regs.REG_OUTPUT_PULSE_ENABLE),
    (uint8_t*)(&app_regs.REG_PULSE_DO_PORT0),
    (uint8_t*)(&app_regs.REG_PULSE_DO_PORT1),
    (uint8_t*)(&app_regs.REG_PULSE_DO_PORT2),
    (uint8_t*)(&app_regs.REG_PULSE_SUPPLY_PORT0),
    (uint8_t*)(&app_regs.REG_PULSE_SUPPLY_PORT1),
    (uint8_t*)(&app_regs.REG_PULSE_SUPPLY_PORT2),
    (uint8_t*)(&app_regs.REG_PULSE_LED0),
    (uint8_t*)(&app_regs.REG_PULSE_LED1),
    (uint8_t*)(&app_regs.REG_PULSE_RGB0),
    (uint8_t*)(&app_regs.REG_PULSE_RGB1),
    (uint8_t*)(&app_regs.REG_PULSE_DO0),
    (uint8_t*)(&app_regs.REG_PULSE_DO1),
    (uint8_t*)(&app_regs.REG_PULSE_DO2),
    (uint8_t*)(&app_regs.REG_PULSE_DO3),
    (uint8_t*)(&app_regs.REG_PWM_FREQUENCY_DO0),
    (uint8_t*)(&app_regs.REG_PWM_FREQUENCY_DO1),
    (uint8_t*)(&app_regs.REG_PWM_FREQUENCY_DO2),
    (uint8_t*)(&app_regs.REG_PWM_FREQUENCY_DO3),
    (uint8_t*)(&app_regs.REG_PWM_DUTY_CYCLE_DO0),
    (uint8_t*)(&app_regs.REG_PWM_DUTY_CYCLE_DO1),
    (uint8_t*)(&app_regs.REG_PWM_DUTY_CYCLE_DO2),
    (uint8_t*)(&app_regs.REG_PWM_DUTY_CYCLE_DO3),
    (uint8_t*)(&app_regs.REG_PWM_START),
    (uint8_t*)(&app_regs.REG_PWM_STOP),
    (uint8_t*)(&app_regs.REG_RGB_ALL),
    (uint8_t*)(&app_regs.REG_RGB0),
    (uint8_t*)(&app_regs.REG_RGB1),
    (uint8_t*)(&app_regs.REG_LED0_CURRENT),
    (uint8_t*)(&app_regs.REG_LED1_CURRENT),
    (uint8_t*)(&app_regs.REG_LED0_MAX_CURRENT),
    (uint8_t*)(&app_regs.REG_LED1_MAX_CURRENT),
    (uint8_t*)(&app_regs.REG_EVENT_ENABLE),
    (uint8_t*)(&app_regs.REG_START_CAMERAS),
    (uint8_t*)(&app_regs.REG_STOP_CAMERAS),
    (uint8_t*)(&app_regs.REG_ENABLE_SERVOS),
    (uint8_t*)(&app_regs.REG_DISABLE_SERVOS),
    (uint8_t*)(&app_regs.REG_ENABLE_ENCODERS),
    (uint8_t*)(&app_regs.REG_ENCODER_MODE),
    (uint8_t*)(&app_regs.REG_RESERVED2),
    (uint8_t*)(&app_regs.REG_RESERVED3),
    (uint8_t*)(&app_regs.REG_RESERVED4),
    (uint8_t*)(&app_regs.REG_RESERVED5),
    (uint8_t*)(&app_regs.REG_RESERVED6),
    (uint8_t*)(&app_regs.REG_RESERVED7),
    (uint8_t*)(&app_regs.REG_RESERVED8),
    (uint8_t*)(&app_regs.REG_RESERVED9),
    (uint8_t*)(&app_regs.REG_CAMERA0_FRAME),
    (uint8_t*)(&app_regs.REG_CAMERA0_FREQUENCY),
    (uint8_t*)(&app_regs.REG_CAMERA1_FRAME),
    (uint8_t*)(&app_regs.REG_CAMERA1_FREQUENCY),
    (uint8_t*)(&app_regs.REG_RESERVED10),
    (uint8_t*)(&app_regs.REG_RESERVED11),
    (uint8_t*)(&app_regs.REG_RESERVED12),
    (uint8_t*)(&app_regs.REG_RESERVED13),
    (uint8_t*)(&app_regs.REG_SERVO_MOTOR2_PERIOD),
    (uint8_t*)(&app_regs.REG_SERVO_MOTOR2_PULSE),
    (uint8_t*)(&app_regs.REG_SERVO_MOTOR3_PERIOD),
    (uint8_t*)(&app_regs.REG_SERVO_MOTOR3_PULSE),
    (uint8_t*)(&app_regs.REG_RESERVED14),
    (uint8_t*)(&app_regs.REG_RESERVED15),
    (uint8_t*)(&app_regs.REG_RESERVED16),
    (uint8_t*)(&app_regs.REG_RESERVED17),
    (uint8_t*)(&app_regs.REG_ENCODER_RESET),
    (uint8_t*)(&app_regs.REG_RESERVED18),
    (uint8_t*)(&app_regs.REG_ENABLE_SERIAL_TIMESTAMP),
    (uint8_t*)(&app_regs.REG_MIMIC_PORT0_IR),
    (uint8_t*)(&app_regs.REG_MIMIC_PORT1_IR),
    (uint8_t*)(&app_regs.REG_MIMIC_PORT2_IR),
    (uint8_t*)(&app_regs.REG_RESERVED20),
    (uint8_t*)(&app_regs.REG_RESERVED21),
    (uint8_t*)(&app_regs.REG_RESERVED22),
    (uint8_t*)(&app_regs.REG_MIMIC_PORT0_VALVE),
    (uint8_t*)(&app_regs.REG_MIMIC_PORT1_VALVE),
    (uint8_t*)(&app_regs.REG_MIMIC_PORT2_VALVE),
    (uint8_t*)(&app_regs.REG_RESERVED23),
    (uint8_t*)(&app_regs.REG_RESERVED24),
    (uint8_t*)(&app_regs.REG_POKE_INPUT_FILTER)
};
