harp-tech/device.behavior/Firmware/Behavior/app_funcs.h

#ifndef _APP_FUNCTIONS_H_
#define _APP_FUNCTIONS_H_
#include <avr/io.h>


/************************************************************************/
/* Define if not defined                                                */
/************************************************************************/
#ifndef bool
	#define bool uint8_t
#endif
#ifndef true
	#define true 1
#endif
#ifndef false
	#define false 0
#endif


/************************************************************************/
/* Prototypes                                                           */
/************************************************************************/
void app_read_REG_PORT_DIS(void);
void app_read_REG_RESERVED0(void);
void app_read_REG_OUTPUTS_SET(void);
void app_read_REG_OUTPUTS_CLEAR(void);
void app_read_REG_OUTPUTS_TOGGLE(void);
void app_read_REG_OUTPUTS_OUT(void);
void app_read_REG_PORT_DIOS_SET(void);
void app_read_REG_PORT_DIOS_CLEAR(void);
void app_read_REG_PORT_DIOS_TOGGLE(void);
void app_read_REG_PORT_DIOS_OUT(void);
void app_read_REG_PORT_DIOS_CONF(void);
void app_read_REG_PORT_DIOS_IN(void);
void app_read_REG_DATA(void);
void app_read_REG_OUTPUT_PULSE_EN(void);
void app_read_REG_PULSE_PORT0_DO(void);
void app_read_REG_PULSE_PORT1_DO(void);
void app_read_REG_PULSE_PORT2_DO(void);
void app_read_REG_PULSE_PORT0_12V(void);
void app_read_REG_PULSE_PORT1_12V(void);
void app_read_REG_PULSE_PORT2_12V(void);
void app_read_REG_PULSE_LED0(void);
void app_read_REG_PULSE_LED1(void);
void app_read_REG_PULSE_RGB0(void);
void app_read_REG_PULSE_RGB1(void);
void app_read_REG_PULSE_DO0(void);
void app_read_REG_PULSE_DO1(void);
void app_read_REG_PULSE_DO2(void);
void app_read_REG_PULSE_DO3(void);
void app_read_REG_FREQ_DO0(void);
void app_read_REG_FREQ_DO1(void);
void app_read_REG_FREQ_DO2(void);
void app_read_REG_FREQ_DO3(void);
void app_read_REG_DCYCLE_DO0(void);
void app_read_REG_DCYCLE_DO1(void);
void app_read_REG_DCYCLE_DO2(void);
void app_read_REG_DCYCLE_DO3(void);
void app_read_REG_PWM_START(void);
void app_read_REG_PWM_STOP(void);
void app_read_REG_RGBS(void);
void app_read_REG_RGB0(void);
void app_read_REG_RGB1(void);
void app_read_REG_LED0_CURRENT(void);
void app_read_REG_LED1_CURRENT(void);
void app_read_REG_LED0_MAX_CURRENT(void);
void app_read_REG_LED1_MAX_CURRENT(void);
void app_read_REG_EVNT_ENABLE(void);
void app_read_REG_START_CAMERAS(void);
void app_read_REG_STOP_CAMERAS(void);
void app_read_REG_EN_SERVOS(void);
void app_read_REG_DIS_SERVOS(void);
void app_read_REG_EN_ENCODERS(void);
void app_read_REG_CONF_ENCODERS(void);
void app_read_REG_RESERVED2(void);
void app_read_REG_RESERVED3(void);
void app_read_REG_RESERVED4(void);
void app_read_REG_RESERVED5(void);
void app_read_REG_RESERVED6(void);
void app_read_REG_RESERVED7(void);
void app_read_REG_RESERVED8(void);
void app_read_REG_RESERVED9(void);
void app_read_REG_CAM_OUT0_FRAME_ACQUIRED(void);
void app_read_REG_CAM_OUT0_FREQ(void);
void app_read_REG_CAM_OUT1_FRAME_ACQUIRED(void);
void app_read_REG_CAM_OUT1_FREQ(void);
void app_read_REG_RESERVED10(void);
void app_read_REG_RESERVED11(void);
void app_read_REG_RESERVED12(void);
void app_read_REG_RESERVED13(void);
void app_read_REG_MOTOR_OUT2_PERIOD(void);
void app_read_REG_MOTOR_OUT2_PULSE(void);
void app_read_REG_MOTOR_OUT3_PERIOD(void);
void app_read_REG_MOTOR_OUT3_PULSE(void);
void app_read_REG_RESERVED14(void);
void app_read_REG_RESERVED15(void);
void app_read_REG_RESERVED16(void);
void app_read_REG_RESERVED17(void);
void app_read_REG_ENCODERS_RESET(void);
void app_read_REG_RESERVED18(void);
void app_read_REG_ENABLE_SERIAL_TIMESTAMP(void);
void app_read_REG_MIMIC_PORT0_IR(void);
void app_read_REG_MIMIC_PORT1_IR(void);
void app_read_REG_MIMIC_PORT2_IR(void);
void app_read_REG_RESERVED20(void);
void app_read_REG_RESERVED21(void);
void app_read_REG_RESERVED22(void);
void app_read_REG_MIMIC_PORT0_VALVE(void);
void app_read_REG_MIMIC_PORT1_VALVE(void);
void app_read_REG_MIMIC_PORT2_VALVE(void);
void app_read_REG_RESERVED23(void);
void app_read_REG_RESERVED24(void);
void app_read_REG_POKE_INPUT_FILTER_MS(void);


bool app_write_REG_PORT_DIS(void *a);
bool app_write_REG_RESERVED0(void *a);
bool app_write_REG_OUTPUTS_SET(void *a);
bool app_write_REG_OUTPUTS_CLEAR(void *a);
bool app_write_REG_OUTPUTS_TOGGLE(void *a);
bool app_write_REG_OUTPUTS_OUT(void *a);
bool app_write_REG_PORT_DIOS_SET(void *a);
bool app_write_REG_PORT_DIOS_CLEAR(void *a);
bool app_write_REG_PORT_DIOS_TOGGLE(void *a);
bool app_write_REG_PORT_DIOS_OUT(void *a);
bool app_write_REG_PORT_DIOS_CONF(void *a);
bool app_write_REG_PORT_DIOS_IN(void *a);
bool app_write_REG_DATA(void *a);
bool app_write_REG_OUTPUT_PULSE_EN(void *a);
bool app_write_REG_PULSE_PORT0_DO(void *a);
bool app_write_REG_PULSE_PORT1_DO(void *a);
bool app_write_REG_PULSE_PORT2_DO(void *a);
bool app_write_REG_PULSE_PORT0_12V(void *a);
bool app_write_REG_PULSE_PORT1_12V(void *a);
bool app_write_REG_PULSE_PORT2_12V(void *a);
bool app_write_REG_PULSE_LED0(void *a);
bool app_write_REG_PULSE_LED1(void *a);
bool app_write_REG_PULSE_RGB0(void *a);
bool app_write_REG_PULSE_RGB1(void *a);
bool app_write_REG_PULSE_DO0(void *a);
bool app_write_REG_PULSE_DO1(void *a);
bool app_write_REG_PULSE_DO2(void *a);
bool app_write_REG_PULSE_DO3(void *a);
bool app_write_REG_FREQ_DO0(void *a);
bool app_write_REG_FREQ_DO1(void *a);
bool app_write_REG_FREQ_DO2(void *a);
bool app_write_REG_FREQ_DO3(void *a);
bool app_write_REG_DCYCLE_DO0(void *a);
bool app_write_REG_DCYCLE_DO1(void *a);
bool app_write_REG_DCYCLE_DO2(void *a);
bool app_write_REG_DCYCLE_DO3(void *a);
bool app_write_REG_PWM_START(void *a);
bool app_write_REG_PWM_STOP(void *a);
bool app_write_REG_RGBS(void *a);
bool app_write_REG_RGB0(void *a);
bool app_write_REG_RGB1(void *a);
bool app_write_REG_LED0_CURRENT(void *a);
bool app_write_REG_LED1_CURRENT(void *a);
bool app_write_REG_LED0_MAX_CURRENT(void *a);
bool app_write_REG_LED1_MAX_CURRENT(void *a);
bool app_write_REG_EVNT_ENABLE(void *a);
bool app_write_REG_START_CAMERAS(void *a);
bool app_write_REG_STOP_CAMERAS(void *a);
bool app_write_REG_EN_SERVOS(void *a);
bool app_write_REG_DIS_SERVOS(void *a);
bool app_write_REG_EN_ENCODERS(void *a);
bool app_write_REG_CONF_ENCODERS(void *a);
bool app_write_REG_RESERVED2(void *a);
bool app_write_REG_RESERVED3(void *a);
bool app_write_REG_RESERVED4(void *a);
bool app_write_REG_RESERVED5(void *a);
bool app_write_REG_RESERVED6(void *a);
bool app_write_REG_RESERVED7(void *a);
bool app_write_REG_RESERVED8(void *a);
bool app_write_REG_RESERVED9(void *a);
bool app_write_REG_CAM_OUT0_FRAME_ACQUIRED(void *a);
bool app_write_REG_CAM_OUT0_FREQ(void *a);
bool app_write_REG_CAM_OUT1_FRAME_ACQUIRED(void *a);
bool app_write_REG_CAM_OUT1_FREQ(void *a);
bool app_write_REG_RESERVED10(void *a);
bool app_write_REG_RESERVED11(void *a);
bool app_write_REG_RESERVED12(void *a);
bool app_write_REG_RESERVED13(void *a);
bool app_write_REG_MOTOR_OUT2_PERIOD(void *a);
bool app_write_REG_MOTOR_OUT2_PULSE(void *a);
bool app_write_REG_MOTOR_OUT3_PERIOD(void *a);
bool app_write_REG_MOTOR_OUT3_PULSE(void *a);
bool app_write_REG_RESERVED14(void *a);
bool app_write_REG_RESERVED15(void *a);
bool app_write_REG_RESERVED16(void *a);
bool app_write_REG_RESERVED17(void *a);
bool app_write_REG_ENCODERS_RESET(void *a);
bool app_write_REG_RESERVED18(void *a);
bool app_write_REG_ENABLE_SERIAL_TIMESTAMP(void *a);
bool app_write_REG_MIMIC_PORT0_IR(void *a);
bool app_write_REG_MIMIC_PORT1_IR(void *a);
bool app_write_REG_MIMIC_PORT2_IR(void *a);
bool app_write_REG_RESERVED20(void *a);
bool app_write_REG_RESERVED21(void *a);
bool app_write_REG_RESERVED22(void *a);
bool app_write_REG_MIMIC_PORT0_VALVE(void *a);
bool app_write_REG_MIMIC_PORT1_VALVE(void *a);
bool app_write_REG_MIMIC_PORT2_VALVE(void *a);
bool app_write_REG_RESERVED23(void *a);
bool app_write_REG_RESERVED24(void *a);
bool app_write_REG_POKE_INPUT_FILTER_MS(void *a);


#endif /* _APP_FUNCTIONS_H_ */
