harp-tech/device.behavior/(commit log)

2017-11-23 Added first files.
    [registers.xls]
2017-11-24 Added DAC, ADC and RGB initialization code.
2017-11-24 Added POKE_IN code, renamed a register to RESERVED0 and first code for DAC/LED current.
    [registers.xls]
2017-11-24 Added interrupts for POKE_IN -- infrared beams.
2017-11-24 Included files for WS2812S RGB LEDs.
2017-11-24 Negated LEDs transistor drive and added new bit to be used on register PWM_START.
    [registers.xls]
2017-11-24 Added pulse functionality, shutdown in case of error, correct DAC initialization, changed some register defaults and added some register initializations.
    [app.c]
2017-11-24 Minor changes on file registers.xls.
    [registers.xls]
2017-11-25 Fixed the ADC conversion.
    [app.c]
2017-11-25 Increased ADC stabilization time before measuring offset from 5 us to 100 us (doesn't have impact on the offset value).
    [app.c]
2018-01-11 Updated to Atxmega Harp core version 1.1.
    [registers.xls]
2018-01-17 Fixed Rgbs issue where the high level interrupts were interrupting the RGB bus and creating erroneous colors. Note: Not sure if completely fixed -- the Clock Sync's uart can still create interruption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
    [app_funcs.c]
2018-02-23 Added new registers and implemented quadrature encoder register's code.
    [registers.xls]
2018-03-01 Implemented 3 new features (camera controller, quadrature counter, servo motor controller) and renamed/removed some registers.
    [registers.xls]
2018-03-02 Deleted the register DIS_ENCODERS.
    [registers.xls]
2018-03-02 Fixed issue that was creating a bad frequency when updating the frequency registeres during PWM execution.
    [interrupts.c]
2018-03-02 Fixed issue. The stop pwm of channel 1, 2 and 3 was not operational.
    [app_funcs.c]
2018-03-02 Fixed issue that was turning the cameras off after the pulse period.
    [app.c]
2018-03-04 Increased lower limit of the camera frequency to 2 Hz (1 Hz was not working properly).
    [app_funcs.c]
2018-03-04 Corrected return values when writing to some registers.
    [app_funcs.c]
2018-03-04 Added new feature: servo motor is enabled when the pwm pulse registers are updated.
2018-03-04 Removed the feature that were enabling the servo when writing to the servo pulse registers.
2018-03-04 Removed old ADC register from the default values list.
2018-03-14 Corrected issue: when stopping the camera triggering, the last pulse was not correct.
    [app_funcs.c, interrupts.c]
2018-04-27 Added filter to the PORTx digital inputs.
2019-01-10 Correct events from cameras triggering.
    [app.c, interrupts.c]
2019-02-06 Updated to core version 1.5 and use new ADC routines for the analog reading.
2019-12-04 Added ability to mimic the infrared beams and valves into the outputs.
    [registers.xls]
2020-05-24 Added fabrication files.
    [Pokes-pinouts.xlsx, harp behavior poke port breakout v1.1.brd, harp behavior poke port breakout v1.1.sch, harp behavior poke port breakout v1.1.xlsx, harp behavior poke port breakout v1.1_centroid.csv, harp behavior poke port breakout v1.1_simplified.xlsx, harp behavior v1.2.brd, harp behavior v1.2.sch]
2020-06-07 Added the 3D designs for the mice poke.
    [Poke_Mice_1.STL]
2022-01-22 Implemented a low-pass filter for the Pokes' digital input
    [registers.xls]
2022-03-17 Upadate registers.xls with new input filter register and update metadata
    [registers.xls]
2022-03-17 Add low pass filter register missing on app_funcs.h from previous release (v2.6)
    [app_funcs.h]
2022-03-17 Configure pokes DIOs as inputs, add respective events and increase version
    [registers.xls]
2022-05-20 Added ability to calculate ADC offset and read ADC1.
    The devices is now able to calculate its own ADC offset and apply it to ADC readings.
    ADC readings are now handled by interrupts.
    Reading of ADC1 is done for hardware version 2.0.
    [registers.xls]
2022-05-26 Implemented digital input DI3 on firmware.
    [registers.xls]
2022-07-01 Harp behavior v2.0 hardware CAD files
    [harp behavior v2.0.brd, harp behavior v2.0.sch]
2022-07-01 Revert "Harp behavior v2.0 hardware CAD files"
    This reverts commit b7fb75ff22a1f2c396da8856b179b4330b59d1a1.
    [harp behavior v2.0.brd, harp behavior v2.0.sch]
2022-07-01 Harp behavior v2.0 CAD files
    [harp behavior v2.0.brd, harp behavior v2.0.sch]
2022-09-13 Added a new event, when the last trigger is sent to the camera.
2022-09-16 Correct files added
    [harp behavior v1.2_BOM.xlsx]
2022-09-16 Organize folders and add peripheral boards
    [Poke_Mice_1.STL, Pokes-pinouts.xlsx, harp behavior encoder v1.0.brd, harp behavior encoder v1.0.sch, harp behavior encoder v1.0_BOM.xlsx, harp behavior encoder v1.2.brd, harp behavior encoder v1.2.sch, harp behavior encoder v1.2_BOM.xlsx]
2022-09-21 Organized files for PCB version 1.2.
    [Poke_Mice_1.STL, Pokes-pinouts.xlsx, harp behavior poke port breakout v1.1.brd, harp behavior poke port breakout v1.1.sch, harp behavior poke port breakout v1.1.xlsx, harp behavior poke port breakout v1.1_centroid.csv, harp behavior poke port breakout v1.1_simplified.xlsx, harp behavior.brd]
2022-09-21 Added the available peripherals.
    [Mouse_Poke_Round_V1.STL, Mouse_Poke_Round_V1_2.STL, harp behavior encoder v1.0.brd, harp behavior encoder v1.0.sch, harp behavior encoder v1.0_BOM.xlsx, harp behavior encoder v1.2.brd, harp behavior encoder v1.2.sch, harp behavior encoder v1.2_BOM.xlsx]
2022-09-21 Added PCB version 2.0.
    [harp behavior.brd, harp behavior.sch, harp behavior_BOM.xlsx, harp behavior_BOM_simplified.xlsx, harp behavior_centroid.csv]
2022-09-22 Added device's photo.
2022-10-05 Added port breakout v2.0.
    [harp behavior poke port breakout v2.0.brd, harp behavior poke port breakout v2.0.sch, harp behavior poke port breakout v2.0_BOM.xlsx]
2022-10-05 Minor corrections.
    [harp behavior_BOM.xlsx]
2022-10-05 Added production files.
    [harp behavior poke port breakout v2.0_BOM_to_order.xlsx]
2022-10-06 Added ability to stop cameras when going to standby mode.
2022-11-25 Added port breakout v2.1.
    [harp behavior poke port breakout v2.1.brd, harp behavior poke port breakout v2.1.sch, harp behavior poke port breakout v2.1_BOM.xlsx]
2022-11-30 Added BOM for v2.0 and updated CONTRIB file
    [harp behavior v2.0_BOM.xlsx]
2022-12-09 Updated port breakout v2.1
    [harp behavior poke port breakout v2.1_BOM.xlsx]
2022-12-23 refactor repository structure
    [harp behavior v1.2.brd, harp behavior v1.2.sch, harp behavior v1.2_BOM.xlsx, harp behavior v2.0.brd, harp behavior v2.0.sch, harp behavior v2.0_BOM.xlsx]
2022-12-27 Organized files for PCB version 2.0.
    [harp behavior.brd, harp behavior.sch, harp behavior_BOM.xlsx, harp behavior_BOM_simplified.xlsx, harp behavior_centroid.csv]
2022-12-27 Created registers and control bits.
    [registers.xls]
2022-12-27 Implemented the new functionality.
    Implements the ability to send the current timestamp over serial on Port 2, using the Valve line.
2023-03-23 Add prototype device schema and interface
2023-03-27 Regenerate high-level device interface
2023-06-06 Add second ADC channel to schema
2023-06-06 Update `Device` class to the new schema
2023-06-07 Update `Device` class
2023-06-28 Fix register mask reference
    [device.yml]
2023-08-10 Replaced harp core 1.11 with 1.13.
    [app.c, hwbp_core.h]
2023-08-31 Created new register EncoderMode.
    [registers.xls]
2023-09-18 Change encoder mode register and mask name
2023-11-19 Update interface to emit new encoder mode register
2024-05-02 Document `Event` access for CameraStop register
2024-09-29 Fix register access description
    [device.yml]
2024-11-01 Include device metadata file as embedded resource
2024-11-07 Update device schema URL
2024-11-07 Update generators to use embedded device metadata
2025-05-24 Add README file to device package
2025-09-03 Fix read digital inputs function on firmware
    [app_funcs.c]
2025-10-24 Update fw version device.yml (#34)
2026-10-24 Add licensing map and relicense documentation (#48)
    Documentation content is relicensed under CC BY-SA 4.0, matching the
    harp-tech documentation site, and code in the docs folder, including
    the example workflows and the build scripts, is licensed under MIT.
    The site footer states the content license.
    The root license lists the licenses that apply to each folder and
    licenses everything else under MIT, including device.yml and the build
    configuration. The firmware license gains the harp-tech and
    Contributors copyright line, matching the ATxmega core license, and
    the docs README refers to the root license.
2026-10-31 Add device docs website (#40)
    Add a user guide for the Behavior device covering specs and
    peripherals, ports and connections, software installation, first steps
    with the GUI and Bonsai, data logging and troubleshooting. Example
    articles show how to use each functional group of registers in Bonsai,
    with copyable workflows.
    Add overlay pages that attach these examples to the generated register
    and payload reference, together with a register table for the device.
2026-11-06 Upgrade toolkit and prepare the device template (#49)
    The firmware headers and the .NET and Python interfaces are
    regenerated with harp.toolkit 0.5.1, with register defaults that match
    the firmware reset values and descriptions for every mask member.
    The Reference section of the docs site is built from register pages
    generated from device.yml, with a Python API reference generated from
    the package sources. The installation guide installs the GUI as a
    .NET tool and the Python interface from harp-behavior.
    NuGet packages are published with trusted publishing, every publish
    job waits for all builds, and firmware is also built for hardware 2.1.
    The editor settings, ignore files and firmware Ma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
2026-11-06 Update app screenshot and reorder installation tabs (#50)
    The app screenshot is replaced with one of the current app, which shows
    the Harp logo and the version of the upcoming release. The installation
    tabs are reordered to follow the table of contents, with the app first,
    then Bonsai and Python. The app is called the Behavior app throughout,
    and its page and screenshot are renamed to match.
2026-11-06 Fix RGB write handlers and DIO mimic outputs (#52)
    A write to any of the three RGB registers now updates the others to
    match, so every write updates the LEDs. The payload is kept in the
    green, red, blue order declared by the device interface, which is also
    the order stored in the registers and sent to the LEDs. The
    documentation note about the swapped channels is removed.
    A DIO line selected as a mimic output is configured as an output
    instead of the infrared input of the same port. The documentation
    warning about mimic outputs is removed.
    Closes #41
    Closes #42
    Closes #44
2026-11-06 Declare firmware bounds for frequency registers (#53)
    The camera trigger frequencies are declared with a minimum of 2 Hz and
    the PWM frequencies with a maximum of 10 kHz, the bounds already
    enforced by the firmware.
    The whitespace normalization commit is listed in a new
    .git-blame-ignore-revs file.
    Closes #45
    Closes #25
2026-11-06 Open the app on a fixed port and report errors (#54)
    The port passed with --port is connected on startup, and port selection
    is disabled. Connection errors, including a device disconnected while
    in use, are reported in a dialog.
    The window title, the macOS menu, the About dialog, the package
    description and the README now all refer to the Harp Behavior app.
2026-11-12 Prepare docs and repository for the 3.4.0 release (#57)
    The documentation is updated for release 3.4.0. Article names and links
    are made the same across device repositories, the README is reduced to
    a short overview, and firmware updates are documented with the Harp
    Toolkit.
    The repository files follow the device template, and harp.toolkit is
    updated to 0.6.1. The docs build uses the latest harp-docfx.
